siglabsoss/copper-suicide/docs/copper_suicide_notes.txt

soft start on VCCAUX (not exceed 30mV/us)

VCCIO supplies should be powered-up before or together with the VCC and VCCAUX supplies

what is the maximum current for vcc, vccaux, vccio???

---------------------
Copper Suicide R11 error
---------------------

- don't need 128 leds
- don't need 17 oscillators (~$40!!)

soft reset
hard reset
clock

config fpga needs SPI flash
