siglabsoss/copper-suicide/docs/ecp5u85pinouts.xlsx

Pin/Ball Function | Bank | Dual Function | Differential | High Speed | DQS | CABGA756
PL11A | 7 | ULC_GPLL0T_IN | True_OF_PL11B | TRUE | LDQ17 | C5
PL11B | 7 | ULC_GPLL0C_IN | Comp_OF_PL11A | TRUE | LDQ17 | D5
PL11C | 7 | - | True_OF_PL11D | - | LDQ17 | C4
PL11D | 7 | - | Comp_OF_PL11C | - | LDQ17 | C3
PL14A | 7 | - | True_OF_PL14B | TRUE | LDQ17 | D4
PL14C | 7 | - | True_OF_PL14D | - | LDQ17 | F4
PL14B | 7 | - | Comp_OF_PL14A | TRUE | LDQ17 | E4
PL14D | 7 | - | Comp_OF_PL14C | - | LDQ17 | F5
PL17A | 7 | - | True_OF_PL17B | TRUE | LDQS17 | B1
PL17C | 7 | - | True_OF_PL17D | - | LDQ17 | D3
PL17B | 7 | - | Comp_OF_PL17A | TRUE | LDQSN17 | C2
PL17D | 7 | - | Comp_OF_PL17C | - | LDQ17 | D2
PL20A | 7 | - | True_OF_PL20B | TRUE | LDQ17 | F3
PL20C | 7 | - | True_OF_PL20D | - | LDQ17 | C1
PL20B | 7 | - | Comp_OF_PL20A | TRUE | LDQ17 | E3
PL20D | 7 | - | Comp_OF_PL20C | - | LDQ17 | D1
PL23A | 7 | - | True_OF_PL23B | TRUE | LDQ29 | F2
PL23C | 7 | - | True_OF_PL23D | - | LDQ29 | F1
PL23B | 7 | - | Comp_OF_PL23A | TRUE | LDQ29 | E1
PL23D | 7 | - | Comp_OF_PL23C | - | LDQ29 | H1
PL26A | 7 | - | True_OF_PL26B | TRUE | LDQ29 | H2
PL26C | 7 | - | True_OF_PL26D | - | LDQ29 | J3
PL26B | 7 | - | Comp_OF_PL26A | TRUE | LDQ29 | H3
PL26D | 7 | - | Comp_OF_PL26C | - | LDQ29 | K3
PL29A | 7 | - | True_OF_PL29B | TRUE | LDQS29 | K2
PL29C | 7 | - | True_OF_PL29D | - | LDQ29 | K1
PL29B | 7 | - | Comp_OF_PL29A | TRUE | LDQSN29 | J1
PL29D | 7 | - | Comp_OF_PL29C | - | LDQ29 | L1
PL32A | 7 | - | True_OF_PL32B | TRUE | LDQ29 | L2
PL32C | 7 | - | True_OF_PL32D | - | LDQ29 | J4
PL32B | 7 | - | Comp_OF_PL32A | TRUE | LDQ29 | L3
PL32D | 7 | - | Comp_OF_PL32C | - | LDQ29 | K4
PL35A | 7 | - | True_OF_PL35B | TRUE | LDQ41 | H6
PL35C | 7 | VREF1_7 | True_OF_PL35D | - | LDQ41 | J7
PL35B | 7 | - | Comp_OF_PL35A | TRUE | LDQ41 | H5
PL35D | 7 | - | Comp_OF_PL35C | - | LDQ41 | J6
PL38A | 7 | - | True_OF_PL38B | TRUE | LDQ41 | K6
PL38C | 7 | - | True_OF_PL38D | - | LDQ41 | K5
PL38B | 7 | - | Comp_OF_PL38A | TRUE | LDQ41 | K7
PL38D | 7 | - | Comp_OF_PL38C | - | LDQ41 | L4
PL41A | 7 | GR_PCLK7_1 | True_OF_PL41B | TRUE | LDQS41 | N3
PL41C | 7 | GR_PCLK7_0 | True_OF_PL41D | - | LDQ41 | L7
PL41B | 7 | - | Comp_OF_PL41A | TRUE | LDQSN41 | N4
PL41D | 7 | - | Comp_OF_PL41C | - | LDQ41 | L6
PL44A | 7 | PCLKT7_1 | True_OF_PL44B | TRUE | LDQ41 | N6
PL44C | 7 | PCLKT7_0 | True_OF_PL44D | - | LDQ41 | P6
PL44B | 7 | PCLKC7_1 | Comp_OF_PL44A | TRUE | LDQ41 | N7
PL44D | 7 | PCLKC7_0 | Comp_OF_PL44C | - | LDQ41 | P7
PL47A | 6 | PCLKT6_1 | True_OF_PL47B | TRUE | LDQ53 | P5
PL47C | 6 | PCLKT6_0 | True_OF_PL47D | - | LDQ53 | R7
PL47B | 6 | PCLKC6_1 | Comp_OF_PL47A | TRUE | LDQ53 | P4
PL47D | 6 | PCLKC6_0 | Comp_OF_PL47C | - | LDQ53 | T7
PL50A | 6 | GR_PCLK6_0 | True_OF_PL50B | TRUE | LDQ53 | R6
PL50C | 6 | GR_PCLK6_1 | True_OF_PL50D | - | LDQ53 | U6
PL50B | 6 | - | Comp_OF_PL50A | TRUE | LDQ53 | T6
PL50D | 6 | - | Comp_OF_PL50C | - | LDQ53 | U7
PL53A | 6 | - | True_OF_PL53B | TRUE | LDQS53 | R4
PL53C | 6 | - | True_OF_PL53D | - | LDQ53 | T4
PL53B | 6 | - | Comp_OF_PL53A | TRUE | LDQSN53 | T5
PL53D | 6 | - | Comp_OF_PL53C | - | LDQ53 | U5
PL56A | 6 | - | True_OF_PL56B | TRUE | LDQ53 | U4
PL56C | 6 | - | True_OF_PL56D | - | LDQ53 | V6
PL56B | 6 | VREF1_6 | Comp_OF_PL56A | TRUE | LDQ53 | V4
PL56D | 6 | - | Comp_OF_PL56C | - | LDQ53 | V7
PL59A | 6 | - | True_OF_PL59B | TRUE | LDQ65 | P2
PL59C | 6 | - | True_OF_PL59D | - | LDQ65 | R3
PL59B | 6 | - | Comp_OF_PL59A | TRUE | LDQ65 | P3
PL59D | 6 | - | Comp_OF_PL59C | - | LDQ65 | T3
PL62A | 6 | - | True_OF_PL62B | TRUE | LDQ65 | N1
PL62C | 6 | - | True_OF_PL62D | - | LDQ65 | U2
PL62B | 6 | - | Comp_OF_PL62A | TRUE | LDQ65 | P1
PL62D | 6 | - | Comp_OF_PL62C | - | LDQ65 | U3
PL65A | 6 | - | True_OF_PL65B | TRUE | LDQS65 | R1
PL65C | 6 | - | True_OF_PL65D | - | LDQ65 | W3
PL65B | 6 | - | Comp_OF_PL65A | TRUE | LDQSN65 | T2
PL65D | 6 | - | Comp_OF_PL65C | - | LDQ65 | Y3
PL68A | 6 | - | True_OF_PL68B | TRUE | LDQ65 | T1
PL68C | 6 | - | True_OF_PL68D | - | LDQ65 | V1
PL68B | 6 | - | Comp_OF_PL68A | TRUE | LDQ65 | U1
PL68D | 6 | - | Comp_OF_PL68C | - | LDQ65 | W1
PL71A | 6 | - | True_OF_PL71B | TRUE | LDQ77 | Y7
PL71C | 6 | - | True_OF_PL71D | - | LDQ77 | Y5
PL71B | 6 | - | Comp_OF_PL71A | TRUE | LDQ77 | Y6
PL71D | 6 | - | Comp_OF_PL71C | - | LDQ77 | W5
PL74A | 6 | - | True_OF_PL74B | TRUE | LDQ77 | Y4
PL74C | 6 | - | True_OF_PL74D | - | LDQ77 | AB7
PL74B | 6 | - | Comp_OF_PL74A | TRUE | LDQ77 | W4
PL74D | 6 | - | Comp_OF_PL74C | - | LDQ77 | AC6
PL77A | 6 | - | True_OF_PL77B | TRUE | LDQS77 | AB5
PL77C | 6 | - | True_OF_PL77D | - | LDQ77 | AC7
PL77B | 6 | - | Comp_OF_PL77A | TRUE | LDQSN77 | AB6
PL77D | 6 | - | Comp_OF_PL77C | - | LDQ77 | AD7
PL80A | 6 | - | True_OF_PL80B | TRUE | LDQ77 | AD6
PL80C | 6 | - | True_OF_PL80D | - | LDQ77 | AE5
PL80B | 6 | - | Comp_OF_PL80A | TRUE | LDQ77 | AE6
PL80D | 6 | - | Comp_OF_PL80C | - | LDQ77 | AE4
PL83A | 6 | - | True_OF_PL83B | TRUE | LDQ89 | AB3
PL83C | 6 | - | True_OF_PL83D | - | LDQ89 | AC5
PL83B | 6 | - | Comp_OF_PL83A | TRUE | LDQ89 | AB4
PL83D | 6 | - | Comp_OF_PL83C | - | LDQ89 | AD4
PL86A | 6 | - | True_OF_PL86B | TRUE | LDQ89 | W2
PL86C | 6 | - | True_OF_PL86D | - | LDQ89 | AD3
PL86B | 6 | - | Comp_OF_PL86A | TRUE | LDQ89 | Y1
PL86D | 6 | - | Comp_OF_PL86C | - | LDQ89 | AE3
PL89A | 6 | - | True_OF_PL89B | TRUE | LDQS89 | AC3
PL89C | 6 | - | True_OF_PL89D | - | LDQ89 | AC2
PL89B | 6 | - | Comp_OF_PL89A | TRUE | LDQSN89 | AB2
PL89D | 6 | - | Comp_OF_PL89C | - | LDQ89 | AE2
PL92A | 6 | - | True_OF_PL92B | TRUE | LDQ89 | AB1
PL92B | 6 | - | Comp_OF_PL92A | TRUE | LDQ89 | AC1
PL92C | 6 | LLC_GPLL0T_IN | True_OF_PL92D | - | LDQ89 | AD1
PL92D | 6 | LLC_GPLL0C_IN | Comp_OF_PL92C | - | LDQ89 | AE1
PB4A | 8 | D7/IO7 | True_OF_PB4B | - | - | AG1
PB6A | 8 | D5/MISO2/IO5 | True_OF_PB6B | - | - | AJ1
PB4B | 8 | D6/IO6 | Comp_OF_PB4A | - | - | AH1
PB6B | 8 | D4/MOSI2/IO4 | Comp_OF_PB6A | - | - | AK1
PB9A | 8 | D3/IO3 | True_OF_PB9B | - | - | AL1
PB11A | 8 | D1/MISO/IO1 | True_OF_PB11B | - | - | AJ2
PB9B | 8 | D2/IO2 | Comp_OF_PB9A | - | - | AM2
PB11B | 8 | D0/MOSI/IO0 | Comp_OF_PB11A | - | - | AK2
PB13A | 8 | SN/CSN | True_OF_PB13B | - | - | AG3
PB15A | 8 | HOLDN/DI/BUSY/CSSPIN/CEN | True_OF_PB15B | - | - | AJ3
PB13B | 8 | CS1N | Comp_OF_PB13A | - | - | AH3
PB15B | 8 | DOUT/CSON | Comp_OF_PB15A | - | - | AK3
PB18A | 8 | WRITEN | - | - | - | AL3
INITN | 8 | - | - | - | - | AG4
CCLK | 8 | MCLK/SCK | - | - | - | AM3
PROGRAMN | 8 | - | - | - | - | AH4
DONE | 8 | - | - | - | - | AJ4
CFG_1 | 8 | - | - | - | - | AL4
CFG_2 | 8 | - | - | - | - | AK4
CFG_0 | 8 | - | - | - | - | AM4
TDO | 40 | - | - | - | - | AG5
TCK | 40 | - | - | - | - | AK5
TDI | 40 | - | - | - | - | AJ5
TMS | 40 | - | - | - | - | AM5
RESERVED | - | - | - | - | - | AK9
GND | - | - | - | - | - | AC13
RESERVED | - | - | - | - | - | AK10
GND | - | - | - | - | - | AM8
GND | - | - | - | - | - | AC14
GND | - | - | - | - | - | AM9
GND | - | - | - | - | - | AM11
GND | - | - | - | - | - | AC15
GND | - | - | - | - | - | AM12
RESERVED | - | - | - | - | - | AK12
GND | - | - | - | - | - | AC16
RESERVED | - | - | - | - | - | AK13
RESERVED | - | - | - | - | - | AK15
RESERVED | - | - | - | - | - | AK16
GND | - | - | - | - | - | AM14
GND | - | - | - | - | - | AM15
RESERVED | - | - | - | - | - | AK18
GND | - | - | - | - | - | AC17
RESERVED | - | - | - | - | - | AK19
GND | - | - | - | - | - | AM17
GND | - | - | - | - | - | AC18
GND | - | - | - | - | - | AM18
GND | - | - | - | - | - | AM20
GND | - | - | - | - | - | AC19
GND | - | - | - | - | - | AM21
RESERVED | - | - | - | - | - | AK21
GND | - | - | - | - | - | AC20
RESERVED | - | - | - | - | - | AK22
RESERVED | - | - | - | - | - | AK24
RESERVED | - | - | - | - | - | AK25
GND | - | - | - | - | - | AM23
GND | - | - | - | - | - | AM24
PB96A | 4 | - | True_OF_PB96B | - | - | AM28
PB98A | 4 | - | True_OF_PB98B | - | - | AL28
PB96B | 4 | - | Comp_OF_PB96A | - | - | AM29
PB98B | 4 | - | Comp_OF_PB98A | - | - | AK28
PB101A | 4 | - | True_OF_PB101B | - | - | AK32
PB103A | 4 | - | True_OF_PB103B | - | - | AM30
PB101B | 4 | - | Comp_OF_PB101A | - | - | AJ32
PB103B | 4 | - | Comp_OF_PB103A | - | - | AL30
PB105A | 4 | - | True_OF_PB105B | - | - | AK31
PB107A | 4 | - | True_OF_PB107B | - | - | AM31
PB105B | 4 | - | Comp_OF_PB105A | - | - | AJ31
PB107B | 4 | - | Comp_OF_PB107A | - | - | AL32
PB110A | 4 | - | True_OF_PB110B | - | - | AG28
PB112A | 4 | - | True_OF_PB112B | - | - | AJ28
PB110B | 4 | - | Comp_OF_PB110A | - | - | AG29
PB112B | 4 | - | Comp_OF_PB112A | - | - | AH28
PB114A | 4 | - | True_OF_PB114B | - | - | AH30
PB116A | 4 | - | True_OF_PB116B | - | - | AK29
PB114B | 4 | - | Comp_OF_PB114A | - | - | AG30
PB116B | 4 | - | Comp_OF_PB116A | - | - | AK30
PB119A | 4 | - | True_OF_PB119B | - | - | AH32
PB121A | 4 | - | True_OF_PB121B | - | - | AJ29
PB119B | 4 | - | Comp_OF_PB119A | - | - | AG32
PB121B | 4 | - | Comp_OF_PB121A | - | - | AJ30
PR92D | 3 | LRC_GPLL0C_IN | Comp_OF_PR92C | - | RDQ89 | AE32
PR92C | 3 | LRC_GPLL0T_IN | True_OF_PR92D | - | RDQ89 | AD32
PR92B | 3 | - | Comp_OF_PR92A | TRUE | RDQ89 | AC32
PR92A | 3 | - | True_OF_PR92B | TRUE | RDQ89 | AB32
PR89D | 3 | - | Comp_OF_PR89C | - | RDQ89 | AE31
PR89B | 3 | - | Comp_OF_PR89A | TRUE | RDQSN89 | AB31
PR89C | 3 | - | True_OF_PR89D | - | RDQ89 | AC31
PR89A | 3 | - | True_OF_PR89B | TRUE | RDQS89 | AC30
PR86D | 3 | - | Comp_OF_PR86C | - | RDQ89 | AE30
PR86B | 3 | - | Comp_OF_PR86A | TRUE | RDQ89 | Y32
PR86C | 3 | - | True_OF_PR86D | - | RDQ89 | AD30
PR86A | 3 | - | True_OF_PR86B | TRUE | RDQ89 | W31
PR83D | 3 | - | Comp_OF_PR83C | - | RDQ89 | AD29
PR83B | 3 | - | Comp_OF_PR83A | TRUE | RDQ89 | AB29
PR83C | 3 | - | True_OF_PR83D | - | RDQ89 | AC28
PR83A | 3 | - | True_OF_PR83B | TRUE | RDQ89 | AB30
PR80D | 3 | - | Comp_OF_PR80C | - | RDQ77 | AE29
PR80B | 3 | - | Comp_OF_PR80A | TRUE | RDQ77 | AE27
PR80C | 3 | - | True_OF_PR80D | - | RDQ77 | AE28
PR80A | 3 | - | True_OF_PR80B | TRUE | RDQ77 | AD27
PR77D | 3 | - | Comp_OF_PR77C | - | RDQ77 | AD26
PR77B | 3 | - | Comp_OF_PR77A | TRUE | RDQSN77 | AB27
PR77C | 3 | - | True_OF_PR77D | - | RDQ77 | AC26
PR77A | 3 | - | True_OF_PR77B | TRUE | RDQS77 | AB28
PR74D | 3 | - | Comp_OF_PR74C | - | RDQ77 | AC27
PR74B | 3 | - | Comp_OF_PR74A | TRUE | RDQ77 | W29
PR74C | 3 | - | True_OF_PR74D | - | RDQ77 | AB26
PR74A | 3 | - | True_OF_PR74B | TRUE | RDQ77 | Y29
PR71D | 3 | - | Comp_OF_PR71C | - | RDQ77 | W28
PR71B | 3 | - | Comp_OF_PR71A | TRUE | RDQ77 | Y27
PR71C | 3 | - | True_OF_PR71D | - | RDQ77 | Y28
PR71A | 3 | - | True_OF_PR71B | TRUE | RDQ77 | Y26
PR68D | 3 | - | Comp_OF_PR68C | - | RDQ65 | W32
PR68B | 3 | - | Comp_OF_PR68A | TRUE | RDQ65 | U32
PR68C | 3 | - | True_OF_PR68D | - | RDQ65 | V32
PR68A | 3 | - | True_OF_PR68B | TRUE | RDQ65 | T32
PR65D | 3 | - | Comp_OF_PR65C | - | RDQ65 | Y30
PR65B | 3 | - | Comp_OF_PR65A | TRUE | RDQSN65 | T31
PR65C | 3 | - | True_OF_PR65D | - | RDQ65 | W30
PR65A | 3 | - | True_OF_PR65B | TRUE | RDQS65 | R32
PR62D | 3 | - | Comp_OF_PR62C | - | RDQ65 | U30
PR62B | 3 | - | Comp_OF_PR62A | TRUE | RDQ65 | P32
PR62C | 3 | - | True_OF_PR62D | - | RDQ65 | U31
PR62A | 3 | - | True_OF_PR62B | TRUE | RDQ65 | N32
PR59D | 3 | - | Comp_OF_PR59C | - | RDQ65 | T30
PR59B | 3 | - | Comp_OF_PR59A | TRUE | RDQ65 | P30
PR59C | 3 | - | True_OF_PR59D | - | RDQ65 | R30
PR59A | 3 | - | True_OF_PR59B | TRUE | RDQ65 | P31
PR56D | 3 | - | Comp_OF_PR56C | - | RDQ53 | V26
PR56B | 3 | VREF1_3 | Comp_OF_PR56A | TRUE | RDQ53 | V29
PR56C | 3 | - | True_OF_PR56D | - | RDQ53 | V27
PR56A | 3 | - | True_OF_PR56B | TRUE | RDQ53 | U29
PR53D | 3 | - | Comp_OF_PR53C | - | RDQ53 | U28
PR53B | 3 | - | Comp_OF_PR53A | TRUE | RDQSN53 | T28
PR53C | 3 | - | True_OF_PR53D | - | RDQ53 | T29
PR53A | 3 | - | True_OF_PR53B | TRUE | RDQS53 | R29
PR50D | 3 | - | Comp_OF_PR50C | - | RDQ53 | U26
PR50B | 3 | - | Comp_OF_PR50A | TRUE | RDQ53 | T27
PR50C | 3 | GR_PCLK3_1 | True_OF_PR50D | - | RDQ53 | U27
PR50A | 3 | GR_PCLK3_0 | True_OF_PR50B | TRUE | RDQ53 | R27
PR47D | 3 | PCLKC3_0 | Comp_OF_PR47C | - | RDQ53 | T26
PR47B | 3 | PCLKC3_1 | Comp_OF_PR47A | TRUE | RDQ53 | P29
PR47C | 3 | PCLKT3_0 | True_OF_PR47D | - | RDQ53 | R26
PR47A | 3 | PCLKT3_1 | True_OF_PR47B | TRUE | RDQ53 | P28
PR44D | 2 | PCLKC2_0 | Comp_OF_PR44C | - | RDQ41 | P26
PR44B | 2 | PCLKC2_1 | Comp_OF_PR44A | TRUE | RDQ41 | N26
PR44C | 2 | PCLKT2_0 | True_OF_PR44D | - | RDQ41 | P27
PR44A | 2 | PCLKT2_1 | True_OF_PR44B | TRUE | RDQ41 | N27
PR41D | 2 | - | Comp_OF_PR41C | - | RDQ41 | L27
PR41B | 2 | - | Comp_OF_PR41A | TRUE | RDQSN41 | N29
PR41C | 2 | GR_PCLK2_0 | True_OF_PR41D | - | RDQ41 | L26
PR41A | 2 | GR_PCLK2_1 | True_OF_PR41B | TRUE | RDQS41 | N30
PR38D | 2 | - | Comp_OF_PR38C | - | RDQ41 | L29
PR38B | 2 | - | Comp_OF_PR38A | TRUE | RDQ41 | K26
PR38C | 2 | - | True_OF_PR38D | - | RDQ41 | K28
PR38A | 2 | - | True_OF_PR38B | TRUE | RDQ41 | K27
PR35D | 2 | - | Comp_OF_PR35C | - | RDQ41 | J27
PR35B | 2 | - | Comp_OF_PR35A | TRUE | RDQ41 | H28
PR35C | 2 | VREF1_2 | True_OF_PR35D | - | RDQ41 | J26
PR35A | 2 | - | True_OF_PR35B | TRUE | RDQ41 | H27
PR32D | 2 | - | Comp_OF_PR32C | - | RDQ29 | K29
PR32B | 2 | - | Comp_OF_PR32A | TRUE | RDQ29 | L30
PR32C | 2 | - | True_OF_PR32D | - | RDQ29 | J29
PR32A | 2 | - | True_OF_PR32B | TRUE | RDQ29 | L31
PR29D | 2 | - | Comp_OF_PR29C | - | RDQ29 | L32
PR29B | 2 | - | Comp_OF_PR29A | TRUE | RDQSN29 | J32
PR29C | 2 | - | True_OF_PR29D | - | RDQ29 | K32
PR29A | 2 | - | True_OF_PR29B | TRUE | RDQS29 | K31
PR26D | 2 | - | Comp_OF_PR26C | - | RDQ29 | K30
PR26B | 2 | - | Comp_OF_PR26A | TRUE | RDQ29 | H30
PR26C | 2 | - | True_OF_PR26D | - | RDQ29 | J30
PR26A | 2 | - | True_OF_PR26B | TRUE | RDQ29 | H31
PR23D | 2 | - | Comp_OF_PR23C | - | RDQ29 | H32
PR23B | 2 | - | Comp_OF_PR23A | TRUE | RDQ29 | E32
PR23C | 2 | - | True_OF_PR23D | - | RDQ29 | F32
PR23A | 2 | - | True_OF_PR23B | TRUE | RDQ29 | F31
PR20D | 2 | - | Comp_OF_PR20C | - | RDQ17 | D32
PR20B | 2 | - | Comp_OF_PR20A | TRUE | RDQ17 | E30
PR20C | 2 | - | True_OF_PR20D | - | RDQ17 | C32
PR20A | 2 | - | True_OF_PR20B | TRUE | RDQ17 | F30
PR17D | 2 | - | Comp_OF_PR17C | - | RDQ17 | D31
PR17B | 2 | - | Comp_OF_PR17A | TRUE | RDQSN17 | C31
PR17C | 2 | - | True_OF_PR17D | - | RDQ17 | D30
PR17A | 2 | - | True_OF_PR17B | TRUE | RDQS17 | B32
PR14D | 2 | - | Comp_OF_PR14C | - | RDQ17 | F28
PR14B | 2 | - | Comp_OF_PR14A | TRUE | RDQ17 | E29
PR14C | 2 | - | True_OF_PR14D | - | RDQ17 | F29
PR14A | 2 | - | True_OF_PR14B | TRUE | RDQ17 | D29
PR11D | 2 | - | Comp_OF_PR11C | - | RDQ17 | C30
PR11C | 2 | - | True_OF_PR11D | - | RDQ17 | C29
PR11B | 2 | URC_GPLL0C_IN | Comp_OF_PR11A | TRUE | RDQ17 | D28
PR11A | 2 | URC_GPLL0T_IN | True_OF_PR11B | TRUE | RDQ17 | C28
PT121B | 1 | URC_GPLL1C_IN | Comp_OF_PT121A | - | - | B30
VCCIO1 | - | - | - | - | - | -
PT119B | 1 | - | Comp_OF_PT119A | - | - | A31
PT121A | 1 | URC_GPLL1T_IN | True_OF_PT121B | - | - | B29
VSSIO1 | - | - | - | - | - | -
PT119A | 1 | - | True_OF_PT119B | - | - | A30
PT116B | 1 | - | Comp_OF_PT116A | - | - | A29
VSS | - | - | - | - | - | -
PT114B | 1 | - | Comp_OF_PT114A | - | - | D26
PT116A | 1 | - | True_OF_PT116B | - | - | A28
VCC | - | - | - | - | - | -
PT114A | 1 | - | True_OF_PT114B | - | - | C26
PT112B | 1 | - | Comp_OF_PT112A | - | - | B26
VSS | - | - | - | - | - | -
PT110B | 1 | - | Comp_OF_PT110A | - | - | F25
PT112A | 1 | - | True_OF_PT112B | - | - | A26
VCCAUX | - | - | - | - | - | -
PT110A | 1 | - | True_OF_PT110B | - | - | E25
PT107B | 1 | - | Comp_OF_PT107A | - | - | D25
VCCIO1 | - | - | - | - | - | -
PT105B | 1 | - | Comp_OF_PT105A | - | - | B25
PT107A | 1 | - | True_OF_PT107B | - | - | C25
VSSIO1 | - | - | - | - | - | -
PT105A | 1 | - | True_OF_PT105B | - | - | A25
PT103B | 1 | - | Comp_OF_PT103A | - | - | F24
VCCIO1 | - | - | - | - | - | -
PT101B | 1 | - | Comp_OF_PT101A | - | - | C24
PT103A | 1 | - | True_OF_PT103B | - | - | D24
VSSIO1 | - | - | - | - | - | -
PT101A | 1 | - | True_OF_PT101B | - | - | A24
PT98B | 1 | - | Comp_OF_PT98A | - | - | F23
VSS | - | - | - | - | - | -
PT96B | 1 | - | Comp_OF_PT96A | - | - | D23
PT98A | 1 | - | True_OF_PT98B | - | - | E23
VCC | - | - | - | - | - | -
PT96A | 1 | - | True_OF_PT96B | - | - | C23
PT94B | 1 | - | Comp_OF_PT94A | - | - | B23
VSS | - | - | - | - | - | -
PT92B | 1 | - | Comp_OF_PT92A | - | - | F22
PT94A | 1 | - | True_OF_PT94B | - | - | A23
VCCAUX | - | - | - | - | - | -
PT92A | 1 | - | True_OF_PT92B | - | - | E22
PT89B | 1 | - | Comp_OF_PT89A | - | - | D22
VCCIO1 | - | - | - | - | - | -
PT87B | 1 | - | Comp_OF_PT87A | - | - | B22
PT89A | 1 | - | True_OF_PT89B | - | - | C22
VSSIO1 | - | - | - | - | - | -
PT87A | 1 | - | True_OF_PT87B | - | - | A22
PT85B | 1 | - | Comp_OF_PT85A | - | - | F20
VCCIO1 | - | - | - | - | - | -
PT83B | 1 | - | Comp_OF_PT83A | - | - | C20
PT85A | 1 | - | True_OF_PT85B | - | - | D20
VSSIO1 | - | - | - | - | - | -
PT83A | 1 | - | True_OF_PT83B | - | - | A20
PT80B | 1 | - | Comp_OF_PT80A | - | - | F19
VSS | - | - | - | - | - | -
PT78B | 1 | - | Comp_OF_PT78A | - | - | D19
PT80A | 1 | - | True_OF_PT80B | - | - | E19
VCC | - | - | - | - | - | -
PT78A | 1 | - | True_OF_PT78B | - | - | C19
PT76B | 1 | - | Comp_OF_PT76A | - | - | B19
VCCIO1 | - | - | - | - | - | -
PT74B | 1 | GR_PCLK1_1 | Comp_OF_PT74A | - | - | F18
PT76A | 1 | - | True_OF_PT76B | - | - | A19
VSSIO1 | - | - | - | - | - | -
PT74A | 1 | GR_PCLK1_0 | True_OF_PT74B | - | - | D18
PT71B | 1 | PCLKC1_0 | Comp_OF_PT71A | - | - | C18
VSS | - | - | - | - | - | -
PT69B | 1 | PCLKC1_1 | Comp_OF_PT69A | - | - | F17
PT71A | 1 | PCLKT1_0 | True_OF_PT71B | - | - | A18
VCC | - | - | - | - | - | -
PT69A | 1 | PCLKT1_1 | True_OF_PT69B | - | - | E17
VSS | - | - | - | - | - | -
VCC | - | - | - | - | - | -
PT65B | 0 | PCLKC0_0 | Comp_OF_PT65A | - | - | D17
VCCIO0 | - | - | - | - | - | -
PT63B | 0 | PCLKC0_1 | Comp_OF_PT63A | - | - | B17
PT65A | 0 | PCLKT0_0 | True_OF_PT65B | - | - | C17
VSSIO0 | - | - | - | - | - | -
PT63A | 0 | PCLKT0_1 | True_OF_PT63B | - | - | A17
PT60B | 0 | GR_PCLK0_0 | Comp_OF_PT60A | - | - | A16
VSS | - | - | - | - | - | -
PT58B | 0 | - | Comp_OF_PT58A | - | - | C16
PT60A | 0 | GR_PCLK0_1 | True_OF_PT60B | - | - | B16
VCC | - | - | - | - | - | -
PT58A | 0 | - | True_OF_PT58B | - | - | D16
PT56B | 0 | - | Comp_OF_PT56A | - | - | E16
VSS | - | - | - | - | - | -
PT54B | 0 | - | Comp_OF_PT54A | - | - | A15
PT56A | 0 | - | True_OF_PT56B | - | - | F16
VCCAUX | - | - | - | - | - | -
PT54A | 0 | - | True_OF_PT54B | - | - | C15
PT51B | 0 | - | Comp_OF_PT51A | - | - | D15
VCCIO0 | - | - | - | - | - | -
PT49B | 0 | - | Comp_OF_PT49A | - | - | A14
PT51A | 0 | - | True_OF_PT51B | - | - | F15
VSSIO0 | - | - | - | - | - | -
PT49A | 0 | - | True_OF_PT49B | - | - | B14
PT47B | 0 | - | Comp_OF_PT47A | - | - | C14
VCCIO0 | - | - | - | - | - | -
PT45B | 0 | - | Comp_OF_PT45A | - | - | E14
PT47A | 0 | - | True_OF_PT47B | - | - | D14
VSSIO0 | - | - | - | - | - | -
PT45A | 0 | - | True_OF_PT45B | - | - | F14
PT42B | 0 | - | Comp_OF_PT42A | - | - | A13
VSS | - | - | - | - | - | -
PT40B | 0 | - | Comp_OF_PT40A | - | - | D13
PT42A | 0 | - | True_OF_PT42B | - | - | C13
VCC | - | - | - | - | - | -
PT40A | 0 | - | True_OF_PT40B | - | - | F13
PT38B | 0 | - | Comp_OF_PT38A | - | - | A11
VSS | - | - | - | - | - | -
PT36B | 0 | - | Comp_OF_PT36A | - | - | C11
PT38A | 0 | - | True_OF_PT38B | - | - | B11
VCCAUX | - | - | - | - | - | -
PT36A | 0 | - | True_OF_PT36B | - | - | D11
PT33B | 0 | - | Comp_OF_PT33A | - | - | E11
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
GND | - | - | - | - | - | AK8
GND | - | - | - | - | - | AL8
GND | - | - | - | - | - | AH7
GND | - | - | - | - | - | AJ7
GND | - | - | - | - | - | AK7
GND | - | - | - | - | - | AL7
GND | - | - | - | - | - | AM7
GND | - | - | - | - | - | AJ13
GND | - | - | - | - | - | AG12
GND | - | - | - | - | - | AH12
GND | - | - | - | - | - | AJ12
GND | - | - | - | - | - | AJ10
GND | - | - | - | - | - | AG9
GND | - | - | - | - | - | AH9
GND | - | - | - | - | - | AJ9
GND | - | - | - | - | - | AF22
GND | - | - | - | - | - | AG22
GND | - | - | - | - | - | AH22
GND | - | - | - | - | - | AJ22
GND | - | - | - | - | - | AJ21
GND | - | - | - | - | - | AG19
GND | - | - | - | - | - | AH19
GND | - | - | - | - | - | AJ19
GND | - | - | - | - | - | AJ18
GND | - | - | - | - | - | AJ16
GND | - | - | - | - | - | AJ15
GND | - | - | - | - | - | AJ25
GND | - | - | - | - | - | AJ24
VCCIO8 | 8 | - | - | - | - | AB10
VCCIO8 | 8 | - | - | - | - | AC10
VCCIO6 | 6 | - | - | - | - | U10
VCCIO6 | 6 | - | - | - | - | V10
VCCIO6 | 6 | - | - | - | - | W10
VCCIO6 | 6 | - | - | - | - | AA10
VCCIO7 | 7 | - | - | - | - | M10
VCCIO7 | 7 | - | - | - | - | P10
VCCIO7 | 7 | - | - | - | - | R10
VCCIO7 | 7 | - | - | - | - | T10
NC | - | - | - | - | - | AG31
NC | - | - | - | - | - | V30
NC | - | - | - | - | - | H29
NC | - | - | - | - | - | AC29
NC | - | - | - | - | - | L28
NC | - | - | - | - | - | W27
NC | - | - | - | - | - | E26
NC | - | - | - | - | - | AE26
NC | - | - | - | - | - | G24
NC | - | - | - | - | - | AG24
NC | - | - | - | - | - | G23
NC | - | - | - | - | - | G22
NC | - | - | - | - | - | G19
NC | - | - | - | - | - | G18
NC | - | - | - | - | - | G17
NC | - | - | - | - | - | G16
NC | - | - | - | - | - | G15
NC | - | - | - | - | - | G14
NC | - | - | - | - | - | G11
NC | - | - | - | - | - | G10
NC | - | - | - | - | - | G9
NC | - | - | - | - | - | E7
NC | - | - | - | - | - | AE7
NC | - | - | - | - | - | W6
NC | - | - | - | - | - | L5
NC | - | - | - | - | - | H4
NC | - | - | - | - | - | AC4
NC | - | - | - | - | - | V3
NC | - | - | - | - | - | AG2
