siglabsoss/copper-suicide/docs/copper_suicide_block_diagram_napkin.pdf

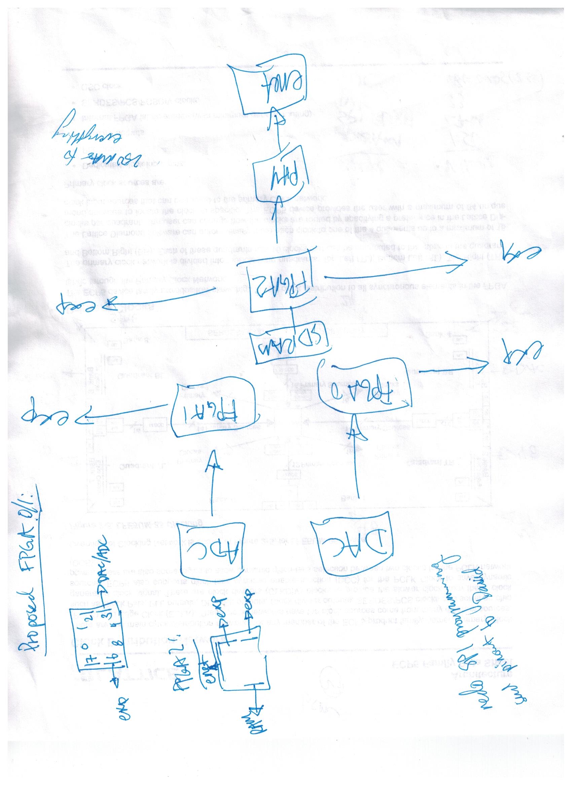
[picture p2: page 1]
