siglabsoss/copper-suicide/docs/copper_suicide_block_diagram_napkin_2.pdf

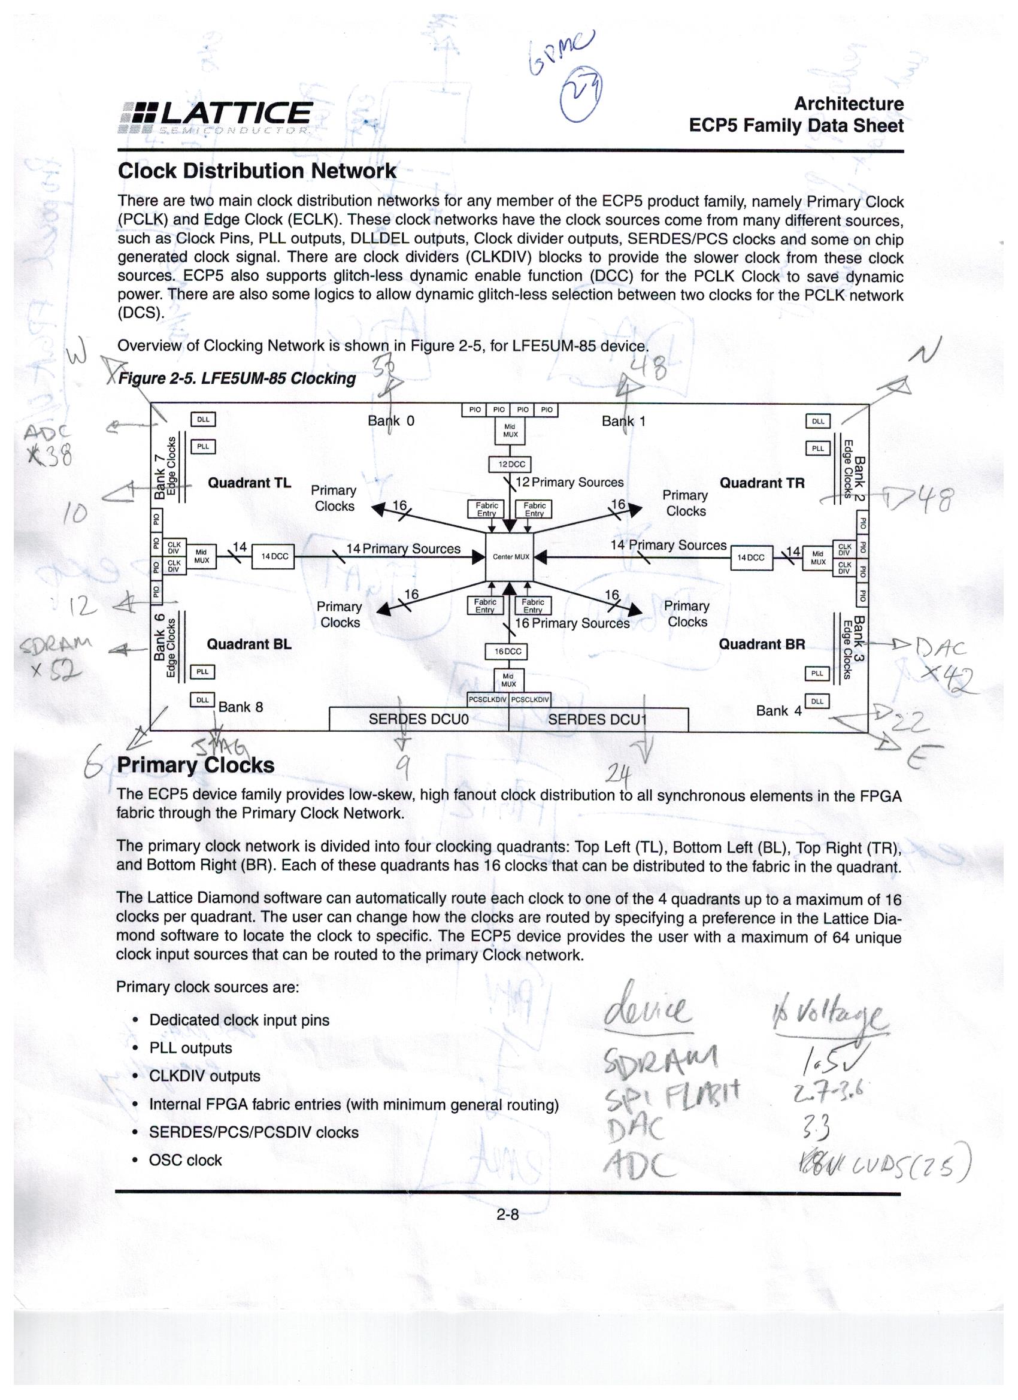
[picture p3: page 1]
