siglabsoss/copper-suicide/docs/ecp5_85_pinout.xlsx

Sheet: ECP5UM85Pinout
# Pin Out For ECP5UM-85 (WITH SERDES) |  |  |  |  |  |  |  |  |  |  | # Pin Out For ECP5U-85 (NO SERDES)
# Revision 0.1 |  |  |  |  |  |  |  |  |  |  | # Revision 0.1
# Created April 10, 2014 - Include csfBGA285, update Dual Function column. |  |  |  |  |  |  |  |  |  |  | # Created April 10, 2014 - Include csfBGA285, update Dual Function column.
Index | Pin/Ball Function | Type | Bank | Dual Function | Differential | DQS Group | caBGA756 | caBGA554 | caBGA381 | csfBGA285 |  | Index | Pin/Ball Function | Type | Bank | Dual Function | Differential | DQS Group | caBGA756 | caBGA554 | caBGA381 | csfBGA285
1 | NC1 |  |  |  |  |  | - | - | - | - | 1 | 1 | NC1 |  |  |  |  |  | - | - | - | -
2 | NC4 |  |  |  |  |  | - | - | - | - | 1 | 2 | NC4 |  |  |  |  |  | - | - | - | -
3 | NC5 |  |  |  |  |  | - | - | - | - | 1 | 3 | NC5 |  |  |  |  |  | - | - | - | -
4 | NC6 |  |  |  |  |  | - | - | - | - | 1 | 4 | NC6 |  |  |  |  |  | - | - | - | -
5 | NC7 |  |  |  |  |  | - | - | - | - | 1 | 5 | NC7 |  |  |  |  |  | - | - | - | -
6 | PL11A | IO | 7 | ULC_GPLL0T_IN | True_OF_PL11B | LDQ17 | C5 | C2 | A4 | C12 | 1 | 6 | PL11A | IO | 7 | ULC_GPLL0T_IN | True_OF_PL11B | LDQ17 | C5 | C2 | A4 | C12
7 | PL11B | IO | 7 | ULC_GPLL0C_IN | Comp_OF_PL11A | LDQ17 | D5 | C1 | A5 | B12 | 1 | 7 | PL11B | IO | 7 | ULC_GPLL0C_IN | Comp_OF_PL11A | LDQ17 | D5 | C1 | A5 | B12
8 | VSSIO7 |  |  |  |  |  | - | - | - | - | 1 | 8 | VSSIO7 |  |  |  |  |  | - | - | - | -
9 | PL11C | IO | 7 |  | True_OF_PL11D | LDQ17 | C4 | C4 | B5 | - | 1 | 9 | PL11C | IO | 7 |  | True_OF_PL11D | LDQ17 | C4 | C4 | B5 | -
10 | VCCIO7 |  |  |  |  |  | - | - | - | - | 1 | 10 | VCCIO7 |  |  |  |  |  | - | - | - | -
11 | PL11D | IO | 7 |  | Comp_OF_PL11C | LDQ17 | C3 | C3 | C5 | - | 1 | 11 | PL11D | IO | 7 |  | Comp_OF_PL11C | LDQ17 | C3 | C3 | C5 | -
12 | PL14A | IO | 7 |  | True_OF_PL14B | LDQ17 | D4 | D4 | C4 | A12 | 1 | 12 | PL14A | IO | 7 |  | True_OF_PL14B | LDQ17 | D4 | D4 | C4 | A12
13 | VCCAUX |  |  |  |  |  | - | - | - | - | 1 | 13 | VCCAUX |  |  |  |  |  | - | - | - | -
14 | PL14C | IO | 7 |  | True_OF_PL14D | LDQ17 | F4 | B1 | A3 | - | 1 | 14 | PL14C | IO | 7 |  | True_OF_PL14D | LDQ17 | F4 | B1 | A3 | -
15 | PL14B | IO | 7 |  | Comp_OF_PL14A | LDQ17 | E4 | D3 | B4 | - | 1 | 15 | PL14B | IO | 7 |  | Comp_OF_PL14A | LDQ17 | E4 | D3 | B4 | -
16 | VSS |  |  |  |  |  | - | - | - | - | 1 | 16 | VSS |  |  |  |  |  | - | - | - | -
17 | PL14D | IO | 7 |  | Comp_OF_PL14C | LDQ17 | F5 | B3 | B3 | - | 1 | 17 | PL14D | IO | 7 |  | Comp_OF_PL14C | LDQ17 | F5 | B3 | B3 | -
18 | PL17A | IO | 7 |  | True_OF_PL17B | LDQS17 | B1 | D2 | E4 | D13 | 1 | 18 | PL17A | IO | 7 |  | True_OF_PL17B | LDQS17 | B1 | D2 | E4 | D13
19 | VCC |  |  |  |  |  | - | - | - | - | 1 | 19 | VCC |  |  |  |  |  | - | - | - | -
20 | PL17C | IO | 7 |  | True_OF_PL17D | LDQ17 | D3 | E3 | C3 | - | 1 | 20 | PL17C | IO | 7 |  | True_OF_PL17D | LDQ17 | D3 | E3 | C3 | -
21 | PL17B | IO | 7 |  | Comp_OF_PL17A | LDQSN17 | C2 | E1 | D5 | C13 | 1 | 21 | PL17B | IO | 7 |  | Comp_OF_PL17A | LDQSN17 | C2 | E1 | D5 | C13
22 | VSS |  |  |  |  |  | - | - | - | - | 1 | 22 | VSS |  |  |  |  |  | - | - | - | -
23 | PL17D | IO | 7 |  | Comp_OF_PL17C | LDQ17 | D2 | D1 | D3 | - | 1 | 23 | PL17D | IO | 7 |  | Comp_OF_PL17C | LDQ17 | D2 | D1 | D3 | -
24 | PL20A | IO | 7 |  | True_OF_PL20B | LDQ17 | F3 | F2 | F4 | - | 1 | 24 | PL20A | IO | 7 |  | True_OF_PL20B | LDQ17 | F3 | F2 | F4 | -
25 | VSSIO7 |  |  |  |  |  | - | - | - | - | 1 | 25 | VSSIO7 |  |  |  |  |  | - | - | - | -
26 | PL20C | IO | 7 |  | True_OF_PL20D | LDQ17 | C1 | E4 | E5 | - | 1 | 26 | PL20C | IO | 7 |  | True_OF_PL20D | LDQ17 | C1 | E4 | E5 | -
27 | PL20B | IO | 7 |  | Comp_OF_PL20A | LDQ17 | E3 | F1 | E3 | - | 1 | 27 | PL20B | IO | 7 |  | Comp_OF_PL20A | LDQ17 | E3 | F1 | E3 | -
28 | VCCIO7 |  |  |  |  |  | - | - | - | - | 1 | 28 | VCCIO7 |  |  |  |  |  | - | - | - | -
29 | PL20D | IO | 7 |  | Comp_OF_PL20C | LDQ17 | D1 | F3 | F5 | - | 1 | 29 | PL20D | IO | 7 |  | Comp_OF_PL20C | LDQ17 | D1 | F3 | F5 | -
30 | PL23A | IO | 7 |  | True_OF_PL23B | LDQ29 | F2 | - | - | - | 1 | 30 | PL23A | IO | 7 |  | True_OF_PL23B | LDQ29 | F2 | - | - | -
31 | VSSIO7 |  |  |  |  |  | - | - | - | - | 1 | 31 | VSSIO7 |  |  |  |  |  | - | - | - | -
32 | PL23C | IO | 7 |  | True_OF_PL23D | LDQ29 | F1 | - | - | - | 1 | 32 | PL23C | IO | 7 |  | True_OF_PL23D | LDQ29 | F1 | - | - | -
33 | PL23B | IO | 7 |  | Comp_OF_PL23A | LDQ29 | E1 | - | - | - | 1 | 33 | PL23B | IO | 7 |  | Comp_OF_PL23A | LDQ29 | E1 | - | - | -
34 | VCCIO7 |  |  |  |  |  | - | - | - | - | 1 | 34 | VCCIO7 |  |  |  |  |  | - | - | - | -
35 | PL23D | IO | 7 |  | Comp_OF_PL23C | LDQ29 | H1 | - | - | - | 1 | 35 | PL23D | IO | 7 |  | Comp_OF_PL23C | LDQ29 | H1 | - | - | -
36 | PL26A | IO | 7 |  | True_OF_PL26B | LDQ29 | H2 | - | - | - | 1 | 36 | PL26A | IO | 7 |  | True_OF_PL26B | LDQ29 | H2 | - | - | -
37 | VCCAUX |  |  |  |  |  | - | - | - | - | 1 | 37 | VCCAUX |  |  |  |  |  | - | - | - | -
38 | PL26C | IO | 7 |  | True_OF_PL26D | LDQ29 | J3 | - | - | - | 1 | 38 | PL26C | IO | 7 |  | True_OF_PL26D | LDQ29 | J3 | - | - | -
39 | PL26B | IO | 7 |  | Comp_OF_PL26A | LDQ29 | H3 | - | - | - | 1 | 39 | PL26B | IO | 7 |  | Comp_OF_PL26A | LDQ29 | H3 | - | - | -
40 | VSS |  |  |  |  |  | - | - | - | - | 1 | 40 | VSS |  |  |  |  |  | - | - | - | -
41 | PL26D | IO | 7 |  | Comp_OF_PL26C | LDQ29 | K3 | - | - | - | 1 | 41 | PL26D | IO | 7 |  | Comp_OF_PL26C | LDQ29 | K3 | - | - | -
42 | PL29A | IO | 7 |  | True_OF_PL29B | LDQS29 | K2 | - | - | - | 1 | 42 | PL29A | IO | 7 |  | True_OF_PL29B | LDQS29 | K2 | - | - | -
43 | VCC |  |  |  |  |  | - | - | - | - | 1 | 43 | VCC |  |  |  |  |  | - | - | - | -
44 | PL29C | IO | 7 |  | True_OF_PL29D | LDQ29 | K1 | - | - | - | 1 | 44 | PL29C | IO | 7 |  | True_OF_PL29D | LDQ29 | K1 | - | - | -
45 | PL29B | IO | 7 |  | Comp_OF_PL29A | LDQSN29 | J1 | - | - | - | 1 | 45 | PL29B | IO | 7 |  | Comp_OF_PL29A | LDQSN29 | J1 | - | - | -
46 | VSS |  |  |  |  |  | - | - | - | - | 1 | 46 | VSS |  |  |  |  |  | - | - | - | -
47 | PL29D | IO | 7 |  | Comp_OF_PL29C | LDQ29 | L1 | - | - | - | 1 | 47 | PL29D | IO | 7 |  | Comp_OF_PL29C | LDQ29 | L1 | - | - | -
48 | PL32A | IO | 7 |  | True_OF_PL32B | LDQ29 | L2 | - | - | - | 1 | 48 | PL32A | IO | 7 |  | True_OF_PL32B | LDQ29 | L2 | - | - | -
49 | VSSIO7 |  |  |  |  |  | - | - | - | - | 1 | 49 | VSSIO7 |  |  |  |  |  | - | - | - | -
50 | PL32C | IO | 7 |  | True_OF_PL32D | LDQ29 | J4 | - | - | - | 1 | 50 | PL32C | IO | 7 |  | True_OF_PL32D | LDQ29 | J4 | - | - | -
51 | PL32B | IO | 7 |  | Comp_OF_PL32A | LDQ29 | L3 | - | - | - | 1 | 51 | PL32B | IO | 7 |  | Comp_OF_PL32A | LDQ29 | L3 | - | - | -
52 | VCCIO7 |  |  |  |  |  | - | - | - | - | 1 | 52 | VCCIO7 |  |  |  |  |  | - | - | - | -
53 | PL32D | IO | 7 |  | Comp_OF_PL32C | LDQ29 | K4 | - | - | - | 1 | 53 | PL32D | IO | 7 |  | Comp_OF_PL32C | LDQ29 | K4 | - | - | -
54 | PL35A | IO | 7 |  | True_OF_PL35B | LDQ41 | H6 | F5 | A2 | B13 | 1 | 54 | PL35A | IO | 7 |  | True_OF_PL35B | LDQ41 | H6 | F5 | A2 | B13
55 | VSSIO7 |  |  |  |  |  | - | - | - | - | 1 | 55 | VSSIO7 |  |  |  |  |  | - | - | - | -
56 | PL35C | IO | 7 | VREF1_7 | True_OF_PL35D | LDQ41 | J7 | H5 | B2 | C15 | 1 | 56 | PL35C | IO | 7 | VREF1_7 | True_OF_PL35D | LDQ41 | J7 | H5 | B2 | C15
57 | PL35B | IO | 7 |  | Comp_OF_PL35A | LDQ41 | H5 | F4 | B1 | A13 | 1 | 57 | PL35B | IO | 7 |  | Comp_OF_PL35A | LDQ41 | H5 | F4 | B1 | A13
58 | VCCIO7 |  |  |  |  |  | - | - | - | - | 1 | 58 | VCCIO7 |  |  |  |  |  | - | - | - | -
59 | PL35D | IO | 7 |  | Comp_OF_PL35C | LDQ41 | J6 | H6 | C2 | A15 | 1 | 59 | PL35D | IO | 7 |  | Comp_OF_PL35C | LDQ41 | J6 | H6 | C2 | A15
60 | PL38A | IO | 7 |  | True_OF_PL38B | LDQ41 | K6 | J6 | C1 | D15 | 1 | 60 | PL38A | IO | 7 |  | True_OF_PL38B | LDQ41 | K6 | J6 | C1 | D15
61 | VCCAUX |  |  |  |  |  | - | - | - | - | 1 | 61 | VCCAUX |  |  |  |  |  | - | - | - | -
62 | PL38C | IO | 7 |  | True_OF_PL38D | LDQ41 | K5 | H4 | D2 | - | 1 | 62 | PL38C | IO | 7 |  | True_OF_PL38D | LDQ41 | K5 | H4 | D2 | -
63 | PL38B | IO | 7 |  | Comp_OF_PL38A | LDQ41 | K7 | K6 | D1 | D16 | 1 | 63 | PL38B | IO | 7 |  | Comp_OF_PL38A | LDQ41 | K7 | K6 | D1 | D16
64 | VSS |  |  |  |  |  | - | - | - | - | 1 | 64 | VSS |  |  |  |  |  | - | - | - | -
65 | PL38D | IO | 7 |  | Comp_OF_PL38C | LDQ41 | L4 | L5 | E1 | - | 1 | 65 | PL38D | IO | 7 |  | Comp_OF_PL38C | LDQ41 | L4 | L5 | E1 | -
66 | PL41A | IO | 7 |  | True_OF_PL41B | LDQS41 | N3 | K5 | H4 | B15 | 1 | 66 | PL41A | IO | 7 |  | True_OF_PL41B | LDQS41 | N3 | K5 | H4 | B15
67 | VCC |  |  |  |  |  | - | - | - | - | 1 | 67 | VCC |  |  |  |  |  | - | - | - | -
68 | PL41C | IO | 7 |  | True_OF_PL41D | LDQ41 | L7 | M6 | H5 | C16 | 1 | 68 | PL41C | IO | 7 |  | True_OF_PL41D | LDQ41 | L7 | M6 | H5 | C16
69 | PL41B | IO | 7 |  | Comp_OF_PL41A | LDQSN41 | N4 | J4 | G5 | A16 | 1 | 69 | PL41B | IO | 7 |  | Comp_OF_PL41A | LDQSN41 | N4 | J4 | G5 | A16
70 | VSS |  |  |  |  |  | - | - | - | - | 1 | 70 | VSS |  |  |  |  |  | - | - | - | -
71 | PL41D | IO | 7 |  | Comp_OF_PL41C | LDQ41 | L6 | M4 | H3 | - | 1 | 71 | PL41D | IO | 7 |  | Comp_OF_PL41C | LDQ41 | L6 | M4 | H3 | -
72 | PL44A | IO | 7 | PCLKT7_1 | True_OF_PL44B | LDQ41 | N6 | K4 | G3 | A17 | 1 | 72 | PL44A | IO | 7 | PCLKT7_1 | True_OF_PL44B | LDQ41 | N6 | K4 | G3 | A17
73 | VSSIO7 |  |  |  |  |  | - | - | - | - | 1 | 73 | VSSIO7 |  |  |  |  |  | - | - | - | -
74 | PL44C | IO | 7 | PCLKT7_0 | True_OF_PL44D | LDQ41 | P6 | N6 | F2 | B18 | 1 | 74 | PL44C | IO | 7 | PCLKT7_0 | True_OF_PL44D | LDQ41 | P6 | N6 | F2 | B18
75 | PL44B | IO | 7 | PCLKC7_1 | Comp_OF_PL44A | LDQ41 | N7 | L4 | F3 | B17 | 1 | 75 | PL44B | IO | 7 | PCLKC7_1 | Comp_OF_PL44A | LDQ41 | N7 | L4 | F3 | B17
76 | VCCIO7 |  |  |  |  |  | - | - | - | - | 1 | 76 | VCCIO7 |  |  |  |  |  | - | - | - | -
77 | PL44D | IO | 7 | PCLKC7_0 | Comp_OF_PL44C | LDQ41 | P7 | N5 | E2 | C17 | 1 | 77 | PL44D | IO | 7 | PCLKC7_0 | Comp_OF_PL44C | LDQ41 | P7 | N5 | E2 | C17
78 | PL47A | IO | 6 | PCLKT6_1 | True_OF_PL47B | LDQ53 | P5 | H3 | G2 | D17 | 1 | 78 | PL47A | IO | 6 | PCLKT6_1 | True_OF_PL47B | LDQ53 | P5 | H3 | G2 | D17
79 | VSSIO6 |  |  |  |  |  | - | - | - | - | 1 | 79 | VSSIO6 |  |  |  |  |  | - | - | - | -
80 | PL47C | IO | 6 | PCLKT6_0 | True_OF_PL47D | LDQ53 | R7 | H2 | H2 | D18 | 1 | 80 | PL47C | IO | 6 | PCLKT6_0 | True_OF_PL47D | LDQ53 | R7 | H2 | H2 | D18
81 | PL47B | IO | 6 | PCLKC6_1 | Comp_OF_PL47A | LDQ53 | P4 | J3 | F1 | C18 | 1 | 81 | PL47B | IO | 6 | PCLKC6_1 | Comp_OF_PL47A | LDQ53 | P4 | J3 | F1 | C18
82 | VCCIO6 |  |  |  |  |  | - | - | - | - | 1 | 82 | VCCIO6 |  |  |  |  |  | - | - | - | -
83 | PL47D | IO | 6 | PCLKC6_0 | Comp_OF_PL47C | LDQ53 | T7 | H1 | G1 | F18 | 1 | 83 | PL47D | IO | 6 | PCLKC6_0 | Comp_OF_PL47C | LDQ53 | T7 | H1 | G1 | F18
84 | PL50A | IO | 6 |  | True_OF_PL50B | LDQ53 | R6 | K2 | J4 | F17 | 1 | 84 | PL50A | IO | 6 |  | True_OF_PL50B | LDQ53 | R6 | K2 | J4 | F17
85 | VCCAUX |  |  |  |  |  | - | - | - | - | 1 | 85 | VCCAUX |  |  |  |  |  | - | - | - | -
86 | PL50C | IO | 6 |  | True_OF_PL50D | LDQ53 | U6 | K3 | J3 | F15 | 1 | 86 | PL50C | IO | 6 |  | True_OF_PL50D | LDQ53 | U6 | K3 | J3 | F15
87 | PL50B | IO | 6 |  | Comp_OF_PL50A | LDQ53 | T6 | J1 | J5 | F16 | 1 | 87 | PL50B | IO | 6 |  | Comp_OF_PL50A | LDQ53 | T6 | J1 | J5 | F16
88 | VSS |  |  |  |  |  | - | - | - | - | 1 | 88 | VSS |  |  |  |  |  | - | - | - | -
89 | PL50D | IO | 6 |  | Comp_OF_PL50C | LDQ53 | U7 | L3 | K3 | G16 | 1 | 89 | PL50D | IO | 6 |  | Comp_OF_PL50C | LDQ53 | U7 | L3 | K3 | G16
90 | PL53A | IO | 6 |  | True_OF_PL53B | LDQS53 | R4 | L2 | K2 | G18 | 1 | 90 | PL53A | IO | 6 |  | True_OF_PL53B | LDQS53 | R4 | L2 | K2 | G18
91 | VCC |  |  |  |  |  | - | - | - | - | 1 | 91 | VCC |  |  |  |  |  | - | - | - | -
92 | PL53C | IO | 6 |  | True_OF_PL53D | LDQ53 | T4 | K1 | H1 | - | 1 | 92 | PL53C | IO | 6 |  | True_OF_PL53D | LDQ53 | T4 | K1 | H1 | -
93 | PL53B | IO | 6 |  | Comp_OF_PL53A | LDQSN53 | T5 | M1 | J1 | H17 | 1 | 93 | PL53B | IO | 6 |  | Comp_OF_PL53A | LDQSN53 | T5 | M1 | J1 | H17
94 | VSS |  |  |  |  |  | - | - | - | - | 1 | 94 | VSS |  |  |  |  |  | - | - | - | -
95 | PL53D | IO | 6 |  | Comp_OF_PL53C | LDQ53 | U5 | L1 | K1 | - | 1 | 95 | PL53D | IO | 6 |  | Comp_OF_PL53C | LDQ53 | U5 | L1 | K1 | -
96 | PL56A | IO | 6 |  | True_OF_PL56B | LDQ53 | U4 | N1 | K4 | G15 | 1 | 96 | PL56A | IO | 6 |  | True_OF_PL56B | LDQ53 | U4 | N1 | K4 | G15
97 | VSSIO6 |  |  |  |  |  | - | - | - | - | 1 | 97 | VSSIO6 |  |  |  |  |  | - | - | - | -
98 | PL56C | IO | 6 |  | True_OF_PL56D | LDQ53 | V6 | N3 | L4 | H16 | 1 | 98 | PL56C | IO | 6 |  | True_OF_PL56D | LDQ53 | V6 | N3 | L4 | H16
99 | PL56B | IO | 6 | VREF1_6 | Comp_OF_PL56A | LDQ53 | V4 | N2 | K5 | H15 | 1 | 99 | PL56B | IO | 6 | VREF1_6 | Comp_OF_PL56A | LDQ53 | V4 | N2 | K5 | H15
100 | VCCIO6 |  |  |  |  |  | - | - | - | - | 1 | 100 | VCCIO6 |  |  |  |  |  | - | - | - | -
101 | PL56D | IO | 6 |  | Comp_OF_PL56C | LDQ53 | V7 | M3 | L5 | J16 | 1 | 101 | PL56D | IO | 6 |  | Comp_OF_PL56C | LDQ53 | V7 | M3 | L5 | J16
102 | PL59A | IO | 6 |  | True_OF_PL59B | LDQ65 | P2 | - | - | - | 1 | 102 | PL59A | IO | 6 |  | True_OF_PL59B | LDQ65 | P2 | - | - | -
103 | VSSIO6 |  |  |  |  |  | - | - | - | - | 1 | 103 | VSSIO6 |  |  |  |  |  | - | - | - | -
104 | PL59C | IO | 6 |  | True_OF_PL59D | LDQ65 | R3 | - | - | - | 1 | 104 | PL59C | IO | 6 |  | True_OF_PL59D | LDQ65 | R3 | - | - | -
105 | PL59B | IO | 6 |  | Comp_OF_PL59A | LDQ65 | P3 | - | - | - | 1 | 105 | PL59B | IO | 6 |  | Comp_OF_PL59A | LDQ65 | P3 | - | - | -
106 | VCCIO6 |  |  |  |  |  | - | - | - | - | 1 | 106 | VCCIO6 |  |  |  |  |  | - | - | - | -
107 | PL59D | IO | 6 |  | Comp_OF_PL59C | LDQ65 | T3 | - | - | - | 1 | 107 | PL59D | IO | 6 |  | Comp_OF_PL59C | LDQ65 | T3 | - | - | -
108 | PL62A | IO | 6 |  | True_OF_PL62B | LDQ65 | N1 | - | - | - | 1 | 108 | PL62A | IO | 6 |  | True_OF_PL62B | LDQ65 | N1 | - | - | -
109 | VCCAUX |  |  |  |  |  | - | - | - | - | 1 | 109 | VCCAUX |  |  |  |  |  | - | - | - | -
110 | PL62C | IO | 6 |  | True_OF_PL62D | LDQ65 | U2 | - | - | - | 1 | 110 | PL62C | IO | 6 |  | True_OF_PL62D | LDQ65 | U2 | - | - | -
111 | PL62B | IO | 6 |  | Comp_OF_PL62A | LDQ65 | P1 | - | - | - | 1 | 111 | PL62B | IO | 6 |  | Comp_OF_PL62A | LDQ65 | P1 | - | - | -
112 | VSS |  |  |  |  |  | - | - | - | - | 1 | 112 | VSS |  |  |  |  |  | - | - | - | -
113 | PL62D | IO | 6 |  | Comp_OF_PL62C | LDQ65 | U3 | - | - | - | 1 | 113 | PL62D | IO | 6 |  | Comp_OF_PL62C | LDQ65 | U3 | - | - | -
114 | PL65A | IO | 6 |  | True_OF_PL65B | LDQS65 | R1 | - | - | - | 1 | 114 | PL65A | IO | 6 |  | True_OF_PL65B | LDQS65 | R1 | - | - | -
115 | VCC |  |  |  |  |  | - | - | - | - | 1 | 115 | VCC |  |  |  |  |  | - | - | - | -
116 | PL65C | IO | 6 |  | True_OF_PL65D | LDQ65 | W3 | - | - | - | 1 | 116 | PL65C | IO | 6 |  | True_OF_PL65D | LDQ65 | W3 | - | - | -
117 | PL65B | IO | 6 |  | Comp_OF_PL65A | LDQSN65 | T2 | - | - | - | 1 | 117 | PL65B | IO | 6 |  | Comp_OF_PL65A | LDQSN65 | T2 | - | - | -
118 | VSS |  |  |  |  |  | - | - | - | - | 1 | 118 | VSS |  |  |  |  |  | - | - | - | -
119 | PL65D | IO | 6 |  | Comp_OF_PL65C | LDQ65 | Y3 | - | - | - | 1 | 119 | PL65D | IO | 6 |  | Comp_OF_PL65C | LDQ65 | Y3 | - | - | -
120 | PL68A | IO | 6 |  | True_OF_PL68B | LDQ65 | T1 | - | - | - | 1 | 120 | PL68A | IO | 6 |  | True_OF_PL68B | LDQ65 | T1 | - | - | -
121 | VSSIO6 |  |  |  |  |  | - | - | - | - | 1 | 121 | VSSIO6 |  |  |  |  |  | - | - | - | -
122 | PL68C | IO | 6 |  | True_OF_PL68D | LDQ65 | V1 | - | - | - | 1 | 122 | PL68C | IO | 6 |  | True_OF_PL68D | LDQ65 | V1 | - | - | -
123 | PL68B | IO | 6 |  | Comp_OF_PL68A | LDQ65 | U1 | - | - | - | 1 | 123 | PL68B | IO | 6 |  | Comp_OF_PL68A | LDQ65 | U1 | - | - | -
124 | VCCIO6 |  |  |  |  |  | - | - | - | - | 1 | 124 | VCCIO6 |  |  |  |  |  | - | - | - | -
125 | PL68D | IO | 6 |  | Comp_OF_PL68C | LDQ65 | W1 | - | - | - | 1 | 125 | PL68D | IO | 6 |  | Comp_OF_PL68C | LDQ65 | W1 | - | - | -
126 | PL71A | IO | 6 |  | True_OF_PL71B | LDQ77 | Y7 | P4 | - | - | 1 | 126 | PL71A | IO | 6 |  | True_OF_PL71B | LDQ77 | Y7 | P4 | - | -
127 | VSSIO6 |  |  |  |  |  | - | - | - | - | 1 | 127 | VSSIO6 |  |  |  |  |  | - | - | - | -
128 | PL71C | IO | 6 |  | True_OF_PL71D | LDQ77 | Y5 | P6 | - | - | 1 | 128 | PL71C | IO | 6 |  | True_OF_PL71D | LDQ77 | Y5 | P6 | - | -
129 | PL71B | IO | 6 |  | Comp_OF_PL71A | LDQ77 | Y6 | P5 | - | - | 1 | 129 | PL71B | IO | 6 |  | Comp_OF_PL71A | LDQ77 | Y6 | P5 | - | -
130 | VCCIO6 |  |  |  |  |  | - | - | - | - | 1 | 130 | VCCIO6 |  |  |  |  |  | - | - | - | -
131 | PL71D | IO | 6 |  | Comp_OF_PL71C | LDQ77 | W5 | N4 | - | - | 1 | 131 | PL71D | IO | 6 |  | Comp_OF_PL71C | LDQ77 | W5 | N4 | - | -
132 | PL74A | IO | 6 |  | True_OF_PL74B | LDQ77 | Y4 | R4 | - | - | 1 | 132 | PL74A | IO | 6 |  | True_OF_PL74B | LDQ77 | Y4 | R4 | - | -
133 | VCCAUX |  |  |  |  |  | - | - | - | - | 1 | 133 | VCCAUX |  |  |  |  |  | - | - | - | -
134 | PL74C | IO | 6 |  | True_OF_PL74D | LDQ77 | AB7 | R6 | - | - | 1 | 134 | PL74C | IO | 6 |  | True_OF_PL74D | LDQ77 | AB7 | R6 | - | -
135 | PL74B | IO | 6 |  | Comp_OF_PL74A | LDQ77 | W4 | T5 | - | - | 1 | 135 | PL74B | IO | 6 |  | Comp_OF_PL74A | LDQ77 | W4 | T5 | - | -
136 | VSS |  |  |  |  |  | - | - | - | - | 1 | 136 | VSS |  |  |  |  |  | - | - | - | -
137 | PL74D | IO | 6 |  | Comp_OF_PL74C | LDQ77 | AC6 | T4 | - | - | 1 | 137 | PL74D | IO | 6 |  | Comp_OF_PL74C | LDQ77 | AC6 | T4 | - | -
138 | PL77A | IO | 6 |  | True_OF_PL77B | LDQS77 | AB5 | V4 | M5 | - | 1 | 138 | PL77A | IO | 6 |  | True_OF_PL77B | LDQS77 | AB5 | V4 | M5 | -
139 | VCC |  |  |  |  |  | - | - | - | - | 1 | 139 | VCC |  |  |  |  |  | - | - | - | -
140 | PL77C | IO | 6 |  | True_OF_PL77D | LDQ77 | AC7 | U6 | - | - | 1 | 140 | PL77C | IO | 6 |  | True_OF_PL77D | LDQ77 | AC7 | U6 | - | -
141 | PL77B | IO | 6 |  | Comp_OF_PL77A | LDQSN77 | AB6 | U5 | - | - | 1 | 141 | PL77B | IO | 6 |  | Comp_OF_PL77A | LDQSN77 | AB6 | U5 | - | -
142 | VSS |  |  |  |  |  | - | - | - | - | 1 | 142 | VSS |  |  |  |  |  | - | - | - | -
143 | PL77D | IO | 6 |  | Comp_OF_PL77C | LDQ77 | AD7 | U4 | - | - | 1 | 143 | PL77D | IO | 6 |  | Comp_OF_PL77C | LDQ77 | AD7 | U4 | - | -
144 | PL80A | IO | 6 |  | True_OF_PL80B | LDQ77 | AD6 | W4 | - | - | 1 | 144 | PL80A | IO | 6 |  | True_OF_PL80B | LDQ77 | AD6 | W4 | - | -
145 | VSSIO6 |  |  |  |  |  | - | - | - | - | 1 | 145 | VSSIO6 |  |  |  |  |  | - | - | - | -
146 | PL80C | IO | 6 |  | True_OF_PL80D | LDQ77 | AE5 | W5 | - | - | 1 | 146 | PL80C | IO | 6 |  | True_OF_PL80D | LDQ77 | AE5 | W5 | - | -
147 | PL80B | IO | 6 |  | Comp_OF_PL80A | LDQ77 | AE6 | V6 | - | - | 1 | 147 | PL80B | IO | 6 |  | Comp_OF_PL80A | LDQ77 | AE6 | V6 | - | -
148 | VCCIO6 |  |  |  |  |  | - | - | - | - | 1 | 148 | VCCIO6 |  |  |  |  |  | - | - | - | -
149 | PL80D | IO | 6 |  | Comp_OF_PL80C | LDQ77 | AE4 | W6 | - | - | 1 | 149 | PL80D | IO | 6 |  | Comp_OF_PL80C | LDQ77 | AE4 | W6 | - | -
150 | PL83A | IO | 6 |  | True_OF_PL83B | LDQ89 | AB3 | T3 | M4 | - | 1 | 150 | PL83A | IO | 6 |  | True_OF_PL83B | LDQ89 | AB3 | T3 | M4 | -
151 | VSSIO6 |  |  |  |  |  | - | - | - | - | 1 | 151 | VSSIO6 |  |  |  |  |  | - | - | - | -
152 | PL83C | IO | 6 |  | True_OF_PL83D | LDQ89 | AC5 | R3 | N4 | J17 | 1 | 152 | PL83C | IO | 6 |  | True_OF_PL83D | LDQ89 | AC5 | R3 | N4 | J17
153 | PL83B | IO | 6 |  | Comp_OF_PL83A | LDQ89 | AB4 | U3 | N5 | - | 1 | 153 | PL83B | IO | 6 |  | Comp_OF_PL83A | LDQ89 | AB4 | U3 | N5 | -
154 | VCCIO6 |  |  |  |  |  | - | - | - | - | 1 | 154 | VCCIO6 |  |  |  |  |  | - | - | - | -
155 | PL83D | IO | 6 |  | Comp_OF_PL83C | LDQ89 | AD4 | P3 | P5 | H18 | 1 | 155 | PL83D | IO | 6 |  | Comp_OF_PL83C | LDQ89 | AD4 | P3 | P5 | H18
156 | PL86A | IO | 6 |  | True_OF_PL86B | LDQ89 | W2 | P2 | N3 | J18 | 1 | 156 | PL86A | IO | 6 |  | True_OF_PL86B | LDQ89 | W2 | P2 | N3 | J18
157 | VCCAUX |  |  |  |  |  | - | - | - | - | 1 | 157 | VCCAUX |  |  |  |  |  | - | - | - | -
158 | PL86C | IO | 6 |  | True_OF_PL86D | LDQ89 | AD3 | T2 | L3 | K16 | 1 | 158 | PL86C | IO | 6 |  | True_OF_PL86D | LDQ89 | AD3 | T2 | L3 | K16
159 | PL86B | IO | 6 |  | Comp_OF_PL86A | LDQ89 | Y1 | P1 | M3 | K18 | 1 | 159 | PL86B | IO | 6 |  | Comp_OF_PL86A | LDQ89 | Y1 | P1 | M3 | K18
160 | VSS |  |  |  |  |  | - | - | - | - | 1 | 160 | VSS |  |  |  |  |  | - | - | - | -
161 | PL86D | IO | 6 |  | Comp_OF_PL86C | LDQ89 | AE3 | R1 | L2 | K15 | 1 | 161 | PL86D | IO | 6 |  | Comp_OF_PL86C | LDQ89 | AE3 | R1 | L2 | K15
162 | PL89A | IO | 6 | LLC_GPLL0T_MFGOUT2 | True_OF_PL89B | LDQS89 | AC3 | V1 | N2 | K17 | 1 | 162 | PL89A | IO | 6 | LLC_GPLL0T_MFGOUT2 | True_OF_PL89B | LDQS89 | AC3 | V1 | N2 | K17
163 | VCC |  |  |  |  |  | - | - | - | - | 1 | 163 | VCC |  |  |  |  |  | - | - | - | -
164 | PL89C | IO | 6 |  | True_OF_PL89D | LDQ89 | AC2 | U1 | L1 | L15 | 1 | 164 | PL89C | IO | 6 |  | True_OF_PL89D | LDQ89 | AC2 | U1 | L1 | L15
165 | PL89B | IO | 6 | LLC_GPLL0C_MFGOUT2 | Comp_OF_PL89A | LDQSN89 | AB2 | U2 | M1 | L18 | 1 | 165 | PL89B | IO | 6 | LLC_GPLL0C_MFGOUT2 | Comp_OF_PL89A | LDQSN89 | AB2 | U2 | M1 | L18
166 | VSS |  |  |  |  |  | - | - | - | - | 1 | 166 | VSS |  |  |  |  |  | - | - | - | -
167 | PL89D | IO | 6 |  | Comp_OF_PL89C | LDQ89 | AE2 | T1 | N1 | L16 | 1 | 167 | PL89D | IO | 6 |  | Comp_OF_PL89C | LDQ89 | AE2 | T1 | N1 | L16
168 | PL92A | IO | 6 | LLC_GPLL0T_MFGOUT1 | True_OF_PL92B | LDQ89 | AB1 | V3 | P1 | - | 1 | 168 | PL92A | IO | 6 | LLC_GPLL0T_MFGOUT1 | True_OF_PL92B | LDQ89 | AB1 | V3 | P1 | -
169 | VSSIO6 |  |  |  |  |  | - | - | - | - | 1 | 169 | VSSIO6 |  |  |  |  |  | - | - | - | -
170 | PL92B | IO | 6 | LLC_GPLL0C_MFGOUT1 | Comp_OF_PL92A | LDQ89 | AC1 | W1 | P2 | - | 1 | 170 | PL92B | IO | 6 | LLC_GPLL0C_MFGOUT1 | Comp_OF_PL92A | LDQ89 | AC1 | W1 | P2 | -
171 | VCCIO6 |  |  |  |  |  | - | - | - | - | 1 | 171 | VCCIO6 |  |  |  |  |  | - | - | - | -
172 | PL92C | IO | 6 | LLC_GPLL0T_IN | True_OF_PL92D | LDQ89 | AD1 | W2 | P3 | M16 | 1 | 172 | PL92C | IO | 6 | LLC_GPLL0T_IN | True_OF_PL92D | LDQ89 | AD1 | W2 | P3 | M16
173 | PL92D | IO | 6 | LLC_GPLL0C_IN | Comp_OF_PL92C | LDQ89 | AE1 | W3 | P4 | M17 | 1 | 173 | PL92D | IO | 6 | LLC_GPLL0C_IN | Comp_OF_PL92C | LDQ89 | AE1 | W3 | P4 | M17
174 | NC_VCCM |  |  |  |  |  | - | - | - | - | 1 | 174 | NC_VCCM |  |  |  |  |  | - | - | - | -
175 | NC_POR |  |  |  |  |  | - | - | - | - | 1 | 175 | NC_POR |  |  |  |  |  | - | - | - | -
176 | VSSPLL0_LLC |  |  |  |  |  | - | - | - | - | 1 | 176 | VSSPLL0_LLC |  |  |  |  |  | - | - | - | -
177 | VCCPLL0_LLC |  |  |  |  |  | - | - | - | - | 1 | 177 | VCCPLL0_LLC |  |  |  |  |  | - | - | - | -
178 | VCC |  |  |  |  |  | - | - | - | - | 1 | 178 | VCC |  |  |  |  |  | - | - | - | -
179 | VSS |  |  |  |  |  | - | - | - | - | 1 | 179 | VSS |  |  |  |  |  | - | - | - | -
180 | PB4A | IO | 8 | D7 | True_OF_PB4B |  | AG1 | AA1 | R1 | N15 | 1 | 180 | PB4A | IO | 8 | D7 | True_OF_PB4B |  | AG1 | AA1 | R1 | N15
181 | PB6A | IO | 8 | D5 | True_OF_PB6B |  | AJ1 | AC1 | U1 | N17 | 1 | 181 | PB6A | IO | 8 | D5 | True_OF_PB6B |  | AJ1 | AC1 | U1 | N17
182 | VCC |  |  |  |  |  | - | - | - | - | 1 | 182 | VCC |  |  |  |  |  | - | - | - | -
183 | PB4B | IO | 8 | D6 | Comp_OF_PB4A |  | AH1 | AB1 | T1 | N16 | 1 | 183 | PB4B | IO | 8 | D6 | Comp_OF_PB4A |  | AH1 | AB1 | T1 | N16
184 | PB6B | IO | 8 | D4 | Comp_OF_PB6A |  | AK1 | AD1 | V1 | M18 | 1 | 184 | PB6B | IO | 8 | D4 | Comp_OF_PB6A |  | AK1 | AD1 | V1 | M18
185 | VSS |  |  |  |  |  | - | - | - | - | 1 | 185 | VSS |  |  |  |  |  | - | - | - | -
186 | PB9A | IO | 8 | D3/IO3 | True_OF_PB9B |  | AL1 | AE1 | W1 | N18 | 1 | 186 | PB9A | IO | 8 | D3/IO3 | True_OF_PB9B |  | AL1 | AE1 | W1 | N18
187 | PB11A | IO | 8 | D1/MISO/IO1 | True_OF_PB11B |  | AJ2 | AD2 | V2 | T18 | 1 | 187 | PB11A | IO | 8 | D1/MISO/IO1 | True_OF_PB11B |  | AJ2 | AD2 | V2 | T18
188 | VSSIO8 |  |  |  |  |  | - | - | - | - | 1 | 188 | VSSIO8 |  |  |  |  |  | - | - | - | -
189 | PB9B | IO | 8 | D2/IO2 | Comp_OF_PB9A |  | AM2 | AF2 | Y2 | R18 | 1 | 189 | PB9B | IO | 8 | D2/IO2 | Comp_OF_PB9A |  | AM2 | AF2 | Y2 | R18
190 | PB11B | IO | 8 | D0/MOSI/IO0 | Comp_OF_PB11A |  | AK2 | AE2 | W2 | U18 | 1 | 190 | PB11B | IO | 8 | D0/MOSI/IO0 | Comp_OF_PB11A |  | AK2 | AE2 | W2 | U18
191 | VCCIO8 |  |  |  |  |  | - | - | - | - | 1 | 191 | VCCIO8 |  |  |  |  |  | - | - | - | -
192 | PB13A | IO | 8 | SN/CSN | True_OF_PB13B |  | AG3 | AB2 | T2 | R17 | 1 | 192 | PB13A | IO | 8 | SN/CSN | True_OF_PB13B |  | AG3 | AB2 | T2 | R17
193 | PB15A | IO | 8 | HOLDN/DI/BUSY/CSSPIN/CEN | True_OF_PB15B |  | AJ3 | AA2 | R2 | U17 | 1 | 193 | PB15A | IO | 8 | HOLDN/DI/BUSY/CSSPIN/CEN | True_OF_PB15B |  | AJ3 | AA2 | R2 | U17
194 | VSSIO8 |  |  |  |  |  | - | - | - | - | 1 | 194 | VSSIO8 |  |  |  |  |  | - | - | - | -
195 | PB13B | IO | 8 | CS1N | Comp_OF_PB13A |  | AH3 | AC2 | U2 | T17 | 1 | 195 | PB13B | IO | 8 | CS1N | Comp_OF_PB13A |  | AH3 | AC2 | U2 | T17
196 | PB15B | IO | 8 | DOUT/CSON | Comp_OF_PB15A |  | AK3 | AB3 | R3 | V17 | 1 | 196 | PB15B | IO | 8 | DOUT/CSON | Comp_OF_PB15A |  | AK3 | AB3 | R3 | V17
197 | VCCIO8 |  |  |  |  |  | - | - | - | - | 1 | 197 | VCCIO8 |  |  |  |  |  | - | - | - | -
198 | PB18A | IO | 8 | WRITEN |  |  | AL3 | AD3 | T3 | R16 | 1 | 198 | PB18A | IO | 8 | WRITEN |  |  | AL3 | AD3 | T3 | R16
199 | INITN | IO | 8 |  |  |  | AG4 | AF3 | V3 | V16 | 1 | 199 | INITN | IO | 8 |  |  |  | AG4 | AF3 | V3 | V16
200 | VCCAUX |  |  |  |  |  | - | - | - | - | 1 | 200 | VCCAUX |  |  |  |  |  | - | - | - | -
201 | CCLK | IO | 8 | MCLK/SCK |  |  | AM3 | AE3 | U3 | U16 | 1 | 201 | CCLK | IO | 8 | MCLK/SCK |  |  | AM3 | AE3 | U3 | U16
202 | PROGRAMN | I | 8 |  |  |  | AH4 | AB4 | W3 | T15 | 1 | 202 | PROGRAMN | I | 8 |  |  |  | AH4 | AB4 | W3 | T15
203 | VSS |  |  |  |  |  | - | - | - | - | 1 | 203 | VSS |  |  |  |  |  | - | - | - | -
204 | DONE | IO | 8 |  |  |  | AJ4 | AC4 | Y3 | U15 | 1 | 204 | DONE | IO | 8 |  |  |  | AJ4 | AC4 | Y3 | U15
205 | CFG_1 | I | 8 |  |  |  | AL4 | AE4 | T4 | T14 | 1 | 205 | CFG_1 | I | 8 |  |  |  | AL4 | AE4 | T4 | T14
206 | VCC |  |  |  |  |  | - | - | - | - | 1 | 206 | VCC |  |  |  |  |  | - | - | - | -
207 | CFG_2 | I | 8 |  |  |  | AK4 | AD4 | R4 | V15 | 1 | 207 | CFG_2 | I | 8 |  |  |  | AK4 | AD4 | R4 | V15
208 | CFG_0 | I | 8 |  |  |  | AM4 | AF4 | U4 | U14 | 1 | 208 | CFG_0 | I | 8 |  |  |  | AM4 | AF4 | U4 | U14
209 | VSS |  |  |  |  |  | - | - | - | - | 1 | 209 | VSS |  |  |  |  |  | - | - | - | -
210 | TDO | O | 8 |  |  |  | AG5 | AB5 | V4 | V14 | 1 | 210 | TDO | O | 8 |  |  |  | AG5 | AB5 | V4 | V14
211 | TCK | I | 8 |  |  |  | AK5 | AD5 | T5 | U13 | 1 | 211 | TCK | I | 8 |  |  |  | AK5 | AD5 | T5 | U13
212 | VSSIO8 |  |  |  |  |  | - | - | - | - | 1 | 212 | VSSIO8 |  |  |  |  |  | - | - | - | -
213 | TDI | I | 8 |  |  |  | AJ5 | AC5 | R5 | T13 | 1 | 213 | TDI | I | 8 |  |  |  | AJ5 | AC5 | R5 | T13
214 | TMS | I | 8 |  |  |  | AM5 | AE5 | U5 | V13 | 1 | 214 | TMS | I | 8 |  |  |  | AM5 | AE5 | U5 | V13
215 | VCCIO8 |  |  |  |  |  | - | - | - | - | 1 | 215 | VCCIO8 |  |  |  |  |  | - | - | - | -
216 | VCC |  |  |  |  |  | - | - | - | - | 1 | 216 | VCC |  |  |  |  |  | - | - | - | -
217 | VCC |  |  |  |  |  | - | - | - | - | 1 | 217 | VCC |  |  |  |  |  | - | - | - | -
218 | VSS |  |  |  |  |  | - | - | - | - | 1 | 218 | VSS |  |  |  |  |  | - | - | - | -
219 | VSS |  |  |  |  |  | - | - | - | - | 1 | 219 | VSS |  |  |  |  |  | - | - | - | -
220 | VCC |  |  |  |  |  | - | - | - | - | 1 | 220 | VCC |  |  |  |  |  | - | - | - | -
221 | VCC |  |  |  |  |  | - | - | - | - | 1 | 221 | VCC |  |  |  |  |  | - | - | - | -
222 | VSSA0_D0CH0 |  |  |  |  |  | - | - | - | - | 0 | 222 | VSS |  |  |  |  |  | - | - | - | -
223 | VCCATX0_D0CH0 |  |  |  |  |  | - | - | - | - | 0 | 223 | VSS |  |  |  |  |  | - | - | - | -
224 | HDTXP0_D0CH0 |  |  |  | True_OF_HDTXN0_D0CH0 |  | AK9 | AD7 | W4 | V12 | 0 | 224 | RESERVED |  |  |  |  |  | AK9 | AD7 | W4 | V12
225 | VCCHTX0_D0CH0 |  |  |  |  |  | AC13 | W10 | T7 | U12 | 0 | 225 | VSS |  |  |  |  |  | AC13 | W10 | T7 | U12
226 | HDTXN0_D0CH0 |  |  |  | Comp_OF_HDTXP0_D0CH0 |  | AK10 | AD8 | W5 | V11 | 0 | 226 | RESERVED |  |  |  |  |  | AK10 | AD8 | W5 | V11
227 | VSSA0_D0CH0 |  |  |  |  |  | - | - | - | - | 0 | 227 | VSS |  |  |  |  |  | - | - | - | -
228 | VCCARX0_D0CH0 |  |  |  |  |  | - | - | - | - | 0 | 228 | VSS |  |  |  |  |  | - | - | - | -
229 | HDRXP0_D0CH0 |  |  |  | True_OF_HDRXN0_D0CH0 |  | AM8 | AF6 | Y5 | V9 | 0 | 229 | VSS |  |  |  |  |  | AM8 | AF6 | Y5 | V9
230 | VCCARX0_D0CH0 |  |  |  |  |  | - | - | - | - | 0 | 230 | VSS |  |  |  |  |  | - | - | - | -
231 | VCCHRX0_D0CH0 |  |  |  |  |  | AC14 | W11 | T8 | U8 | 0 | 231 | VSS |  |  |  |  |  | AC14 | W11 | T8 | U8
232 | HDRXN0_D0CH0 |  |  |  | Comp_OF_HDRXP0_D0CH0 |  | AM9 | AF7 | Y6 | V8 | 0 | 232 | VSS |  |  |  |  |  | AM9 | AF7 | Y6 | V8
233 | VSSA0_D0CH0 |  |  |  |  |  | - | - | - | - | 0 | 233 | VSS |  |  |  |  |  | - | - | - | -
234 | VSSA1_D0CH1 |  |  |  |  |  | - | - | - | - | 0 | 234 | VSS |  |  |  |  |  | - | - | - | -
235 | HDRXP0_D0CH1 |  |  |  | True_OF_HDRXN0_D0CH1 |  | AM11 | AF9 | Y7 | V6 | 0 | 235 | VSS |  |  |  |  |  | AM11 | AF9 | Y7 | V6
236 | VCCARX1_D0CH1 |  |  |  |  |  | - | - | - | - | 0 | 236 | VSS |  |  |  |  |  | - | - | - | -
237 | VCCHRX1_D0CH1 |  |  |  |  |  | AC15 | W12 | T9 | U6 | 0 | 237 | VSS |  |  |  |  |  | AC15 | W12 | T9 | U6
238 | HDRXN0_D0CH1 |  |  |  | Comp_OF_HDRXP0_D0CH1 |  | AM12 | AF10 | Y8 | V5 | 0 | 238 | VSS |  |  |  |  |  | AM12 | AF10 | Y8 | V5
239 | VCCARX1_D0CH1 |  |  |  |  |  | - | - | - | - | 0 | 239 | VSS |  |  |  |  |  | - | - | - | -
240 | VSSA1_D0CH1 |  |  |  |  |  | - | - | - | - | 0 | 240 | VSS |  |  |  |  |  | - | - | - | -
241 | HDTXP0_D0CH1 |  |  |  | True_OF_HDTXN0_D0CH1 |  | AK12 | AD10 | W8 | V3 | 0 | 241 | RESERVED |  |  |  |  |  | AK12 | AD10 | W8 | V3
242 | VCCHTX1_D0CH1 |  |  |  |  |  | AC16 | W13 | T10 | T5 | 0 | 242 | VSS |  |  |  |  |  | AC16 | W13 | T10 | T5
243 | HDTXN0_D0CH1 |  |  |  | Comp_OF_HDTXP0_D0CH1 |  | AK13 | AD11 | W9 | V2 | 0 | 243 | RESERVED |  |  |  |  |  | AK13 | AD11 | W9 | V2
244 | VCCATX1_D0CH1 |  |  |  |  |  | - | - | - | - | 0 | 244 | VSS |  |  |  |  |  | - | - | - | -
245 | VSSA1_D0CH1 |  |  |  |  |  | - | - | - | - | 0 | 245 | VSS |  |  |  |  |  | - | - | - | -
246 | RESERVED |  |  |  |  |  | AK15 | AD13 | W10 | - | 1 | 246 | RESERVED |  |  |  |  |  | AK15 | AD13 | W10 | -
247 | VCCA_D0 |  |  |  |  |  | - | - | - | - | 0 | 247 | VSS |  |  |  |  |  | - | - | - | -
248 | RESERVED |  |  |  |  |  | AK16 | AD14 | W11 | - | 1 | 248 | RESERVED |  |  |  |  |  | AK16 | AD14 | W11 | -
249 | VSSA_D0 |  |  |  |  |  | - | - | - | - | 0 | 249 | VSS |  |  |  |  |  | - | - | - | -
250 | VSSA_D0 |  |  |  |  |  | - | - | - | - | 0 | 250 | VSS |  |  |  |  |  | - | - | - | -
251 | REFCLKP_D0 |  |  |  | True_OF_REFCLKN_D0 |  | AM14 | AF12 | Y11 | U1 | 1 | 251 | REFCLKP_D0 |  |  |  |  |  | AM14 | AF12 | Y11 | U1
252 | VCCA25_D0 |  |  |  |  |  | - | - | - | - | 0 | 252 | VSS |  |  |  |  |  | - | - | - | -
253 | REFCLKN_D0 |  |  |  | Comp_OF_REFCLKP_D0 |  | AM15 | AF13 | Y12 | T1 | 1 | 253 | REFCLKN_D0 |  |  |  |  |  | AM15 | AF13 | Y12 | T1
254 | VSSA0_D1CH0 |  |  |  |  |  | - | - | - | - | 0 | 254 | VSS |  |  |  |  |  | - | - | - | -
255 | VCCATX0_D1CH0 |  |  |  |  |  | - | - | - | - | 0 | 255 | VSS |  |  |  |  |  | - | - | - | -
256 | HDTXP0_D1CH0 |  |  |  | True_OF_HDTXN0_D1CH0 |  | AK18 | AD16 | W13 | - | 0 | 256 | RESERVED |  |  |  |  |  | AK18 | AD16 | W13 | -
257 | VCCHTX0_D1CH0 |  |  |  |  |  | AC17 | W14 | T11 | - | 0 | 257 | VSS |  |  |  |  |  | AC17 | W14 | T11 | -
258 | HDTXN0_D1CH0 |  |  |  | Comp_OF_HDTXP0_D1CH0 |  | AK19 | AD17 | W14 | - | 0 | 258 | RESERVED |  |  |  |  |  | AK19 | AD17 | W14 | -
259 | VSSA0_D1CH0 |  |  |  |  |  | - | - | - | - | 0 | 259 | VSS |  |  |  |  |  | - | - | - | -
260 | VCCARX0_D1CH0 |  |  |  |  |  | - | - | - | - | 0 | 260 | VSS |  |  |  |  |  | - | - | - | -
261 | HDRXP0_D1CH0 |  |  |  | True_OF_HDRXN0_D1CH0 |  | AM17 | AF15 | Y14 | - | 0 | 261 | VSS |  |  |  |  |  | AM17 | AF15 | Y14 | -
262 | VCCARX0_D1CH0 |  |  |  |  |  | - | - | - | - | 0 | 262 | VSS |  |  |  |  |  | - | - | - | -
263 | VCCHRX0_D1CH0 |  |  |  |  |  | AC18 | W15 | T12 | - | 0 | 263 | VSS |  |  |  |  |  | AC18 | W15 | T12 | -
264 | HDRXN0_D1CH0 |  |  |  | Comp_OF_HDRXP0_D1CH0 |  | AM18 | AF16 | Y15 | - | 0 | 264 | VSS |  |  |  |  |  | AM18 | AF16 | Y15 | -
265 | VSSA0_D1CH0 |  |  |  |  |  | - | - | - | - | 0 | 265 | VSS |  |  |  |  |  | - | - | - | -
266 | VSSA1_D1CH1 |  |  |  |  |  | - | - | - | - | 0 | 266 | VSS |  |  |  |  |  | - | - | - | -
267 | HDRXP0_D1CH1 |  |  |  | True_OF_HDRXN0_D1CH1 |  | AM20 | AF18 | Y16 | - | 0 | 267 | VSS |  |  |  |  |  | AM20 | AF18 | Y16 | -
268 | VCCARX1_D1CH1 |  |  |  |  |  | - | - | - | - | 0 | 268 | VSS |  |  |  |  |  | - | - | - | -
269 | VCCHRX1_D1CH1 |  |  |  |  |  | AC19 | W16 | T13 | - | 0 | 269 | VSS |  |  |  |  |  | AC19 | W16 | T13 | -
270 | HDRXN0_D1CH1 |  |  |  | Comp_OF_HDRXP0_D1CH1 |  | AM21 | AF19 | Y17 | - | 0 | 270 | VSS |  |  |  |  |  | AM21 | AF19 | Y17 | -
271 | VCCARX1_D1CH1 |  |  |  |  |  | - | - | - | - | 0 | 271 | VSS |  |  |  |  |  | - | - | - | -
272 | VSSA1_D1CH1 |  |  |  |  |  | - | - | - | - | 0 | 272 | VSS |  |  |  |  |  | - | - | - | -
273 | HDTXP0_D1CH1 |  |  |  | True_OF_HDTXN0_D1CH1 |  | AK21 | AD19 | W17 | - | 0 | 273 | RESERVED |  |  |  |  |  | AK21 | AD19 | W17 | -
274 | VCCHTX1_D1CH1 |  |  |  |  |  | AC20 | W17 | T14 | - | 0 | 274 | VSS |  |  |  |  |  | AC20 | W17 | T14 | -
275 | HDTXN0_D1CH1 |  |  |  | Comp_OF_HDTXP0_D1CH1 |  | AK22 | AD20 | W18 | - | 0 | 275 | RESERVED |  |  |  |  |  | AK22 | AD20 | W18 | -
276 | VCCATX1_D1CH1 |  |  |  |  |  | - | - | - | - | 0 | 276 | VSS |  |  |  |  |  | - | - | - | -
277 | VSSA1_D1CH1 |  |  |  |  |  | - | - | - | - | 0 | 277 | VSS |  |  |  |  |  | - | - | - | -
278 | RESERVED |  |  |  |  |  | AK24 | AD22 | - | - | 1 | 278 | RESERVED |  |  |  |  |  | AK24 | AD22 | - | -
279 | VCCA_D1 |  |  |  |  |  | - | - | - | - | 0 | 279 | VSS |  |  |  |  |  | - | - | - | -
280 | RESERVED |  |  |  |  |  | AK25 | AD23 | - | - | 1 | 280 | RESERVED |  |  |  |  |  | AK25 | AD23 | - | -
281 | VSSA_D1 |  |  |  |  |  | - | - | - | - | 0 | 281 | VSS |  |  |  |  |  | - | - | - | -
282 | VSSA_D1 |  |  |  |  |  | - | - | - | - | 0 | 282 | VSS |  |  |  |  |  | - | - | - | -
283 | REFCLKP_D1 |  |  |  | True_OF_REFCLKN_D1 |  | AM23 | AF21 | Y19 | - | 0 | 283 | VSS |  |  |  |  |  | AM23 | AF21 | Y19 | -
284 | VCCA25_D1 |  |  |  |  |  | - | - | - | - | 0 | 284 | VSS |  |  |  |  |  | - | - | - | -
285 | REFCLKN_D1 |  |  |  | Comp_OF_REFCLKP_D1 |  | AM24 | AF22 | W20 | - | 0 | 285 | VSS |  |  |  |  |  | AM24 | AF22 | W20 | -
286 | VCC |  |  |  |  |  | - | - | - | - | 1 | 286 | VCC |  |  |  |  |  | - | - | - | -
287 | VCC |  |  |  |  |  | - | - | - | - | 1 | 287 | VCC |  |  |  |  |  | - | - | - | -
288 | VSS |  |  |  |  |  | - | - | - | - | 1 | 288 | VSS |  |  |  |  |  | - | - | - | -
289 | VSS |  |  |  |  |  | - | - | - | - | 1 | 289 | VSS |  |  |  |  |  | - | - | - | -
290 | PB96A | IO | 4 |  | True_OF_PB96B |  | AM28 | - | - | - | 1 | 290 | PB96A | IO | 4 |  | True_OF_PB96B |  | AM28 | - | - | -
291 | PB98A | IO | 4 |  | True_OF_PB98B |  | AL28 | - | - | - | 1 | 291 | PB98A | IO | 4 |  | True_OF_PB98B |  | AL28 | - | - | -
292 | VCC |  |  |  |  |  | - | - | - | - | 1 | 292 | VCC |  |  |  |  |  | - | - | - | -
293 | PB96B | IO | 4 |  | Comp_OF_PB96A |  | AM29 | - | - | - | 1 | 293 | PB96B | IO | 4 |  | Comp_OF_PB96A |  | AM29 | - | - | -
294 | PB98B | IO | 4 |  | Comp_OF_PB98A |  | AK28 | - | - | - | 1 | 294 | PB98B | IO | 4 |  | Comp_OF_PB98A |  | AK28 | - | - | -
295 | VSS |  |  |  |  |  | - | - | - | - | 1 | 295 | VSS |  |  |  |  |  | - | - | - | -
296 | PB101A | IO | 4 |  | True_OF_PB101B |  | AK32 | - | - | - | 1 | 296 | PB101A | IO | 4 |  | True_OF_PB101B |  | AK32 | - | - | -
297 | PB103A | IO | 4 |  | True_OF_PB103B |  | AM30 | - | - | - | 1 | 297 | PB103A | IO | 4 |  | True_OF_PB103B |  | AM30 | - | - | -
298 | VSSIO4 |  |  |  |  |  | - | - | - | - | 1 | 298 | VSSIO4 |  |  |  |  |  | - | - | - | -
299 | PB101B | IO | 4 |  | Comp_OF_PB101A |  | AJ32 | - | - | - | 1 | 299 | PB101B | IO | 4 |  | Comp_OF_PB101A |  | AJ32 | - | - | -
300 | PB103B | IO | 4 |  | Comp_OF_PB103A |  | AL30 | - | - | - | 1 | 300 | PB103B | IO | 4 |  | Comp_OF_PB103A |  | AL30 | - | - | -
301 | VCCIO4 |  |  |  |  |  | - | - | - | - | 1 | 301 | VCCIO4 |  |  |  |  |  | - | - | - | -
302 | PB105A | IO | 4 |  | True_OF_PB105B |  | AK31 | - | - | - | 1 | 302 | PB105A | IO | 4 |  | True_OF_PB105B |  | AK31 | - | - | -
303 | PB107A | IO | 4 |  | True_OF_PB107B |  | AM31 | AA22 | - | - | 1 | 303 | PB107A | IO | 4 |  | True_OF_PB107B |  | AM31 | AA22 | - | -
304 | VSSIO4 |  |  |  |  |  | - | - | - | - | 1 | 304 | VSSIO4 |  |  |  |  |  | - | - | - | -
305 | PB105B | IO | 4 |  | Comp_OF_PB105A |  | AJ31 | - | - | - | 1 | 305 | PB105B | IO | 4 |  | Comp_OF_PB105A |  | AJ31 | - | - | -
306 | PB107B | IO | 4 |  | Comp_OF_PB107A |  | AL32 | AA23 | - | - | 1 | 306 | PB107B | IO | 4 |  | Comp_OF_PB107A |  | AL32 | AA23 | - | -
307 | VCCIO4 |  |  |  |  |  | - | - | - | - | 1 | 307 | VCCIO4 |  |  |  |  |  | - | - | - | -
308 | PB110A | IO | 4 |  | True_OF_PB110B |  | AG28 | AB24 | - | - | 1 | 308 | PB110A | IO | 4 |  | True_OF_PB110B |  | AG28 | AB24 | - | -
309 | PB112A | IO | 4 |  | True_OF_PB112B |  | AJ28 | AB25 | - | - | 1 | 309 | PB112A | IO | 4 |  | True_OF_PB112B |  | AJ28 | AB25 | - | -
310 | VCCAUX |  |  |  |  |  | - | - | - | - | 1 | 310 | VCCAUX |  |  |  |  |  | - | - | - | -
311 | PB110B | IO | 4 |  | Comp_OF_PB110A |  | AG29 | AA24 | - | - | 1 | 311 | PB110B | IO | 4 |  | Comp_OF_PB110A |  | AG29 | AA24 | - | -
312 | PB112B | IO | 4 |  | Comp_OF_PB112A |  | AH28 | AA25 | - | - | 1 | 312 | PB112B | IO | 4 |  | Comp_OF_PB112A |  | AH28 | AA25 | - | -
313 | VSS |  |  |  |  |  | - | - | - | - | 1 | 313 | VSS |  |  |  |  |  | - | - | - | -
314 | PB114A | IO | 4 |  | True_OF_PB114B |  | AH30 | AE25 | - | - | 1 | 314 | PB114A | IO | 4 |  | True_OF_PB114B |  | AH30 | AE25 | - | -
315 | PB116A | IO | 4 |  | True_OF_PB116B |  | AK29 | AF25 | - | - | 1 | 315 | PB116A | IO | 4 |  | True_OF_PB116B |  | AK29 | AF25 | - | -
316 | VCC |  |  |  |  |  | - | - | - | - | 1 | 316 | VCC |  |  |  |  |  | - | - | - | -
317 | PB114B | IO | 4 |  | Comp_OF_PB114A |  | AG30 | AD25 | - | - | 1 | 317 | PB114B | IO | 4 |  | Comp_OF_PB114A |  | AG30 | AD25 | - | -
318 | PB116B | IO | 4 |  | Comp_OF_PB116A |  | AK30 | AE26 | - | - | 1 | 318 | PB116B | IO | 4 |  | Comp_OF_PB116A |  | AK30 | AE26 | - | -
319 | VSS |  |  |  |  |  | - | - | - | - | 1 | 319 | VSS |  |  |  |  |  | - | - | - | -
320 | PB119A | IO | 4 |  | True_OF_PB119B |  | AH32 | AD26 | - | - | 1 | 320 | PB119A | IO | 4 |  | True_OF_PB119B |  | AH32 | AD26 | - | -
321 | PB121A | IO | 4 |  | True_OF_PB121B |  | AJ29 | AB26 | - | - | 1 | 321 | PB121A | IO | 4 |  | True_OF_PB121B |  | AJ29 | AB26 | - | -
322 | VSSIO4 |  |  |  |  |  | - | - | - | - | 1 | 322 | VSSIO4 |  |  |  |  |  | - | - | - | -
323 | PB119B | IO | 4 |  | Comp_OF_PB119A |  | AG32 | AC26 | - | - | 1 | 323 | PB119B | IO | 4 |  | Comp_OF_PB119A |  | AG32 | AC26 | - | -
324 | PB121B | IO | 4 |  | Comp_OF_PB121A |  | AJ30 | AA26 | - | - | 1 | 324 | PB121B | IO | 4 |  | Comp_OF_PB121A |  | AJ30 | AA26 | - | -
325 | VCCIO4 |  |  |  |  |  | - | - | - | - | 1 | 325 | VCCIO4 |  |  |  |  |  | - | - | - | -
326 | VCC |  |  |  |  |  | - | - | - | - | 1 | 326 | VCC |  |  |  |  |  | - | - | - | -
327 | VCCPLL0_LRC |  |  |  |  |  | - | - | - | - | 1 | 327 | VCCPLL0_LRC |  |  |  |  |  | - | - | - | -
328 | VSS |  |  |  |  |  | - | - | - | - | 1 | 328 | VSS |  |  |  |  |  | - | - | - | -
329 | VSSPLL0_LRC |  |  |  |  |  | - | - | - | - | 1 | 329 | VSSPLL0_LRC |  |  |  |  |  | - | - | - | -
330 | NC17 |  |  |  |  |  | - | - | - | - | 1 | 330 | NC17 |  |  |  |  |  | - | - | - | -
331 | NC18 |  |  |  |  |  | - | - | - | - | 1 | 331 | NC18 |  |  |  |  |  | - | - | - | -
332 | PR92D | IO | 3 | LRC_GPLL0C_IN | Comp_OF_PR92C | RDQ89 | AE32 | W24 | T17 | N1 | 1 | 332 | PR92D | IO | 3 | LRC_GPLL0C_IN | Comp_OF_PR92C | RDQ89 | AE32 | W24 | T17 | N1
333 | PR92C | IO | 3 | LRC_GPLL0T_IN | True_OF_PR92D | RDQ89 | AD32 | W25 | U16 | M1 | 1 | 333 | PR92C | IO | 3 | LRC_GPLL0T_IN | True_OF_PR92D | RDQ89 | AD32 | W25 | U16 | M1
334 | VCCIO3 |  |  |  |  |  | - | - | - | - | 1 | 334 | VCCIO3 |  |  |  |  |  | - | - | - | -
335 | PR92B | IO | 3 |  | Comp_OF_PR92A | RDQ89 | AC32 | W26 | U17 | - | 1 | 335 | PR92B | IO | 3 |  | Comp_OF_PR92A | RDQ89 | AC32 | W26 | U17 | -
336 | VSSIO3 |  |  |  |  |  | - | - | - | - | 1 | 336 | VSSIO3 |  |  |  |  |  | - | - | - | -
337 | PR92A | IO | 3 |  | True_OF_PR92B | RDQ89 | AB32 | V24 | U18 | - | 1 | 337 | PR92A | IO | 3 |  | True_OF_PR92B | RDQ89 | AB32 | V24 | U18 | -
338 | PR89D | IO | 3 |  | Comp_OF_PR89C | RDQ89 | AE31 | T26 | T18 | N2 | 1 | 338 | PR89D | IO | 3 |  | Comp_OF_PR89C | RDQ89 | AE31 | T26 | T18 | N2
339 | VSS |  |  |  |  |  | - | - | - | - | 1 | 339 | VSS |  |  |  |  |  | - | - | - | -
340 | PR89B | IO | 3 |  | Comp_OF_PR89A | RDQSN89 | AB31 | U25 | R18 | L1 | 1 | 340 | PR89B | IO | 3 |  | Comp_OF_PR89A | RDQSN89 | AB31 | U25 | R18 | L1
341 | PR89C | IO | 3 |  | True_OF_PR89D | RDQ89 | AC31 | U26 | U19 | M2 | 1 | 341 | PR89C | IO | 3 |  | True_OF_PR89D | RDQ89 | AC31 | U26 | U19 | M2
342 | VCC |  |  |  |  |  | - | - | - | - | 1 | 342 | VCC |  |  |  |  |  | - | - | - | -
343 | PR89A | IO | 3 |  | True_OF_PR89B | RDQS89 | AC30 | V26 | T19 | K2 | 1 | 343 | PR89A | IO | 3 |  | True_OF_PR89B | RDQS89 | AC30 | V26 | T19 | K2
344 | PR86D | IO | 3 |  | Comp_OF_PR86C | RDQ89 | AE30 | R26 | U20 | K1 | 1 | 344 | PR86D | IO | 3 |  | Comp_OF_PR86C | RDQ89 | AE30 | R26 | U20 | K1
345 | VSS |  |  |  |  |  | - | - | - | - | 1 | 345 | VSS |  |  |  |  |  | - | - | - | -
346 | PR86B | IO | 3 |  | Comp_OF_PR86A | RDQ89 | Y32 | P26 | R20 | L3 | 1 | 346 | PR86B | IO | 3 |  | Comp_OF_PR86A | RDQ89 | Y32 | P26 | R20 | L3
347 | PR86C | IO | 3 |  | True_OF_PR86D | RDQ89 | AD30 | T25 | T20 | K3 | 1 | 347 | PR86C | IO | 3 |  | True_OF_PR86D | RDQ89 | AD30 | T25 | T20 | K3
348 | VCCAUX |  |  |  |  |  | - | - | - | - | 1 | 348 | VCCAUX |  |  |  |  |  | - | - | - | -
349 | PR86A | IO | 3 |  | True_OF_PR86B | RDQ89 | W31 | P25 | P20 | M3 | 1 | 349 | PR86A | IO | 3 |  | True_OF_PR86B | RDQ89 | W31 | P25 | P20 | M3
350 | PR83D | IO | 3 |  | Comp_OF_PR83C | RDQ89 | AD29 | P24 | P18 | N3 | 1 | 350 | PR83D | IO | 3 |  | Comp_OF_PR83C | RDQ89 | AD29 | P24 | P18 | N3
351 | VCCIO3 |  |  |  |  |  | - | - | - | - | 1 | 351 | VCCIO3 |  |  |  |  |  | - | - | - | -
352 | PR83B | IO | 3 |  | Comp_OF_PR83A | RDQ89 | AB29 | U24 | N20 | L4 | 1 | 352 | PR83B | IO | 3 |  | Comp_OF_PR83A | RDQ89 | AB29 | U24 | N20 | L4
353 | PR83C | IO | 3 |  | True_OF_PR83D | RDQ89 | AC28 | R24 | P19 | N4 | 1 | 353 | PR83C | IO | 3 |  | True_OF_PR83D | RDQ89 | AC28 | R24 | P19 | N4
354 | VSSIO3 |  |  |  |  |  | - | - | - | - | 1 | 354 | VSSIO3 |  |  |  |  |  | - | - | - | -
355 | PR83A | IO | 3 |  | True_OF_PR83B | RDQ89 | AB30 | T24 | N19 | K4 | 1 | 355 | PR83A | IO | 3 |  | True_OF_PR83B | RDQ89 | AB30 | T24 | N19 | K4
356 | PR80D | IO | 3 |  | Comp_OF_PR80C | RDQ77 | AE29 | W21 | - | - | 1 | 356 | PR80D | IO | 3 |  | Comp_OF_PR80C | RDQ77 | AE29 | W21 | - | -
357 | VCCIO3 |  |  |  |  |  | - | - | - | - | 1 | 357 | VCCIO3 |  |  |  |  |  | - | - | - | -
358 | PR80B | IO | 3 |  | Comp_OF_PR80A | RDQ77 | AE27 | V21 | - | - | 1 | 358 | PR80B | IO | 3 |  | Comp_OF_PR80A | RDQ77 | AE27 | V21 | - | -
359 | PR80C | IO | 3 |  | True_OF_PR80D | RDQ77 | AE28 | W22 | - | - | 1 | 359 | PR80C | IO | 3 |  | True_OF_PR80D | RDQ77 | AE28 | W22 | - | -
360 | VSSIO3 |  |  |  |  |  | - | - | - | - | 1 | 360 | VSSIO3 |  |  |  |  |  | - | - | - | -
361 | PR80A | IO | 3 |  | True_OF_PR80B | RDQ77 | AD27 | W23 | - | - | 1 | 361 | PR80A | IO | 3 |  | True_OF_PR80B | RDQ77 | AD27 | W23 | - | -
362 | PR77D | IO | 3 |  | Comp_OF_PR77C | RDQ77 | AD26 | U23 | - | - | 1 | 362 | PR77D | IO | 3 |  | Comp_OF_PR77C | RDQ77 | AD26 | U23 | - | -
363 | VSS |  |  |  |  |  | - | - | - | - | 1 | 363 | VSS |  |  |  |  |  | - | - | - | -
364 | PR77B | IO | 3 |  | Comp_OF_PR77A | RDQSN77 | AB27 | U22 | - | - | 1 | 364 | PR77B | IO | 3 |  | Comp_OF_PR77A | RDQSN77 | AB27 | U22 | - | -
365 | PR77C | IO | 3 |  | True_OF_PR77D | RDQ77 | AC26 | U21 | - | - | 1 | 365 | PR77C | IO | 3 |  | True_OF_PR77D | RDQ77 | AC26 | U21 | - | -
366 | VCC |  |  |  |  |  | - | - | - | - | 1 | 366 | VCC |  |  |  |  |  | - | - | - | -
367 | PR77A | IO | 3 |  | True_OF_PR77B | RDQS77 | AB28 | V23 | T16 | - | 1 | 367 | PR77A | IO | 3 |  | True_OF_PR77B | RDQS77 | AB28 | V23 | T16 | -
368 | PR74D | IO | 3 |  | Comp_OF_PR74C | RDQ77 | AC27 | T23 | - | - | 1 | 368 | PR74D | IO | 3 |  | Comp_OF_PR74C | RDQ77 | AC27 | T23 | - | -
369 | VSS |  |  |  |  |  | - | - | - | - | 1 | 369 | VSS |  |  |  |  |  | - | - | - | -
370 | PR74B | IO | 3 |  | Comp_OF_PR74A | RDQ77 | W29 | T22 | - | - | 1 | 370 | PR74B | IO | 3 |  | Comp_OF_PR74A | RDQ77 | W29 | T22 | - | -
371 | PR74C | IO | 3 |  | True_OF_PR74D | RDQ77 | AB26 | R21 | - | - | 1 | 371 | PR74C | IO | 3 |  | True_OF_PR74D | RDQ77 | AB26 | R21 | - | -
372 | VCCAUX |  |  |  |  |  | - | - | - | - | 1 | 372 | VCCAUX |  |  |  |  |  | - | - | - | -
373 | PR74A | IO | 3 |  | True_OF_PR74B | RDQ77 | Y29 | R23 | - | - | 1 | 373 | PR74A | IO | 3 |  | True_OF_PR74B | RDQ77 | Y29 | R23 | - | -
374 | PR71D | IO | 3 |  | Comp_OF_PR71C | RDQ77 | W28 | N23 | - | - | 1 | 374 | PR71D | IO | 3 |  | Comp_OF_PR71C | RDQ77 | W28 | N23 | - | -
375 | VCCIO3 |  |  |  |  |  | - | - | - | - | 1 | 375 | VCCIO3 |  |  |  |  |  | - | - | - | -
376 | PR71B | IO | 3 |  | Comp_OF_PR71A | RDQ77 | Y27 | P22 | - | - | 1 | 376 | PR71B | IO | 3 |  | Comp_OF_PR71A | RDQ77 | Y27 | P22 | - | -
377 | PR71C | IO | 3 |  | True_OF_PR71D | RDQ77 | Y28 | P21 | - | - | 1 | 377 | PR71C | IO | 3 |  | True_OF_PR71D | RDQ77 | Y28 | P21 | - | -
378 | VSSIO3 |  |  |  |  |  | - | - | - | - | 1 | 378 | VSSIO3 |  |  |  |  |  | - | - | - | -
379 | PR71A | IO | 3 |  | True_OF_PR71B | RDQ77 | Y26 | P23 | - | - | 1 | 379 | PR71A | IO | 3 |  | True_OF_PR71B | RDQ77 | Y26 | P23 | - | -
380 | PR68D | IO | 3 |  | Comp_OF_PR68C | RDQ65 | W32 | - | - | - | 1 | 380 | PR68D | IO | 3 |  | Comp_OF_PR68C | RDQ65 | W32 | - | - | -
381 | VCCIO3 |  |  |  |  |  | - | - | - | - | 1 | 381 | VCCIO3 |  |  |  |  |  | - | - | - | -
382 | PR68B | IO | 3 |  | Comp_OF_PR68A | RDQ65 | U32 | - | - | - | 1 | 382 | PR68B | IO | 3 |  | Comp_OF_PR68A | RDQ65 | U32 | - | - | -
383 | PR68C | IO | 3 |  | True_OF_PR68D | RDQ65 | V32 | - | - | - | 1 | 383 | PR68C | IO | 3 |  | True_OF_PR68D | RDQ65 | V32 | - | - | -
384 | VSSIO3 |  |  |  |  |  | - | - | - | - | 1 | 384 | VSSIO3 |  |  |  |  |  | - | - | - | -
385 | PR68A | IO | 3 |  | True_OF_PR68B | RDQ65 | T32 | - | - | - | 1 | 385 | PR68A | IO | 3 |  | True_OF_PR68B | RDQ65 | T32 | - | - | -
386 | PR65D | IO | 3 |  | Comp_OF_PR65C | RDQ65 | Y30 | - | - | - | 1 | 386 | PR65D | IO | 3 |  | Comp_OF_PR65C | RDQ65 | Y30 | - | - | -
387 | VSS |  |  |  |  |  | - | - | - | - | 1 | 387 | VSS |  |  |  |  |  | - | - | - | -
388 | PR65B | IO | 3 |  | Comp_OF_PR65A | RDQSN65 | T31 | - | - | - | 1 | 388 | PR65B | IO | 3 |  | Comp_OF_PR65A | RDQSN65 | T31 | - | - | -
389 | PR65C | IO | 3 |  | True_OF_PR65D | RDQ65 | W30 | - | - | - | 1 | 389 | PR65C | IO | 3 |  | True_OF_PR65D | RDQ65 | W30 | - | - | -
390 | VCC |  |  |  |  |  | - | - | - | - | 1 | 390 | VCC |  |  |  |  |  | - | - | - | -
391 | PR65A | IO | 3 |  | True_OF_PR65B | RDQS65 | R32 | - | - | - | 1 | 391 | PR65A | IO | 3 |  | True_OF_PR65B | RDQS65 | R32 | - | - | -
392 | PR62D | IO | 3 |  | Comp_OF_PR62C | RDQ65 | U30 | - | - | - | 1 | 392 | PR62D | IO | 3 |  | Comp_OF_PR62C | RDQ65 | U30 | - | - | -
393 | VSS |  |  |  |  |  | - | - | - | - | 1 | 393 | VSS |  |  |  |  |  | - | - | - | -
394 | PR62B | IO | 3 |  | Comp_OF_PR62A | RDQ65 | P32 | - | - | - | 1 | 394 | PR62B | IO | 3 |  | Comp_OF_PR62A | RDQ65 | P32 | - | - | -
395 | PR62C | IO | 3 |  | True_OF_PR62D | RDQ65 | U31 | - | - | - | 1 | 395 | PR62C | IO | 3 |  | True_OF_PR62D | RDQ65 | U31 | - | - | -
396 | VCCAUX |  |  |  |  |  | - | - | - | - | 1 | 396 | VCCAUX |  |  |  |  |  | - | - | - | -
397 | PR62A | IO | 3 |  | True_OF_PR62B | RDQ65 | N32 | - | - | - | 1 | 397 | PR62A | IO | 3 |  | True_OF_PR62B | RDQ65 | N32 | - | - | -
398 | PR59D | IO | 3 |  | Comp_OF_PR59C | RDQ65 | T30 | - | - | - | 1 | 398 | PR59D | IO | 3 |  | Comp_OF_PR59C | RDQ65 | T30 | - | - | -
399 | VCCIO3 |  |  |  |  |  | - | - | - | - | 1 | 399 | VCCIO3 |  |  |  |  |  | - | - | - | -
400 | PR59B | IO | 3 |  | Comp_OF_PR59A | RDQ65 | P30 | - | - | - | 1 | 400 | PR59B | IO | 3 |  | Comp_OF_PR59A | RDQ65 | P30 | - | - | -
401 | PR59C | IO | 3 |  | True_OF_PR59D | RDQ65 | R30 | - | - | - | 1 | 401 | PR59C | IO | 3 |  | True_OF_PR59D | RDQ65 | R30 | - | - | -
402 | VSSIO3 |  |  |  |  |  | - | - | - | - | 1 | 402 | VSSIO3 |  |  |  |  |  | - | - | - | -
403 | PR59A | IO | 3 |  | True_OF_PR59B | RDQ65 | P31 | - | - | - | 1 | 403 | PR59A | IO | 3 |  | True_OF_PR59B | RDQ65 | P31 | - | - | -
404 | PR56D | IO | 3 |  | Comp_OF_PR56C | RDQ53 | V26 | M24 | R17 | H1 | 1 | 404 | PR56D | IO | 3 |  | Comp_OF_PR56C | RDQ53 | V26 | M24 | R17 | H1
405 | VCCIO3 |  |  |  |  |  | - | - | - | - | 1 | 405 | VCCIO3 |  |  |  |  |  | - | - | - | -
406 | PR56B | IO | 3 | VREF1_3 | Comp_OF_PR56A | RDQ53 | V29 | N25 | P16 | J1 | 1 | 406 | PR56B | IO | 3 | VREF1_3 | Comp_OF_PR56A | RDQ53 | V29 | N25 | P16 | J1
407 | PR56C | IO | 3 |  | True_OF_PR56D | RDQ53 | V27 | N24 | R16 | F1 | 1 | 407 | PR56C | IO | 3 |  | True_OF_PR56D | RDQ53 | V27 | N24 | R16 | F1
408 | VSSIO3 |  |  |  |  |  | - | - | - | - | 1 | 408 | VSSIO3 |  |  |  |  |  | - | - | - | -
409 | PR56A | IO | 3 |  | True_OF_PR56B | RDQ53 | U29 | N26 | N17 | J2 | 1 | 409 | PR56A | IO | 3 |  | True_OF_PR56B | RDQ53 | U29 | N26 | N17 | J2
410 | PR53D | IO | 3 |  | Comp_OF_PR53C | RDQ53 | U28 | L26 | P17 | - | 1 | 410 | PR53D | IO | 3 |  | Comp_OF_PR53C | RDQ53 | U28 | L26 | P17 | -
411 | VSS |  |  |  |  |  | - | - | - | - | 1 | 411 | VSS |  |  |  |  |  | - | - | - | -
412 | PR53B | IO | 3 |  | Comp_OF_PR53A | RDQSN53 | T28 | M26 | M17 | G1 | 1 | 412 | PR53B | IO | 3 |  | Comp_OF_PR53A | RDQSN53 | T28 | M26 | M17 | G1
413 | PR53C | IO | 3 |  | True_OF_PR53D | RDQ53 | T29 | K26 | N18 | - | 1 | 413 | PR53C | IO | 3 |  | True_OF_PR53D | RDQ53 | T29 | K26 | N18 | -
414 | VCC |  |  |  |  |  | - | - | - | - | 1 | 414 | VCC |  |  |  |  |  | - | - | - | -
415 | PR53A | IO | 3 |  | True_OF_PR53B | RDQS53 | R29 | L25 | N16 | F2 | 1 | 415 | PR53A | IO | 3 |  | True_OF_PR53B | RDQS53 | R29 | L25 | N16 | F2
416 | PR50D | IO | 3 |  | Comp_OF_PR50C | RDQ53 | U26 | L24 | M18 | H2 | 1 | 416 | PR50D | IO | 3 |  | Comp_OF_PR50C | RDQ53 | U26 | L24 | M18 | H2
417 | VSS |  |  |  |  |  | - | - | - | - | 1 | 417 | VSS |  |  |  |  |  | - | - | - | -
418 | PR50B | IO | 3 |  | Comp_OF_PR50A | RDQ53 | T27 | J26 | L17 | G3 | 1 | 418 | PR50B | IO | 3 |  | Comp_OF_PR50A | RDQ53 | T27 | J26 | L17 | G3
419 | PR50C | IO | 3 |  | True_OF_PR50D | RDQ53 | U27 | K24 | L18 | J3 | 1 | 419 | PR50C | IO | 3 |  | True_OF_PR50D | RDQ53 | U27 | K24 | L18 | J3
420 | VCCAUX |  |  |  |  |  | - | - | - | - | 1 | 420 | VCCAUX |  |  |  |  |  | - | - | - | -
421 | PR50A | IO | 3 |  | True_OF_PR50B | RDQ53 | R27 | K25 | L16 | H3 | 1 | 421 | PR50A | IO | 3 |  | True_OF_PR50B | RDQ53 | R27 | K25 | L16 | H3
422 | PR47D | IO | 3 | PCLKC3_0 | Comp_OF_PR47C | RDQ53 | T26 | H26 | M19 | F3 | 1 | 422 | PR47D | IO | 3 | PCLKC3_0 | Comp_OF_PR47C | RDQ53 | T26 | H26 | M19 | F3
423 | VCCIO3 |  |  |  |  |  | - | - | - | - | 1 | 423 | VCCIO3 |  |  |  |  |  | - | - | - | -
424 | PR47B | IO | 3 | PCLKC3_1 | Comp_OF_PR47A | RDQ53 | P29 | J24 | M20 | G4 | 1 | 424 | PR47B | IO | 3 | PCLKC3_1 | Comp_OF_PR47A | RDQ53 | P29 | J24 | M20 | G4
425 | PR47C | IO | 3 | PCLKT3_0 | True_OF_PR47D | RDQ53 | R26 | H25 | L19 | F4 | 1 | 425 | PR47C | IO | 3 | PCLKT3_0 | True_OF_PR47D | RDQ53 | R26 | H25 | L19 | F4
426 | VSSIO3 |  |  |  |  |  | - | - | - | - | 1 | 426 | VSSIO3 |  |  |  |  |  | - | - | - | -
427 | PR47A | IO | 3 | PCLKT3_1 | True_OF_PR47B | RDQ53 | P28 | H24 | L20 | H4 | 1 | 427 | PR47A | IO | 3 | PCLKT3_1 | True_OF_PR47B | RDQ53 | P28 | H24 | L20 | H4
428 | PR44D | IO | 2 | PCLKC2_0 | Comp_OF_PR44C | RDQ41 | P26 | N22 | K20 | D1 | 1 | 428 | PR44D | IO | 2 | PCLKC2_0 | Comp_OF_PR44C | RDQ41 | P26 | N22 | K20 | D1
429 | VCCIO2 |  |  |  |  |  | - | - | - | - | 1 | 429 | VCCIO2 |  |  |  |  |  | - | - | - | -
430 | PR44B | IO | 2 | PCLKC2_1 | Comp_OF_PR44A | RDQ41 | N26 | L23 | K19 | B1 | 1 | 430 | PR44B | IO | 2 | PCLKC2_1 | Comp_OF_PR44A | RDQ41 | N26 | L23 | K19 | B1
431 | PR44C | IO | 2 | PCLKT2_0 | True_OF_PR44D | RDQ41 | P27 | N21 | J20 | C1 | 1 | 431 | PR44C | IO | 2 | PCLKT2_0 | True_OF_PR44D | RDQ41 | P27 | N21 | J20 | C1
432 | VSSIO2 |  |  |  |  |  | - | - | - | - | 1 | 432 | VSSIO2 |  |  |  |  |  | - | - | - | -
433 | PR44A | IO | 2 | PCLKT2_1 | True_OF_PR44B | RDQ41 | N27 | K23 | J19 | D2 | 1 | 433 | PR44A | IO | 2 | PCLKT2_1 | True_OF_PR44B | RDQ41 | N27 | K23 | J19 | D2
434 | PR41D | IO | 2 |  | Comp_OF_PR41C | RDQ41 | L27 | M23 | K18 | - | 1 | 434 | PR41D | IO | 2 |  | Comp_OF_PR41C | RDQ41 | L27 | M23 | K18 | -
435 | VSS |  |  |  |  |  | - | - | - | - | 1 | 435 | VSS |  |  |  |  |  | - | - | - | -
436 | PR41B | IO | 2 |  | Comp_OF_PR41A | RDQSN41 | N29 | J23 | H20 | B2 | 1 | 436 | PR41B | IO | 2 |  | Comp_OF_PR41A | RDQSN41 | N29 | J23 | H20 | B2
437 | PR41C | IO | 2 |  | True_OF_PR41D | RDQ41 | L26 | M21 | J18 | A2 | 1 | 437 | PR41C | IO | 2 |  | True_OF_PR41D | RDQ41 | L26 | M21 | J18 | A2
438 | VCC |  |  |  |  |  | - | - | - | - | 1 | 438 | VCC |  |  |  |  |  | - | - | - | -
439 | PR41A | IO | 2 |  | True_OF_PR41B | RDQS41 | N30 | K22 | G19 | A3 | 1 | 439 | PR41A | IO | 2 |  | True_OF_PR41B | RDQS41 | N30 | K22 | G19 | A3
440 | PR38D | IO | 2 |  | Comp_OF_PR38C | RDQ41 | L29 | L22 | G20 | - | 1 | 440 | PR38D | IO | 2 |  | Comp_OF_PR38C | RDQ41 | L29 | L22 | G20 | -
441 | VSS |  |  |  |  |  | - | - | - | - | 1 | 441 | VSS |  |  |  |  |  | - | - | - | -
442 | PR38B | IO | 2 |  | Comp_OF_PR38A | RDQ41 | K26 | K21 | F19 | C2 | 1 | 442 | PR38B | IO | 2 |  | Comp_OF_PR38A | RDQ41 | K26 | K21 | F19 | C2
443 | PR38C | IO | 2 |  | True_OF_PR38D | RDQ41 | K28 | H23 | F20 | - | 1 | 443 | PR38C | IO | 2 |  | True_OF_PR38D | RDQ41 | K28 | H23 | F20 | -
444 | VCCAUX |  |  |  |  |  | - | - | - | - | 1 | 444 | VCCAUX |  |  |  |  |  | - | - | - | -
445 | PR38A | IO | 2 |  | True_OF_PR38B | RDQ41 | K27 | J21 | E20 | D3 | 1 | 445 | PR38A | IO | 2 |  | True_OF_PR38B | RDQ41 | K27 | J21 | E20 | D3
446 | PR35D | IO | 2 |  | Comp_OF_PR35C | RDQ41 | J27 | H21 | E19 | C3 | 1 | 446 | PR35D | IO | 2 |  | Comp_OF_PR35C | RDQ41 | J27 | H21 | E19 | C3
447 | VCCIO2 |  |  |  |  |  | - | - | - | - | 1 | 447 | VCCIO2 |  |  |  |  |  | - | - | - | -
448 | PR35B | IO | 2 |  | Comp_OF_PR35A | RDQ41 | H28 | F23 | D19 | C4 | 1 | 448 | PR35B | IO | 2 |  | Comp_OF_PR35A | RDQ41 | H28 | F23 | D19 | C4
449 | PR35C | IO | 2 | VREF1_2 | True_OF_PR35D | RDQ41 | J26 | H22 | D20 | B4 | 1 | 449 | PR35C | IO | 2 | VREF1_2 | True_OF_PR35D | RDQ41 | J26 | H22 | D20 | B4
450 | VSSIO2 |  |  |  |  |  | - | - | - | - | 1 | 450 | VSSIO2 |  |  |  |  |  | - | - | - | -
451 | PR35A | IO | 2 |  | True_OF_PR35B | RDQ41 | H27 | F22 | C20 | D4 | 1 | 451 | PR35A | IO | 2 |  | True_OF_PR35B | RDQ41 | H27 | F22 | C20 | D4
452 | PR32D | IO | 2 |  | Comp_OF_PR32C | RDQ29 | K29 | - | - | - | 1 | 452 | PR32D | IO | 2 |  | Comp_OF_PR32C | RDQ29 | K29 | - | - | -
453 | VCCIO2 |  |  |  |  |  | - | - | - | - | 1 | 453 | VCCIO2 |  |  |  |  |  | - | - | - | -
454 | PR32B | IO | 2 |  | Comp_OF_PR32A | RDQ29 | L30 | - | - | - | 1 | 454 | PR32B | IO | 2 |  | Comp_OF_PR32A | RDQ29 | L30 | - | - | -
455 | PR32C | IO | 2 |  | True_OF_PR32D | RDQ29 | J29 | - | - | - | 1 | 455 | PR32C | IO | 2 |  | True_OF_PR32D | RDQ29 | J29 | - | - | -
456 | VSSIO2 |  |  |  |  |  | - | - | - | - | 1 | 456 | VSSIO2 |  |  |  |  |  | - | - | - | -
457 | PR32A | IO | 2 |  | True_OF_PR32B | RDQ29 | L31 | - | - | - | 1 | 457 | PR32A | IO | 2 |  | True_OF_PR32B | RDQ29 | L31 | - | - | -
458 | PR29D | IO | 2 |  | Comp_OF_PR29C | RDQ29 | L32 | - | - | - | 1 | 458 | PR29D | IO | 2 |  | Comp_OF_PR29C | RDQ29 | L32 | - | - | -
459 | VSS |  |  |  |  |  | - | - | - | - | 1 | 459 | VSS |  |  |  |  |  | - | - | - | -
460 | PR29B | IO | 2 |  | Comp_OF_PR29A | RDQSN29 | J32 | - | K17 | - | 1 | 460 | PR29B | IO | 2 |  | Comp_OF_PR29A | RDQSN29 | J32 | - | K17 | -
461 | PR29C | IO | 2 |  | True_OF_PR29D | RDQ29 | K32 | - | - | - | 1 | 461 | PR29C | IO | 2 |  | True_OF_PR29D | RDQ29 | K32 | - | - | -
462 | VCC |  |  |  |  |  | - | - | - | - | 1 | 462 | VCC |  |  |  |  |  | - | - | - | -
463 | PR29A | IO | 2 |  | True_OF_PR29B | RDQS29 | K31 | - | K16 | - | 1 | 463 | PR29A | IO | 2 |  | True_OF_PR29B | RDQS29 | K31 | - | K16 | -
464 | PR26D | IO | 2 |  | Comp_OF_PR26C | RDQ29 | K30 | - | - | - | 1 | 464 | PR26D | IO | 2 |  | Comp_OF_PR26C | RDQ29 | K30 | - | - | -
465 | VSS |  |  |  |  |  | - | - | - | - | 1 | 465 | VSS |  |  |  |  |  | - | - | - | -
466 | PR26B | IO | 2 |  | Comp_OF_PR26A | RDQ29 | H30 | - | - | - | 1 | 466 | PR26B | IO | 2 |  | Comp_OF_PR26A | RDQ29 | H30 | - | - | -
467 | PR26C | IO | 2 |  | True_OF_PR26D | RDQ29 | J30 | - | - | - | 1 | 467 | PR26C | IO | 2 |  | True_OF_PR26D | RDQ29 | J30 | - | - | -
468 | VCCAUX |  |  |  |  |  | - | - | - | - | 1 | 468 | VCCAUX |  |  |  |  |  | - | - | - | -
469 | PR26A | IO | 2 |  | True_OF_PR26B | RDQ29 | H31 | - | - | - | 1 | 469 | PR26A | IO | 2 |  | True_OF_PR26B | RDQ29 | H31 | - | - | -
470 | PR23D | IO | 2 |  | Comp_OF_PR23C | RDQ29 | H32 | - | - | - | 1 | 470 | PR23D | IO | 2 |  | Comp_OF_PR23C | RDQ29 | H32 | - | - | -
471 | VCCIO2 |  |  |  |  |  | - | - | - | - | 1 | 471 | VCCIO2 |  |  |  |  |  | - | - | - | -
472 | PR23B | IO | 2 |  | Comp_OF_PR23A | RDQ29 | E32 | - | - | - | 1 | 472 | PR23B | IO | 2 |  | Comp_OF_PR23A | RDQ29 | E32 | - | - | -
473 | PR23C | IO | 2 |  | True_OF_PR23D | RDQ29 | F32 | - | - | - | 1 | 473 | PR23C | IO | 2 |  | True_OF_PR23D | RDQ29 | F32 | - | - | -
474 | VSSIO2 |  |  |  |  |  | - | - | - | - | 1 | 474 | VSSIO2 |  |  |  |  |  | - | - | - | -
475 | PR23A | IO | 2 |  | True_OF_PR23B | RDQ29 | F31 | - | - | - | 1 | 475 | PR23A | IO | 2 |  | True_OF_PR23B | RDQ29 | F31 | - | - | -
476 | PR20D | IO | 2 |  | Comp_OF_PR20C | RDQ17 | D32 | F24 | J16 | - | 1 | 476 | PR20D | IO | 2 |  | Comp_OF_PR20C | RDQ17 | D32 | F24 | J16 | -
477 | VCCIO2 |  |  |  |  |  | - | - | - | - | 1 | 477 | VCCIO2 |  |  |  |  |  | - | - | - | -
478 | PR20B | IO | 2 |  | Comp_OF_PR20A | RDQ17 | E30 | F26 | H17 | A4 | 1 | 478 | PR20B | IO | 2 |  | Comp_OF_PR20A | RDQ17 | E30 | F26 | H17 | A4
479 | PR20C | IO | 2 |  | True_OF_PR20D | RDQ17 | C32 | E23 | J17 | - | 1 | 479 | PR20C | IO | 2 |  | True_OF_PR20D | RDQ17 | C32 | E23 | J17 | -
480 | VSSIO2 |  |  |  |  |  | - | - | - | - | 1 | 480 | VSSIO2 |  |  |  |  |  | - | - | - | -
481 | PR20A | IO | 2 |  | True_OF_PR20B | RDQ17 | F30 | F25 | H18 | A6 | 1 | 481 | PR20A | IO | 2 |  | True_OF_PR20B | RDQ17 | F30 | F25 | H18 | A6
482 | PR17D | IO | 2 |  | Comp_OF_PR17C | RDQ17 | D31 | D26 | H16 | - | 1 | 482 | PR17D | IO | 2 |  | Comp_OF_PR17C | RDQ17 | D31 | D26 | H16 | -
483 | VSS |  |  |  |  |  | - | - | - | - | 1 | 483 | VSS |  |  |  |  |  | - | - | - | -
484 | PR17B | IO | 2 |  | Comp_OF_PR17A | RDQSN17 | C31 | E26 | G18 | A7 | 1 | 484 | PR17B | IO | 2 |  | Comp_OF_PR17A | RDQSN17 | C31 | E26 | G18 | A7
485 | PR17C | IO | 2 |  | True_OF_PR17D | RDQ17 | D30 | E24 | G16 | - | 1 | 485 | PR17C | IO | 2 |  | True_OF_PR17D | RDQ17 | D30 | E24 | G16 | -
486 | VCC |  |  |  |  |  | - | - | - | - | 1 | 486 | VCC |  |  |  |  |  | - | - | - | -
487 | PR17A | IO | 2 |  | True_OF_PR17B | RDQS17 | B32 | D25 | F17 | B6 | 1 | 487 | PR17A | IO | 2 |  | True_OF_PR17B | RDQS17 | B32 | D25 | F17 | B6
488 | PR14D | IO | 2 |  | Comp_OF_PR14C | RDQ17 | F28 | B24 | F18 | - | 1 | 488 | PR14D | IO | 2 |  | Comp_OF_PR14C | RDQ17 | F28 | B24 | F18 | -
489 | VSS |  |  |  |  |  | - | - | - | - | 1 | 489 | VSS |  |  |  |  |  | - | - | - | -
490 | PR14B | IO | 2 |  | Comp_OF_PR14A | RDQ17 | E29 | D24 | E17 | C6 | 1 | 490 | PR14B | IO | 2 |  | Comp_OF_PR14A | RDQ17 | E29 | D24 | E17 | C6
491 | PR14C | IO | 2 |  | True_OF_PR14D | RDQ17 | F29 | B26 | E18 | - | 1 | 491 | PR14C | IO | 2 |  | True_OF_PR14D | RDQ17 | F29 | B26 | E18 | -
492 | VCCAUX |  |  |  |  |  | - | - | - | - | 1 | 492 | VCCAUX |  |  |  |  |  | - | - | - | -
493 | PR14A | IO | 2 |  | True_OF_PR14B | RDQ17 | D29 | D23 | D18 | D6 | 1 | 493 | PR14A | IO | 2 |  | True_OF_PR14B | RDQ17 | D29 | D23 | D18 | D6
494 | PR11D | IO | 2 |  | Comp_OF_PR11C | RDQ17 | C30 | C24 | F16 | - | 1 | 494 | PR11D | IO | 2 |  | Comp_OF_PR11C | RDQ17 | C30 | C24 | F16 | -
495 | VCCIO2 |  |  |  |  |  | - | - | - | - | 1 | 495 | VCCIO2 |  |  |  |  |  | - | - | - | -
496 | PR11C | IO | 2 |  | True_OF_PR11D | RDQ17 | C29 | C23 | E16 | - | 1 | 496 | PR11C | IO | 2 |  | True_OF_PR11D | RDQ17 | C29 | C23 | E16 | -
497 | VSSIO2 |  |  |  |  |  | - | - | - | - | 1 | 497 | VSSIO2 |  |  |  |  |  | - | - | - | -
498 | PR11B | IO | 2 | URC_GPLL0C_IN | Comp_OF_PR11A | RDQ17 | D28 | C26 | D17 | B7 | 1 | 498 | PR11B | IO | 2 | URC_GPLL0C_IN | Comp_OF_PR11A | RDQ17 | D28 | C26 | D17 | B7
499 | PR11A | IO | 2 | URC_GPLL0T_IN | True_OF_PR11B | RDQ17 | C28 | C25 | C18 | C7 | 1 | 499 | PR11A | IO | 2 | URC_GPLL0T_IN | True_OF_PR11B | RDQ17 | C28 | C25 | C18 | C7
500 | NC24 |  |  |  |  |  | - | - | - | - | 1 | 500 | NC24 |  |  |  |  |  | - | - | - | -
501 | NC25 |  |  |  |  |  | - | - | - | - | 1 | 501 | NC25 |  |  |  |  |  | - | - | - | -
502 | NC26 |  |  |  |  |  | - | - | - | - | 1 | 502 | NC26 |  |  |  |  |  | - | - | - | -
503 | NC27 |  |  |  |  |  | - | - | - | - | 1 | 503 | NC27 |  |  |  |  |  | - | - | - | -
504 | NC29 |  |  |  |  |  | - | - | - | - | 1 | 504 | NC29 |  |  |  |  |  | - | - | - | -
505 | VSSPLL0_URC |  |  |  |  |  | - | - | - | - | 1 | 505 | VSSPLL0_URC |  |  |  |  |  | - | - | - | -
506 | VCCPLL0_URC |  |  |  |  |  | - | - | - | - | 1 | 506 | VCCPLL0_URC |  |  |  |  |  | - | - | - | -
507 | VSS |  |  |  |  |  | - | - | - | - | 1 | 507 | VSS |  |  |  |  |  | - | - | - | -
508 | VCC |  |  |  |  |  | - | - | - | - | 1 | 508 | VCC |  |  |  |  |  | - | - | - | -
509 | PT121B | IO | 1 | URC_GPLL1C_IN | Comp_OF_PT121A |  | B30 | A25 | B20 | C8 | 1 | 509 | PT121B | IO | 1 | URC_GPLL1C_IN | Comp_OF_PT121A |  | B30 | A25 | B20 | C8
510 | VCCIO1 |  |  |  |  |  | - | - | - | - | 1 | 510 | VCCIO1 |  |  |  |  |  | - | - | - | -
511 | PT119B | IO | 1 |  | Comp_OF_PT119A |  | A31 | B23 | B19 | - | 1 | 511 | PT119B | IO | 1 |  | Comp_OF_PT119A |  | A31 | B23 | B19 | -
512 | PT121A | IO | 1 | URC_GPLL1T_IN | True_OF_PT121B |  | B29 | A24 | A19 | B8 | 1 | 512 | PT121A | IO | 1 | URC_GPLL1T_IN | True_OF_PT121B |  | B29 | A24 | A19 | B8
513 | VSSIO1 |  |  |  |  |  | - | - | - | - | 1 | 513 | VSSIO1 |  |  |  |  |  | - | - | - | -
514 | PT119A | IO | 1 |  | True_OF_PT119B |  | A30 | A23 | A18 | - | 1 | 514 | PT119A | IO | 1 |  | True_OF_PT119B |  | A30 | A23 | A18 | -
515 | PT116B | IO | 1 |  | Comp_OF_PT116A |  | A29 | D22 | B18 | - | 1 | 515 | PT116B | IO | 1 |  | Comp_OF_PT116A |  | A29 | D22 | B18 | -
516 | VSS |  |  |  |  |  | - | - | - | - | 1 | 516 | VSS |  |  |  |  |  | - | - | - | -
517 | PT114B | IO | 1 |  | Comp_OF_PT114A |  | D26 | E21 | C17 | - | 1 | 517 | PT114B | IO | 1 |  | Comp_OF_PT114A |  | D26 | E21 | C17 | -
518 | PT116A | IO | 1 |  | True_OF_PT116B |  | A28 | C22 | A17 | - | 1 | 518 | PT116A | IO | 1 |  | True_OF_PT116B |  | A28 | C22 | A17 | -
519 | VCC |  |  |  |  |  | - | - | - | - | 1 | 519 | VCC |  |  |  |  |  | - | - | - | -
520 | PT114A | IO | 1 |  | True_OF_PT114B |  | C26 | D21 | B17 | - | 1 | 520 | PT114A | IO | 1 |  | True_OF_PT114B |  | C26 | D21 | B17 | -
521 | PT112B | IO | 1 |  | Comp_OF_PT112A |  | B26 | C21 | D16 | - | 1 | 521 | PT112B | IO | 1 |  | Comp_OF_PT112A |  | B26 | C21 | D16 | -
522 | VSS |  |  |  |  |  | - | - | - | - | 1 | 522 | VSS |  |  |  |  |  | - | - | - | -
523 | PT110B | IO | 1 |  | Comp_OF_PT110A |  | F25 | A22 | B16 | - | 1 | 523 | PT110B | IO | 1 |  | Comp_OF_PT110A |  | F25 | A22 | B16 | -
524 | PT112A | IO | 1 |  | True_OF_PT112B |  | A26 | B21 | C16 | - | 1 | 524 | PT112A | IO | 1 |  | True_OF_PT112B |  | A26 | B21 | C16 | -
525 | VCCAUX |  |  |  |  |  | - | - | - | - | 1 | 525 | VCCAUX |  |  |  |  |  | - | - | - | -
526 | PT110A | IO | 1 |  | True_OF_PT110B |  | E25 | A21 | A16 | - | 1 | 526 | PT110A | IO | 1 |  | True_OF_PT110B |  | E25 | A21 | A16 | -
527 | PT107B | IO | 1 |  | Comp_OF_PT107A |  | D25 | A19 | E15 | - | 1 | 527 | PT107B | IO | 1 |  | Comp_OF_PT107A |  | D25 | A19 | E15 | -
528 | VCCIO1 |  |  |  |  |  | - | - | - | - | 1 | 528 | VCCIO1 |  |  |  |  |  | - | - | - | -
529 | PT105B | IO | 1 |  | Comp_OF_PT105A |  | B25 | B19 | C15 | - | 1 | 529 | PT105B | IO | 1 |  | Comp_OF_PT105A |  | B25 | B19 | C15 | -
530 | PT107A | IO | 1 |  | True_OF_PT107B |  | C25 | A18 | D15 | - | 1 | 530 | PT107A | IO | 1 |  | True_OF_PT107B |  | C25 | A18 | D15 | -
531 | VSSIO1 |  |  |  |  |  | - | - | - | - | 1 | 531 | VSSIO1 |  |  |  |  |  | - | - | - | -
532 | PT105A | IO | 1 |  | True_OF_PT105B |  | A25 | C19 | B15 | - | 1 | 532 | PT105A | IO | 1 |  | True_OF_PT105B |  | A25 | C19 | B15 | -
533 | PT103B | IO | 1 |  | Comp_OF_PT103A |  | F24 | D19 | - | - | 1 | 533 | PT103B | IO | 1 |  | Comp_OF_PT103A |  | F24 | D19 | - | -
534 | VCCIO1 |  |  |  |  |  | - | - | - | - | 1 | 534 | VCCIO1 |  |  |  |  |  | - | - | - | -
535 | PT101B | IO | 1 |  | Comp_OF_PT101A |  | C24 | D18 | - | - | 1 | 535 | PT101B | IO | 1 |  | Comp_OF_PT101A |  | C24 | D18 | - | -
536 | PT103A | IO | 1 |  | True_OF_PT103B |  | D24 | E19 | A15 | - | 1 | 536 | PT103A | IO | 1 |  | True_OF_PT103B |  | D24 | E19 | A15 | -
537 | VSSIO1 |  |  |  |  |  | - | - | - | - | 1 | 537 | VSSIO1 |  |  |  |  |  | - | - | - | -
538 | PT101A | IO | 1 |  | True_OF_PT101B |  | A24 | C18 | - | - | 1 | 538 | PT101A | IO | 1 |  | True_OF_PT101B |  | A24 | C18 | - | -
539 | PT98B | IO | 1 |  | Comp_OF_PT98A |  | F23 | E17 | - | - | 1 | 539 | PT98B | IO | 1 |  | Comp_OF_PT98A |  | F23 | E17 | - | -
540 | VSS |  |  |  |  |  | - | - | - | - | 1 | 540 | VSS |  |  |  |  |  | - | - | - | -
541 | PT96B | IO | 1 |  | Comp_OF_PT96A |  | D23 | C17 | - | - | 1 | 541 | PT96B | IO | 1 |  | Comp_OF_PT96A |  | D23 | C17 | - | -
542 | PT98A | IO | 1 |  | True_OF_PT98B |  | E23 | D17 | - | - | 1 | 542 | PT98A | IO | 1 |  | True_OF_PT98B |  | E23 | D17 | - | -
543 | VCC |  |  |  |  |  | - | - | - | - | 1 | 543 | VCC |  |  |  |  |  | - | - | - | -
544 | PT96A | IO | 1 |  | True_OF_PT96B |  | C23 | B17 | - | - | 1 | 544 | PT96A | IO | 1 |  | True_OF_PT96B |  | C23 | B17 | - | -
545 | PT94B | IO | 1 |  | Comp_OF_PT94A |  | B23 | - | - | - | 1 | 545 | PT94B | IO | 1 |  | Comp_OF_PT94A |  | B23 | - | - | -
546 | VSS |  |  |  |  |  | - | - | - | - | 1 | 546 | VSS |  |  |  |  |  | - | - | - | -
547 | PT92B | IO | 1 |  | Comp_OF_PT92A |  | F22 | - | - | - | 1 | 547 | PT92B | IO | 1 |  | Comp_OF_PT92A |  | F22 | - | - | -
548 | PT94A | IO | 1 |  | True_OF_PT94B |  | A23 | - | - | - | 1 | 548 | PT94A | IO | 1 |  | True_OF_PT94B |  | A23 | - | - | -
549 | VCCAUX |  |  |  |  |  | - | - | - | - | 1 | 549 | VCCAUX |  |  |  |  |  | - | - | - | -
550 | PT92A | IO | 1 |  | True_OF_PT92B |  | E22 | - | - | - | 1 | 550 | PT92A | IO | 1 |  | True_OF_PT92B |  | E22 | - | - | -
551 | PT89B | IO | 1 |  | Comp_OF_PT89A |  | D22 | - | - | - | 1 | 551 | PT89B | IO | 1 |  | Comp_OF_PT89A |  | D22 | - | - | -
552 | VCCIO1 |  |  |  |  |  | - | - | - | - | 1 | 552 | VCCIO1 |  |  |  |  |  | - | - | - | -
553 | PT87B | IO | 1 |  | Comp_OF_PT87A |  | B22 | - | - | - | 1 | 553 | PT87B | IO | 1 |  | Comp_OF_PT87A |  | B22 | - | - | -
554 | PT89A | IO | 1 |  | True_OF_PT89B |  | C22 | - | - | - | 1 | 554 | PT89A | IO | 1 |  | True_OF_PT89B |  | C22 | - | - | -
555 | VSSIO1 |  |  |  |  |  | - | - | - | - | 1 | 555 | VSSIO1 |  |  |  |  |  | - | - | - | -
556 | PT87A | IO | 1 |  | True_OF_PT87B |  | A22 | - | - | - | 1 | 556 | PT87A | IO | 1 |  | True_OF_PT87B |  | A22 | - | - | -
557 | PT85B | IO | 1 |  | Comp_OF_PT85A |  | F20 | A17 | E14 | - | 1 | 557 | PT85B | IO | 1 |  | Comp_OF_PT85A |  | F20 | A17 | E14 | -
558 | VCCIO1 |  |  |  |  |  | - | - | - | - | 1 | 558 | VCCIO1 |  |  |  |  |  | - | - | - | -
559 | PT83B | IO | 1 |  | Comp_OF_PT83A |  | C20 | C16 | C14 | - | 1 | 559 | PT83B | IO | 1 |  | Comp_OF_PT83A |  | C20 | C16 | C14 | -
560 | PT85A | IO | 1 |  | True_OF_PT85B |  | D20 | A16 | D14 | - | 1 | 560 | PT85A | IO | 1 |  | True_OF_PT85B |  | D20 | A16 | D14 | -
561 | VSSIO1 |  |  |  |  |  | - | - | - | - | 1 | 561 | VSSIO1 |  |  |  |  |  | - | - | - | -
562 | PT83A | IO | 1 |  | True_OF_PT83B |  | A20 | B16 | A14 | - | 1 | 562 | PT83A | IO | 1 |  | True_OF_PT83B |  | A20 | B16 | A14 | -
563 | PT80B | IO | 1 |  | Comp_OF_PT80A |  | F19 | E16 | E13 | - | 1 | 563 | PT80B | IO | 1 |  | Comp_OF_PT80A |  | F19 | E16 | E13 | -
564 | VSS |  |  |  |  |  | - | - | - | - | 1 | 564 | VSS |  |  |  |  |  | - | - | - | -
565 | PT78B | IO | 1 |  | Comp_OF_PT78A |  | D19 | A15 | C13 | - | 1 | 565 | PT78B | IO | 1 |  | Comp_OF_PT78A |  | D19 | A15 | C13 | -
566 | PT80A | IO | 1 |  | True_OF_PT80B |  | E19 | D16 | D13 | - | 1 | 566 | PT80A | IO | 1 |  | True_OF_PT80B |  | E19 | D16 | D13 | -
567 | VCC |  |  |  |  |  | - | - | - | - | 1 | 567 | VCC |  |  |  |  |  | - | - | - | -
568 | PT78A | IO | 1 |  | True_OF_PT78B |  | C19 | A14 | B13 | - | 1 | 568 | PT78A | IO | 1 |  | True_OF_PT78B |  | C19 | A14 | B13 | -
569 | PT76B | IO | 1 |  | Comp_OF_PT76A |  | B19 | B14 | A13 | - | 1 | 569 | PT76B | IO | 1 |  | Comp_OF_PT76A |  | B19 | B14 | A13 | -
570 | VCCIO1 |  |  |  |  |  | - | - | - | - | 1 | 570 | VCCIO1 |  |  |  |  |  | - | - | - | -
571 | PT74B | IO | 1 |  | Comp_OF_PT74A |  | F18 | C14 | E12 | - | 1 | 571 | PT74B | IO | 1 |  | Comp_OF_PT74A |  | F18 | C14 | E12 | -
572 | PT76A | IO | 1 |  | True_OF_PT76B |  | A19 | B13 | A12 | - | 1 | 572 | PT76A | IO | 1 |  | True_OF_PT76B |  | A19 | B13 | A12 | -
573 | VSSIO1 |  |  |  |  |  | - | - | - | - | 1 | 573 | VSSIO1 |  |  |  |  |  | - | - | - | -
574 | PT74A | IO | 1 |  | True_OF_PT74B |  | D18 | C13 | D12 | - | 1 | 574 | PT74A | IO | 1 |  | True_OF_PT74B |  | D18 | C13 | D12 | -
575 | PT71B | IO | 1 | PCLKC1_0 | Comp_OF_PT71A |  | C18 | D14 | C12 | A8 | 1 | 575 | PT71B | IO | 1 | PCLKC1_0 | Comp_OF_PT71A |  | C18 | D14 | C12 | A8
576 | VSS |  |  |  |  |  | - | - | - | - | 1 | 576 | VSS |  |  |  |  |  | - | - | - | -
577 | PT69B | IO | 1 | PCLKC1_1 | Comp_OF_PT69A |  | F17 | E14 | E11 | C9 | 1 | 577 | PT69B | IO | 1 | PCLKC1_1 | Comp_OF_PT69A |  | F17 | E14 | E11 | C9
578 | PT71A | IO | 1 | PCLKT1_0 | True_OF_PT71B |  | A18 | D13 | B12 | A9 | 1 | 578 | PT71A | IO | 1 | PCLKT1_0 | True_OF_PT71B |  | A18 | D13 | B12 | A9
579 | VCC |  |  |  |  |  | - | - | - | - | 1 | 579 | VCC |  |  |  |  |  | - | - | - | -
580 | PT69A | IO | 1 | PCLKT1_1 | True_OF_PT69B |  | E17 | E13 | D11 | B9 | 1 | 580 | PT69A | IO | 1 | PCLKT1_1 | True_OF_PT69B |  | E17 | E13 | D11 | B9
581 | VSS |  |  |  |  |  | - | - | - | - | 1 | 581 | VSS |  |  |  |  |  | - | - | - | -
582 | VCC |  |  |  |  |  | - | - | - | - | 1 | 582 | VCC |  |  |  |  |  | - | - | - | -
583 | PT65B | IO | 0 | PCLKC0_0 | Comp_OF_PT65A |  | D17 | A13 | C11 | C10 | 1 | 583 | PT65B | IO | 0 | PCLKC0_0 | Comp_OF_PT65A |  | D17 | A13 | C11 | C10
584 | VCCIO0 |  |  |  |  |  | - | - | - | - | 1 | 584 | VCCIO0 |  |  |  |  |  | - | - | - | -
585 | PT63B | IO | 0 | PCLKC0_1 | Comp_OF_PT63A |  | B17 | D11 | A11 | A10 | 1 | 585 | PT63B | IO | 0 | PCLKC0_1 | Comp_OF_PT63A |  | B17 | D11 | A11 | A10
586 | PT65A | IO | 0 | PCLKT0_0 | True_OF_PT65B |  | C17 | A12 | B11 | B10 | 1 | 586 | PT65A | IO | 0 | PCLKT0_0 | True_OF_PT65B |  | C17 | A12 | B11 | B10
587 | VSSIO0 |  |  |  |  |  | - | - | - | - | 1 | 587 | VSSIO0 |  |  |  |  |  | - | - | - | -
588 | PT63A | IO | 0 | PCLKT0_1 | True_OF_PT63B |  | A17 | E11 | A10 | A11 | 1 | 588 | PT63A | IO | 0 | PCLKT0_1 | True_OF_PT63B |  | A17 | E11 | A10 | A11
589 | PT60B | IO | 0 |  | Comp_OF_PT60A |  | A16 | B11 | B10 | - | 1 | 589 | PT60B | IO | 0 |  | Comp_OF_PT60A |  | A16 | B11 | B10 | -
590 | VSS |  |  |  |  |  | - | - | - | - | 1 | 590 | VSS |  |  |  |  |  | - | - | - | -
591 | PT58B | IO | 0 |  | Comp_OF_PT58A |  | C16 | A11 | C10 | - | 1 | 591 | PT58B | IO | 0 |  | Comp_OF_PT58A |  | C16 | A11 | C10 | -
592 | PT60A | IO | 0 |  | True_OF_PT60B |  | B16 | C11 | A9 | - | 1 | 592 | PT60A | IO | 0 |  | True_OF_PT60B |  | B16 | C11 | A9 | -
593 | VCC |  |  |  |  |  | - | - | - | - | 1 | 593 | VCC |  |  |  |  |  | - | - | - | -
594 | PT58A | IO | 0 |  | True_OF_PT58B |  | D16 | A10 | B9 | - | 1 | 594 | PT58A | IO | 0 |  | True_OF_PT58B |  | D16 | A10 | B9 | -
595 | PT56B | IO | 0 |  | Comp_OF_PT56A |  | E16 | B10 | E10 | - | 1 | 595 | PT56B | IO | 0 |  | Comp_OF_PT56A |  | E16 | B10 | E10 | -
596 | VSS |  |  |  |  |  | - | - | - | - | 1 | 596 | VSS |  |  |  |  |  | - | - | - | -
597 | PT54B | IO | 0 |  | Comp_OF_PT54A |  | A15 | D10 | - | - | 1 | 597 | PT54B | IO | 0 |  | Comp_OF_PT54A |  | A15 | D10 | - | -
598 | PT56A | IO | 0 |  | True_OF_PT56B |  | F16 | C10 | D10 | - | 1 | 598 | PT56A | IO | 0 |  | True_OF_PT56B |  | F16 | C10 | D10 | -
599 | VCCAUX |  |  |  |  |  | - | - | - | - | 1 | 599 | VCCAUX |  |  |  |  |  | - | - | - | -
600 | PT54A | IO | 0 |  | True_OF_PT54B |  | C15 | E10 | C9 | - | 1 | 600 | PT54A | IO | 0 |  | True_OF_PT54B |  | C15 | E10 | C9 | -
601 | PT51B | IO | 0 |  | Comp_OF_PT51A |  | D15 | C9 | - | - | 1 | 601 | PT51B | IO | 0 |  | Comp_OF_PT51A |  | D15 | C9 | - | -
602 | VCCIO0 |  |  |  |  |  | - | - | - | - | 1 | 602 | VCCIO0 |  |  |  |  |  | - | - | - | -
603 | PT49B | IO | 0 |  | Comp_OF_PT49A |  | A14 | D8 | - | - | 1 | 603 | PT49B | IO | 0 |  | Comp_OF_PT49A |  | A14 | D8 | - | -
604 | PT51A | IO | 0 |  | True_OF_PT51B |  | F15 | D9 | - | - | 1 | 604 | PT51A | IO | 0 |  | True_OF_PT51B |  | F15 | D9 | - | -
605 | VSSIO0 |  |  |  |  |  | - | - | - | - | 1 | 605 | VSSIO0 |  |  |  |  |  | - | - | - | -
606 | PT49A | IO | 0 |  | True_OF_PT49B |  | B14 | E8 | - | - | 1 | 606 | PT49A | IO | 0 |  | True_OF_PT49B |  | B14 | E8 | - | -
607 | PT47B | IO | 0 |  | Comp_OF_PT47A |  | C14 | - | - | - | 1 | 607 | PT47B | IO | 0 |  | Comp_OF_PT47A |  | C14 | - | - | -
608 | VCCIO0 |  |  |  |  |  | - | - | - | - | 1 | 608 | VCCIO0 |  |  |  |  |  | - | - | - | -
609 | PT45B | IO | 0 |  | Comp_OF_PT45A |  | E14 | - | - | - | 1 | 609 | PT45B | IO | 0 |  | Comp_OF_PT45A |  | E14 | - | - | -
610 | PT47A | IO | 0 |  | True_OF_PT47B |  | D14 | - | - | - | 1 | 610 | PT47A | IO | 0 |  | True_OF_PT47B |  | D14 | - | - | -
611 | VSSIO0 |  |  |  |  |  | - | - | - | - | 1 | 611 | VSSIO0 |  |  |  |  |  | - | - | - | -
612 | PT45A | IO | 0 |  | True_OF_PT45B |  | F14 | - | - | - | 1 | 612 | PT45A | IO | 0 |  | True_OF_PT45B |  | F14 | - | - | -
613 | PT42B | IO | 0 |  | Comp_OF_PT42A |  | A13 | - | - | - | 1 | 613 | PT42B | IO | 0 |  | Comp_OF_PT42A |  | A13 | - | - | -
614 | VSS |  |  |  |  |  | - | - | - | - | 1 | 614 | VSS |  |  |  |  |  | - | - | - | -
615 | PT40B | IO | 0 |  | Comp_OF_PT40A |  | D13 | - | - | - | 1 | 615 | PT40B | IO | 0 |  | Comp_OF_PT40A |  | D13 | - | - | -
616 | PT42A | IO | 0 |  | True_OF_PT42B |  | C13 | - | - | - | 1 | 616 | PT42A | IO | 0 |  | True_OF_PT42B |  | C13 | - | - | -
617 | VCC |  |  |  |  |  | - | - | - | - | 1 | 617 | VCC |  |  |  |  |  | - | - | - | -
618 | PT40A | IO | 0 |  | True_OF_PT40B |  | F13 | - | - | - | 1 | 618 | PT40A | IO | 0 |  | True_OF_PT40B |  | F13 | - | - | -
619 | PT38B | IO | 0 |  | Comp_OF_PT38A |  | A11 | - | - | - | 1 | 619 | PT38B | IO | 0 |  | Comp_OF_PT38A |  | A11 | - | - | -
620 | VSS |  |  |  |  |  | - | - | - | - | 1 | 620 | VSS |  |  |  |  |  | - | - | - | -
621 | PT36B | IO | 0 |  | Comp_OF_PT36A |  | C11 | - | - | - | 1 | 621 | PT36B | IO | 0 |  | Comp_OF_PT36A |  | C11 | - | - | -
622 | PT38A | IO | 0 |  | True_OF_PT38B |  | B11 | - | - | - | 1 | 622 | PT38A | IO | 0 |  | True_OF_PT38B |  | B11 | - | - | -
623 | VCCAUX |  |  |  |  |  | - | - | - | - | 1 | 623 | VCCAUX |  |  |  |  |  | - | - | - | -
624 | PT36A | IO | 0 |  | True_OF_PT36B |  | D11 | - | - | - | 1 | 624 | PT36A | IO | 0 |  | True_OF_PT36B |  | D11 | - | - | -
625 | PT33B | IO | 0 |  | Comp_OF_PT33A |  | E11 | - | - | - | 1 | 625 | PT33B | IO | 0 |  | Comp_OF_PT33A |  | E11 | - | - | -
626 | VCCIO0 |  |  |  |  |  | - | - | - | - | 1 | 626 | VCCIO0 |  |  |  |  |  | - | - | - | -
627 | PT31B | IO | 0 |  | Comp_OF_PT31A |  | A10 | - | - | - | 1 | 627 | PT31B | IO | 0 |  | Comp_OF_PT31A |  | A10 | - | - | -
628 | PT33A | IO | 0 |  | True_OF_PT33B |  | F11 | - | - | - | 1 | 628 | PT33A | IO | 0 |  | True_OF_PT33B |  | F11 | - | - | -
629 | VSSIO0 |  |  |  |  |  | - | - | - | - | 1 | 629 | VSSIO0 |  |  |  |  |  | - | - | - | -
630 | PT31A | IO | 0 |  | True_OF_PT31B |  | B10 | - | - | - | 1 | 630 | PT31A | IO | 0 |  | True_OF_PT31B |  | B10 | - | - | -
631 | PT29B | IO | 0 |  | Comp_OF_PT29A |  | C10 | - | - | - | 1 | 631 | PT29B | IO | 0 |  | Comp_OF_PT29A |  | C10 | - | - | -
632 | VCCIO0 |  |  |  |  |  | - | - | - | - | 1 | 632 | VCCIO0 |  |  |  |  |  | - | - | - | -
633 | PT27B | IO | 0 |  | Comp_OF_PT27A |  | E10 | - | - | - | 1 | 633 | PT27B | IO | 0 |  | Comp_OF_PT27A |  | E10 | - | - | -
634 | PT29A | IO | 0 |  | True_OF_PT29B |  | D10 | - | - | - | 1 | 634 | PT29A | IO | 0 |  | True_OF_PT29B |  | D10 | - | - | -
635 | VSSIO0 |  |  |  |  |  | - | - | - | - | 1 | 635 | VSSIO0 |  |  |  |  |  | - | - | - | -
636 | PT27A | IO | 0 |  | True_OF_PT27B |  | F10 | - | - | - | 1 | 636 | PT27A | IO | 0 |  | True_OF_PT27B |  | F10 | - | - | -
637 | PT24B | IO | 0 |  | Comp_OF_PT24A |  | A9 | - | - | - | 1 | 637 | PT24B | IO | 0 |  | Comp_OF_PT24A |  | A9 | - | - | -
638 | VSS |  |  |  |  |  | - | - | - | - | 1 | 638 | VSS |  |  |  |  |  | - | - | - | -
639 | PT22B | IO | 0 |  | Comp_OF_PT22A |  | D9 | - | - | - | 1 | 639 | PT22B | IO | 0 |  | Comp_OF_PT22A |  | D9 | - | - | -
640 | PT24A | IO | 0 |  | True_OF_PT24B |  | C9 | - | - | - | 1 | 640 | PT24A | IO | 0 |  | True_OF_PT24B |  | C9 | - | - | -
641 | VCC |  |  |  |  |  | - | - | - | - | 1 | 641 | VCC |  |  |  |  |  | - | - | - | -
642 | PT22A | IO | 0 |  | True_OF_PT22B |  | F9 | - | - | - | 1 | 642 | PT22A | IO | 0 |  | True_OF_PT22B |  | F9 | - | - | -
643 | PT20B | IO | 0 |  | Comp_OF_PT20A |  | A8 | C8 | E9 | - | 1 | 643 | PT20B | IO | 0 |  | Comp_OF_PT20A |  | A8 | C8 | E9 | -
644 | VSS |  |  |  |  |  | - | - | - | - | 1 | 644 | VSS |  |  |  |  |  | - | - | - | -
645 | PT18B | IO | 0 |  | Comp_OF_PT18A |  | C8 | A9 | A8 | - | 1 | 645 | PT18B | IO | 0 |  | Comp_OF_PT18A |  | C8 | A9 | A8 | -
646 | PT20A | IO | 0 |  | True_OF_PT20B |  | B8 | B8 | D9 | - | 1 | 646 | PT20A | IO | 0 |  | True_OF_PT20B |  | B8 | B8 | D9 | -
647 | VCCAUX |  |  |  |  |  | - | - | - | - | 1 | 647 | VCCAUX |  |  |  |  |  | - | - | - | -
648 | PT18A | IO | 0 |  | True_OF_PT18B |  | D8 | A8 | A7 | - | 1 | 648 | PT18A | IO | 0 |  | True_OF_PT18B |  | D8 | A8 | A7 | -
649 | PT15B | IO | 0 |  | Comp_OF_PT15A |  | E8 | A6 | B8 | - | 1 | 649 | PT15B | IO | 0 |  | Comp_OF_PT15A |  | E8 | A6 | B8 | -
650 | VCCIO0 |  |  |  |  |  | - | - | - | - | 1 | 650 | VCCIO0 |  |  |  |  |  | - | - | - | -
651 | PT13B | IO | 0 |  | Comp_OF_PT13A |  | A7 | B6 | D8 | - | 1 | 651 | PT13B | IO | 0 |  | Comp_OF_PT13A |  | A7 | B6 | D8 | -
652 | PT15A | IO | 0 |  | True_OF_PT15B |  | F8 | A5 | C8 | - | 1 | 652 | PT15A | IO | 0 |  | True_OF_PT15B |  | F8 | A5 | C8 | -
653 | VSSIO0 |  |  |  |  |  | - | - | - | - | 1 | 653 | VSSIO0 |  |  |  |  |  | - | - | - | -
654 | PT13A | IO | 0 |  | True_OF_PT13B |  | B7 | C6 | E8 | - | 1 | 654 | PT13A | IO | 0 |  | True_OF_PT13B |  | B7 | C6 | E8 | -
655 | PT11B | IO | 0 |  | Comp_OF_PT11A |  | C7 | D6 | C7 | - | 1 | 655 | PT11B | IO | 0 |  | Comp_OF_PT11A |  | C7 | D6 | C7 | -
656 | VCCIO0 |  |  |  |  |  | - | - | - | - | 1 | 656 | VCCIO0 |  |  |  |  |  | - | - | - | -
657 | PT9B | IO | 0 |  | Comp_OF_PT9A |  | A5 | C5 | D7 | - | 1 | 657 | PT9B | IO | 0 |  | Comp_OF_PT9A |  | A5 | C5 | D7 | -
658 | PT11A | IO | 0 |  | True_OF_PT11B |  | D7 | E6 | C6 | - | 1 | 658 | PT11A | IO | 0 |  | True_OF_PT11B |  | D7 | E6 | C6 | -
659 | VSSIO0 |  |  |  |  |  | - | - | - | - | 1 | 659 | VSSIO0 |  |  |  |  |  | - | - | - | -
660 | PT9A | IO | 0 |  | True_OF_PT9B |  | A4 | D5 | E7 | - | 1 | 660 | PT9A | IO | 0 |  | True_OF_PT9B |  | A4 | D5 | E7 | -
661 | PT6B | IO | 0 |  | Comp_OF_PT6A |  | A3 | A4 | D6 | - | 1 | 661 | PT6B | IO | 0 |  | Comp_OF_PT6A |  | A3 | A4 | D6 | -
662 | VSS |  |  |  |  |  | - | - | - | - | 1 | 662 | VSS |  |  |  |  |  | - | - | - | -
663 | PT4B | IO | 0 | ULC_GPLL1C_IN | Comp_OF_PT4A |  | B4 | A3 | B6 | C11 | 1 | 663 | PT4B | IO | 0 | ULC_GPLL1C_IN | Comp_OF_PT4A |  | B4 | A3 | B6 | C11
664 | PT6A | IO | 0 |  | True_OF_PT6B |  | A2 | B4 | E6 | - | 1 | 664 | PT6A | IO | 0 |  | True_OF_PT6B |  | A2 | B4 | E6 | -
665 | VCC |  |  |  |  |  | - | - | - | - | 1 | 665 | VCC |  |  |  |  |  | - | - | - | -
666 | PT4A | IO | 0 | ULC_GPLL1T_IN | True_OF_PT4B |  | B3 | A2 | A6 | B11 | 1 | 666 | PT4A | IO | 0 | ULC_GPLL1T_IN | True_OF_PT4B |  | B3 | A2 | A6 | B11
667 | VSS |  |  |  |  |  | - | - | - | - | 1 | 667 | VSS |  |  |  |  |  | - | - | - | -
668 | VCC |  |  |  |  |  | - | - | - | - | 1 | 668 | VCC |  |  |  |  |  | - | - | - | -
669 | VCCPLL0_ULC |  |  |  |  |  | - | - | - | - | 1 | 669 | VCCPLL0_ULC |  |  |  |  |  | - | - | - | -
670 | VSSPLL0_ULC |  |  |  |  |  | - | - | - | - | 1 | 670 | VSSPLL0_ULC |  |  |  |  |  | - | - | - | -
0 | NC | Unused |  |  |  |  | - | F19 | - | - | 1 | 0 | NC | Unused |  |  |  |  | - | F19 | - | -
0 | GND |  |  |  |  |  | B31 | B25 | C19 | G2 | 1 | 0 | GND |  |  |  |  |  | B31 | B25 | C19 | G2
0 | GND |  |  |  |  |  | E31 | E25 | H19 | L2 | 1 | 0 | GND |  |  |  |  |  | E31 | E25 | H19 | L2
0 | GND |  |  |  |  |  | J31 | J25 | R19 | B3 | 1 | 0 | GND |  |  |  |  |  | J31 | J25 | R19 | B3
0 | GND |  |  |  |  |  | N31 | M25 | G17 | E5 | 1 | 0 | GND |  |  |  |  |  | N31 | M25 | G17 | E5
0 | GND |  |  |  |  |  | R31 | R25 | M16 | F5 | 1 | 0 | GND |  |  |  |  |  | R31 | R25 | M16 | F5
0 | GND |  |  |  |  |  | V31 | V25 | G15 | K5 | 1 | 0 | GND |  |  |  |  |  | V31 | V25 | G15 | K5
0 | GND |  |  |  |  |  | Y31 | AC25 | K15 | L5 | 1 | 0 | GND |  |  |  |  |  | Y31 | AC25 | K15 | L5
0 | GND |  |  |  |  |  | AD31 | B22 | N15 | F6 | 1 | 0 | GND |  |  |  |  |  | AD31 | B22 | N15 | F6
0 | GND |  |  |  |  |  | AH31 | E22 | B14 | G6 | 1 | 0 | GND |  |  |  |  |  | AH31 | E22 | B14 | G6
0 | GND |  |  |  |  |  | AL31 | J22 | F14 | H6 | 1 | 0 | GND |  |  |  |  |  | AL31 | J22 | F14 | H6
0 | GND |  |  |  |  |  | AH29 | M22 | G14 | J6 | 1 | 0 | GND |  |  |  |  |  | AH29 | M22 | G14 | J6
0 | GND |  |  |  |  |  | AL29 | R22 | J14 | K6 | 1 | 0 | GND |  |  |  |  |  | AL29 | R22 | J14 | K6
0 | GND |  |  |  |  |  | B28 | V22 | K14 | L6 | 1 | 0 | GND |  |  |  |  |  | B28 | V22 | K14 | L6
0 | GND |  |  |  |  |  | E28 | H19 | M14 | M6 | 1 | 0 | GND |  |  |  |  |  | E28 | H19 | M14 | M6
0 | GND |  |  |  |  |  | J28 | B18 | N14 | E7 | 1 | 0 | GND |  |  |  |  |  | J28 | B18 | N14 | E7
0 | GND |  |  |  |  |  | N28 | E18 | P14 | F7 | 1 | 0 | GND |  |  |  |  |  | N28 | E18 | P14 | F7
0 | GND |  |  |  |  |  | R28 | J18 | F13 | G7 | 1 | 0 | GND |  |  |  |  |  | R28 | J18 | F13 | G7
0 | GND |  |  |  |  |  | V28 | K18 | G13 | H7 | 1 | 0 | GND |  |  |  |  |  | V28 | K18 | G13 | H7
0 | GND |  |  |  |  |  | AD28 | L18 | P13 | J7 | 1 | 0 | GND |  |  |  |  |  | AD28 | L18 | P13 | J7
0 | GND |  |  |  |  |  | B24 | M18 | G12 | K7 | 1 | 0 | GND |  |  |  |  |  | B24 | M18 | G12 | K7
0 | GND |  |  |  |  |  | E24 | N18 | J12 | L7 | 1 | 0 | GND |  |  |  |  |  | E24 | N18 | J12 | L7
0 | GND |  |  |  |  |  | K23 | P18 | K12 | M7 | 1 | 0 | GND |  |  |  |  |  | K23 | P18 | K12 | M7
0 | GND |  |  |  |  |  | L23 | R18 | L12 | N7 | 1 | 0 | GND |  |  |  |  |  | L23 | R18 | L12 | N7
0 | GND |  |  |  |  |  | K22 | T18 | M12 | E8 | 1 | 0 | GND |  |  |  |  |  | K22 | T18 | M12 | E8
0 | GND |  |  |  |  |  | L22 | U18 | P12 | F8 | 1 | 0 | GND |  |  |  |  |  | L22 | U18 | P12 | F8
0 | GND |  |  |  |  |  | M22 | W18 | G11 | G8 | 1 | 0 | GND |  |  |  |  |  | M22 | W18 | G11 | G8
0 | GND |  |  |  |  |  | N22 | J17 | J11 | H8 | 1 | 0 | GND |  |  |  |  |  | N22 | J17 | J11 | H8
0 | GND |  |  |  |  |  | P22 | K17 | K11 | J8 | 1 | 0 | GND |  |  |  |  |  | P22 | K17 | K11 | J8
0 | GND |  |  |  |  |  | R22 | U17 | L11 | K8 | 1 | 0 | GND |  |  |  |  |  | R22 | U17 | L11 | K8
0 | GND |  |  |  |  |  | T22 | V17 | M11 | L8 | 1 | 0 | GND |  |  |  |  |  | T22 | V17 | M11 | L8
0 | GND |  |  |  |  |  | U22 | J16 | P11 | M8 | 1 | 0 | GND |  |  |  |  |  | U22 | J16 | P11 | M8
0 | GND |  |  |  |  |  | V22 | L16 | G10 | N8 | 1 | 0 | GND |  |  |  |  |  | V22 | L16 | G10 | N8
0 | GND |  |  |  |  |  | W22 | M16 | J10 | E9 | 1 | 0 | GND |  |  |  |  |  | W22 | M16 | J10 | E9
0 | GND |  |  |  |  |  | Y22 | N16 | K10 | F9 | 1 | 0 | GND |  |  |  |  |  | Y22 | N16 | K10 | F9
0 | GND |  |  |  |  |  | AA22 | P16 | L10 | G9 | 1 | 0 | GND |  |  |  |  |  | AA22 | P16 | L10 | G9
0 | GND |  |  |  |  |  | AB22 | R16 | M10 | H9 | 1 | 0 | GND |  |  |  |  |  | AB22 | R16 | M10 | H9
0 | GND |  |  |  |  |  | L21 | U16 | G9 | J9 | 1 | 0 | GND |  |  |  |  |  | L21 | U16 | G9 | J9
0 | GND |  |  |  |  |  | AB21 | V16 | J9 | K9 | 1 | 0 | GND |  |  |  |  |  | AB21 | V16 | J9 | K9
0 | GND |  |  |  |  |  | AC21 | B15 | K9 | L9 | 1 | 0 | GND |  |  |  |  |  | AC21 | B15 | K9 | L9
0 | GND |  |  |  |  |  | B20 | E15 | L9 | M9 | 1 | 0 | GND |  |  |  |  |  | B20 | E15 | L9 | M9
0 | GND |  |  |  |  |  | E20 | J15 | M9 | N9 | 1 | 0 | GND |  |  |  |  |  | E20 | J15 | M9 | N9
0 | GND |  |  |  |  |  | L20 | L15 | F8 | E10 | 1 | 0 | GND |  |  |  |  |  | L20 | L15 | F8 | E10
0 | GND |  |  |  |  |  | N20 | M15 | G8 | F10 | 1 | 0 | GND |  |  |  |  |  | N20 | M15 | G8 | F10
0 | GND |  |  |  |  |  | P20 | N15 | P8 | G10 | 1 | 0 | GND |  |  |  |  |  | P20 | N15 | P8 | G10
0 | GND |  |  |  |  |  | R20 | P15 | B7 | H10 | 1 | 0 | GND |  |  |  |  |  | R20 | P15 | B7 | H10
0 | GND |  |  |  |  |  | T20 | R15 | F7 | J10 | 1 | 0 | GND |  |  |  |  |  | T20 | R15 | F7 | J10
0 | GND |  |  |  |  |  | U20 | U15 | G7 | K10 | 1 | 0 | GND |  |  |  |  |  | U20 | U15 | G7 | K10
0 | GND |  |  |  |  |  | V20 | V15 | J7 | L10 | 1 | 0 | GND |  |  |  |  |  | V20 | V15 | J7 | L10
0 | GND |  |  |  |  |  | W20 | J14 | K7 | M10 | 1 | 0 | GND |  |  |  |  |  | W20 | J14 | K7 | M10
0 | GND |  |  |  |  |  | Y20 | L14 | M7 | N10 | 1 | 0 | GND |  |  |  |  |  | Y20 | L14 | M7 | N10
0 | GND |  |  |  |  |  | AB20 | M14 | N7 | E11 | 1 | 0 | GND |  |  |  |  |  | AB20 | M14 | N7 | E11
0 | GND |  |  |  |  |  | L19 | N14 | P7 | F11 | 1 | 0 | GND |  |  |  |  |  | L19 | N14 | P7 | F11
0 | GND |  |  |  |  |  | N19 | P14 | G6 | G11 | 1 | 0 | GND |  |  |  |  |  | N19 | P14 | G6 | G11
0 | GND |  |  |  |  |  | P19 | R14 | K6 | H11 | 1 | 0 | GND |  |  |  |  |  | P19 | R14 | K6 | H11
0 | GND |  |  |  |  |  | R19 | U14 | N6 | J11 | 1 | 0 | GND |  |  |  |  |  | R19 | U14 | N6 | J11
0 | GND |  |  |  |  |  | T19 | V14 | D4 | K11 | 1 | 0 | GND |  |  |  |  |  | T19 | V14 | D4 | K11
0 | GND |  |  |  |  |  | U19 | J13 | G4 | L11 | 1 | 0 | GND |  |  |  |  |  | U19 | J13 | G4 | L11
0 | GND |  |  |  |  |  | V19 | L13 | J2 | M11 | 1 | 0 | GND |  |  |  |  |  | V19 | L13 | J2 | M11
0 | GND |  |  |  |  |  | W19 | M13 | M2 | N11 | 1 | 0 | GND |  |  |  |  |  | W19 | M13 | M2 | N11
0 | GND |  |  |  |  |  | Y19 | N13 | - | E12 | 1 | 0 | GND |  |  |  |  |  | Y19 | N13 | - | E12
0 | GND |  |  |  |  |  | AB19 | P13 | - | F12 | 1 | 0 | GND |  |  |  |  |  | AB19 | P13 | - | F12
0 | GND |  |  |  |  |  | B18 | R13 | - | G12 | 1 | 0 | GND |  |  |  |  |  | B18 | R13 | - | G12
0 | GND |  |  |  |  |  | E18 | U13 | - | H12 | 1 | 0 | GND |  |  |  |  |  | E18 | U13 | - | H12
0 | GND |  |  |  |  |  | L18 | V13 | - | J12 | 1 | 0 | GND |  |  |  |  |  | L18 | V13 | - | J12
0 | GND |  |  |  |  |  | N18 | B12 | - | K12 | 1 | 0 | GND |  |  |  |  |  | N18 | B12 | - | K12
0 | GND |  |  |  |  |  | P18 | E12 | - | L12 | 1 | 0 | GND |  |  |  |  |  | P18 | E12 | - | L12
0 | GND |  |  |  |  |  | R18 | J12 | - | M12 | 1 | 0 | GND |  |  |  |  |  | R18 | J12 | - | M12
0 | GND |  |  |  |  |  | T18 | L12 | - | N12 | 1 | 0 | GND |  |  |  |  |  | T18 | L12 | - | N12
0 | GND |  |  |  |  |  | U18 | M12 | - | F13 | 1 | 0 | GND |  |  |  |  |  | U18 | M12 | - | F13
0 | GND |  |  |  |  |  | V18 | N12 | - | G13 | 1 | 0 | GND |  |  |  |  |  | V18 | N12 | - | G13
0 | GND |  |  |  |  |  | W18 | P12 | - | H13 | 1 | 0 | GND |  |  |  |  |  | W18 | P12 | - | H13
0 | GND |  |  |  |  |  | Y18 | R12 | - | J13 | 1 | 0 | GND |  |  |  |  |  | Y18 | R12 | - | J13
0 | GND |  |  |  |  |  | AB18 | U12 | - | K13 | 1 | 0 | GND |  |  |  |  |  | AB18 | U12 | - | K13
0 | GND |  |  |  |  |  | L17 | V12 | - | L13 | 1 | 0 | GND |  |  |  |  |  | L17 | V12 | - | L13
0 | GND |  |  |  |  |  | N17 | J11 | - | M13 | 1 | 0 | GND |  |  |  |  |  | N17 | J11 | - | M13
0 | GND |  |  |  |  |  | P17 | L11 | - | E14 | 1 | 0 | GND |  |  |  |  |  | P17 | L11 | - | E14
0 | GND |  |  |  |  |  | R17 | M11 | - | F14 | 1 | 0 | GND |  |  |  |  |  | R17 | M11 | - | F14
0 | GND |  |  |  |  |  | T17 | N11 | - | K14 | 1 | 0 | GND |  |  |  |  |  | T17 | N11 | - | K14
0 | GND |  |  |  |  |  | U17 | P11 | - | L14 | 1 | 0 | GND |  |  |  |  |  | U17 | P11 | - | L14
0 | GND |  |  |  |  |  | V17 | R11 | - | B16 | 1 | 0 | GND |  |  |  |  |  | V17 | R11 | - | B16
0 | GND |  |  |  |  |  | W17 | U11 | - | T16 | 1 | 0 | GND |  |  |  |  |  | W17 | U11 | - | T16
0 | GND |  |  |  |  |  | Y17 | J10 | - | G17 | 1 | 0 | GND |  |  |  |  |  | Y17 | J10 | - | G17
0 | GND |  |  |  |  |  | AB17 | K10 | - | L17 | 1 | 0 | GND |  |  |  |  |  | AB17 | K10 | - | L17
0 | GND |  |  |  |  |  | L16 | U10 | - | - | 1 | 0 | GND |  |  |  |  |  | L16 | U10 | - | -
0 | GND |  |  |  |  |  | N16 | B9 | - | - | 1 | 0 | GND |  |  |  |  |  | N16 | B9 | - | -
0 | GND |  |  |  |  |  | P16 | E9 | - | - | 1 | 0 | GND |  |  |  |  |  | P16 | E9 | - | -
0 | GND |  |  |  |  |  | R16 | H9 | - | - | 1 | 0 | GND |  |  |  |  |  | R16 | H9 | - | -
0 | GND |  |  |  |  |  | T16 | J9 | - | - | 1 | 0 | GND |  |  |  |  |  | T16 | J9 | - | -
0 | GND |  |  |  |  |  | U16 | K9 | - | - | 1 | 0 | GND |  |  |  |  |  | U16 | K9 | - | -
0 | GND |  |  |  |  |  | V16 | L9 | - | - | 1 | 0 | GND |  |  |  |  |  | V16 | L9 | - | -
0 | GND |  |  |  |  |  | W16 | M9 | - | - | 1 | 0 | GND |  |  |  |  |  | W16 | M9 | - | -
0 | GND |  |  |  |  |  | Y16 | N9 | - | - | 1 | 0 | GND |  |  |  |  |  | Y16 | N9 | - | -
0 | GND |  |  |  |  |  | AB16 | P9 | - | - | 1 | 0 | GND |  |  |  |  |  | AB16 | P9 | - | -
0 | GND |  |  |  |  |  | B15 | R9 | - | - | 1 | 0 | GND |  |  |  |  |  | B15 | R9 | - | -
0 | GND |  |  |  |  |  | E15 | T9 | - | - | 1 | 0 | GND |  |  |  |  |  | E15 | T9 | - | -
0 | GND |  |  |  |  |  | L15 | U9 | - | - | 1 | 0 | GND |  |  |  |  |  | L15 | U9 | - | -
0 | GND |  |  |  |  |  | N15 | V9 | - | - | 1 | 0 | GND |  |  |  |  |  | N15 | V9 | - | -
0 | GND |  |  |  |  |  | P15 | W9 | - | - | 1 | 0 | GND |  |  |  |  |  | P15 | W9 | - | -
0 | GND |  |  |  |  |  | R15 | H8 | - | - | 1 | 0 | GND |  |  |  |  |  | R15 | H8 | - | -
0 | GND |  |  |  |  |  | T15 | J8 | - | - | 1 | 0 | GND |  |  |  |  |  | T15 | J8 | - | -
0 | GND |  |  |  |  |  | U15 | B5 | - | - | 1 | 0 | GND |  |  |  |  |  | U15 | B5 | - | -
0 | GND |  |  |  |  |  | V15 | E5 | - | - | 1 | 0 | GND |  |  |  |  |  | V15 | E5 | - | -
0 | GND |  |  |  |  |  | W15 | J5 | - | - | 1 | 0 | GND |  |  |  |  |  | W15 | J5 | - | -
0 | GND |  |  |  |  |  | Y15 | M5 | - | - | 1 | 0 | GND |  |  |  |  |  | Y15 | M5 | - | -
0 | GND |  |  |  |  |  | AB15 | R5 | - | - | 1 | 0 | GND |  |  |  |  |  | AB15 | R5 | - | -
0 | GND |  |  |  |  |  | L14 | V5 | - | - | 1 | 0 | GND |  |  |  |  |  | L14 | V5 | - | -
0 | GND |  |  |  |  |  | N14 | AC3 | - | - | 1 | 0 | GND |  |  |  |  |  | N14 | AC3 | - | -
0 | GND |  |  |  |  |  | P14 | B2 | - | - | 1 | 0 | GND |  |  |  |  |  | P14 | B2 | - | -
0 | GND |  |  |  |  |  | R14 | E2 | - | - | 1 | 0 | GND |  |  |  |  |  | R14 | E2 | - | -
0 | GND |  |  |  |  |  | T14 | J2 | - | - | 1 | 0 | GND |  |  |  |  |  | T14 | J2 | - | -
0 | GND |  |  |  |  |  | U14 | M2 | - | - | 1 | 0 | GND |  |  |  |  |  | U14 | M2 | - | -
0 | GND |  |  |  |  |  | V14 | R2 | - | - | 1 | 0 | GND |  |  |  |  |  | V14 | R2 | - | -
0 | GND |  |  |  |  |  | W14 | V2 | - | - | 1 | 0 | GND |  |  |  |  |  | W14 | V2 | - | -
0 | GND |  |  |  |  |  | Y14 | - | - | - | 1 | 0 | GND |  |  |  |  |  | Y14 | - | - | -
0 | GND |  |  |  |  |  | AB14 | - | - | - | 1 | 0 | GND |  |  |  |  |  | AB14 | - | - | -
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
0 | VCCIO1 |  | 1 |  |  |  | - | - | - | - | 1 | 0 | VCCIO1 |  | 1 |  |  |  | - | - | - | -
0 | VCCIO1 |  | 1 |  |  |  | - | - | - | - | 1 | 0 | VCCIO1 |  | 1 |  |  |  | - | - | - | -
0 | VCCIO2 |  | 2 |  |  |  | M23 | J19 | H15 | G5 | 1 | 0 | VCCIO2 |  | 2 |  |  |  | M23 | J19 | H15 | G5
0 | VCCIO2 |  | 2 |  |  |  | P23 | L19 | J15 | H5 | 1 | 0 | VCCIO2 |  | 2 |  |  |  | P23 | L19 | J15 | H5
0 | VCCIO2 |  | 2 |  |  |  | R23 | M19 | H14 | - | 1 | 0 | VCCIO2 |  | 2 |  |  |  | R23 | M19 | H14 | -
0 | VCCIO2 |  | 2 |  |  |  | T23 | N19 | - | - | 1 | 0 | VCCIO2 |  | 2 |  |  |  | T23 | N19 | - | -
0 | VCCIO2 |  | 2 |  |  |  | - | - | - | - | 1 | 0 | VCCIO2 |  | 2 |  |  |  | - | - | - | -
0 | VCCIO2 |  | 2 |  |  |  | - | - | - | - | 1 | 0 | VCCIO2 |  | 2 |  |  |  | - | - | - | -
0 | VCCIO2 |  | 2 |  |  |  | - | - | - | - | 1 | 0 | VCCIO2 |  | 2 |  |  |  | - | - | - | -
0 | VCCIO2 |  | 2 |  |  |  | - | - | - | - | 1 | 0 | VCCIO2 |  | 2 |  |  |  | - | - | - | -
0 | VCCIO3 |  | 3 |  |  |  | U23 | P19 | L15 | M5 | 1 | 0 | VCCIO3 |  | 3 |  |  |  | U23 | P19 | L15 | M5
0 | VCCIO3 |  | 3 |  |  |  | V23 | R19 | M15 | N5 | 1 | 0 | VCCIO3 |  | 3 |  |  |  | V23 | R19 | M15 | N5
0 | VCCIO3 |  | 3 |  |  |  | W23 | U19 | L14 | - | 1 | 0 | VCCIO3 |  | 3 |  |  |  | W23 | U19 | L14 | -
0 | VCCIO3 |  | 3 |  |  |  | AA23 | - | - | - | 1 | 0 | VCCIO3 |  | 3 |  |  |  | AA23 | - | - | -
0 | VCCIO3 |  | 3 |  |  |  | - | - | - | - | 1 | 0 | VCCIO3 |  | 3 |  |  |  | - | - | - | -
0 | VCCIO3 |  | 3 |  |  |  | - | - | - | - | 1 | 0 | VCCIO3 |  | 3 |  |  |  | - | - | - | -
0 | VCCIO3 |  | 3 |  |  |  | - | - | - | - | 1 | 0 | VCCIO3 |  | 3 |  |  |  | - | - | - | -
0 | VCCIO3 |  | 3 |  |  |  | - | - | - | - | 1 | 0 | VCCIO3 |  | 3 |  |  |  | - | - | - | -
0 | VCCIO4 |  | 4 |  |  |  | AB23 | V19 | - | - | 1 | 0 | VCCIO4 |  | 4 |  |  |  | AB23 | V19 | - | -
0 | VCCIO4 |  | 4 |  |  |  | AC23 | V18 | - | - | 1 | 0 | VCCIO4 |  | 4 |  |  |  | AC23 | V18 | - | -
0 | VCCIO4 |  | 4 |  |  |  | - | - | - | - | 1 | 0 | VCCIO4 |  | 4 |  |  |  | - | - | - | -
0 | VCCIO4 |  | 4 |  |  |  | - | - | - | - | 1 | 0 | VCCIO4 |  | 4 |  |  |  | - | - | - | -
0 | VCCIO4 |  | 4 |  |  |  | - | - | - | - | 1 | 0 | VCCIO4 |  | 4 |  |  |  | - | - | - | -
0 | GNDA |  |  |  |  |  | AH26 | AC24 | V20 | R1 | 0 | 0 | GND |  |  |  |  |  | AH26 | AC24 | V20 | R1
0 | GNDA |  |  |  |  |  | AJ26 | AD24 | V19 | R2 | 0 | 0 | GND |  |  |  |  |  | AJ26 | AD24 | V19 | R2
0 | GNDA |  |  |  |  |  | AK26 | AE24 | W19 | T2 | 0 | 0 | GND |  |  |  |  |  | AK26 | AE24 | W19 | T2
0 | GNDA |  |  |  |  |  | AL26 | AF24 | V16 | U2 | 0 | 0 | GND |  |  |  |  |  | AL26 | AF24 | V16 | U2
0 | GNDA |  |  |  |  |  | AM26 | AB23 | W16 | T3 | 0 | 0 | GND |  |  |  |  |  | AM26 | AB23 | W16 | T3
0 | GNDA |  |  |  |  |  | AH25 | AB22 | V15 | U3 | 0 | 0 | GND |  |  |  |  |  | AH25 | AB22 | V15 | U3
0 | GNDA |  |  |  |  |  | AH24 | AE22 | W15 | T4 | 0 | 0 | GND |  |  |  |  |  | AH24 | AE22 | W15 | T4
0 | GNDA |  |  |  |  |  | AL24 | AB21 | U14 | U4 | 0 | 0 | GND |  |  |  |  |  | AL24 | AB21 | U14 | U4
0 | GNDA |  |  |  |  |  | AF23 | AC21 | V14 | V4 | 0 | 0 | GND |  |  |  |  |  | AF23 | AC21 | V14 | V4
0 | GNDA |  |  |  |  |  | AG23 | AD21 | U13 | U5 | 0 | 0 | GND |  |  |  |  |  | AG23 | AD21 | U13 | U5
0 | GNDA |  |  |  |  |  | AH23 | AE21 | V13 | P6 | 0 | 0 | GND |  |  |  |  |  | AH23 | AE21 | V13 | P6
0 | GNDA |  |  |  |  |  | AJ23 | AA20 | U12 | T6 | 0 | 0 | GND |  |  |  |  |  | AJ23 | AA20 | U12 | T6
0 | GNDA |  |  |  |  |  | AK23 | AE19 | V12 | T7 | 0 | 0 | GND |  |  |  |  |  | AK23 | AE19 | V12 | T7
0 | GNDA |  |  |  |  |  | AL23 | AA18 | W12 | U7 | 0 | 0 | GND |  |  |  |  |  | AL23 | AA18 | W12 | U7
0 | GNDA |  |  |  |  |  | AL21 | AB18 | U11 | V7 | 0 | 0 | GND |  |  |  |  |  | AL21 | AB18 | U11 | V7
0 | GNDA |  |  |  |  |  | AF20 | AC18 | U10 | P8 | 0 | 0 | GND |  |  |  |  |  | AF20 | AC18 | U10 | P8
0 | GNDA |  |  |  |  |  | AG20 | AD18 | U9 | T8 | 0 | 0 | GND |  |  |  |  |  | AG20 | AD18 | U9 | T8
0 | GNDA |  |  |  |  |  | AH20 | AE18 | V9 | T9 | 0 | 0 | GND |  |  |  |  |  | AH20 | AE18 | V9 | T9
0 | GNDA |  |  |  |  |  | AJ20 | AA17 | U8 | U9 | 0 | 0 | GND |  |  |  |  |  | AJ20 | AA17 | U8 | U9
0 | GNDA |  |  |  |  |  | AK20 | AE16 | V8 | T10 | 0 | 0 | GND |  |  |  |  |  | AK20 | AE16 | V8 | T10
0 | GNDA |  |  |  |  |  | AL20 | AA15 | U7 | U10 | 0 | 0 | GND |  |  |  |  |  | AL20 | AA15 | U7 | U10
0 | GNDA |  |  |  |  |  | AF19 | AB15 | V7 | V10 | 0 | 0 | GND |  |  |  |  |  | AF19 | AB15 | V7 | V10
0 | GNDA |  |  |  |  |  | AL18 | AC15 | W7 | T11 | 0 | 0 | GND |  |  |  |  |  | AL18 | AC15 | W7 | T11
0 | GNDA |  |  |  |  |  | AF17 | AD15 | V6 | U11 | 0 | 0 | GND |  |  |  |  |  | AF17 | AD15 | V6 | U11
0 | GNDA |  |  |  |  |  | AG17 | AE15 | W6 | P12 | 0 | 0 | GND |  |  |  |  |  | AG17 | AE15 | W6 | P12
0 | GNDA |  |  |  |  |  | AH17 | AA14 | V5 | T12 | 0 | 0 | GND |  |  |  |  |  | AH17 | AA14 | V5 | T12
0 | GNDA |  |  |  |  |  | AJ17 | AB14 | - | - | 0 | 0 | GND |  |  |  |  |  | AJ17 | AB14 | - | -
0 | GNDA |  |  |  |  |  | AK17 | AA13 | - | - | 0 | 0 | GND |  |  |  |  |  | AK17 | AA13 | - | -
0 | GNDA |  |  |  |  |  | AL17 | AB13 | - | - | 0 | 0 | GND |  |  |  |  |  | AL17 | AB13 | - | -
0 | GNDA |  |  |  |  |  | AF16 | AE13 | - | - | 0 | 0 | GND |  |  |  |  |  | AF16 | AE13 | - | -
0 | GNDA |  |  |  |  |  | AG16 | AA12 | - | - | 0 | 0 | GND |  |  |  |  |  | AG16 | AA12 | - | -
0 | GNDA |  |  |  |  |  | AH16 | AB12 | - | - | 0 | 0 | GND |  |  |  |  |  | AH16 | AB12 | - | -
0 | GNDA |  |  |  |  |  | AF15 | AC12 | - | - | 0 | 0 | GND |  |  |  |  |  | AF15 | AC12 | - | -
0 | GNDA |  |  |  |  |  | AG15 | AD12 | - | - | 0 | 0 | GND |  |  |  |  |  | AG15 | AD12 | - | -
0 | GNDA |  |  |  |  |  | AH15 | AE12 | - | - | 0 | 0 | GND |  |  |  |  |  | AH15 | AE12 | - | -
0 | GNDA |  |  |  |  |  | AL15 | AA10 | - | - | 0 | 0 | GND |  |  |  |  |  | AL15 | AA10 | - | -
0 | GNDA |  |  |  |  |  | AF14 | AE10 | - | - | 0 | 0 | GND |  |  |  |  |  | AF14 | AE10 | - | -
0 | GNDA |  |  |  |  |  | AG14 | AA9 | - | - | 0 | 0 | GND |  |  |  |  |  | AG14 | AA9 | - | -
0 | GNDA |  |  |  |  |  | AH14 | AB9 | - | - | 0 | 0 | GND |  |  |  |  |  | AH14 | AB9 | - | -
0 | GNDA |  |  |  |  |  | AJ14 | AC9 | - | - | 0 | 0 | GND |  |  |  |  |  | AJ14 | AC9 | - | -
0 | GNDA |  |  |  |  |  | AK14 | AD9 | - | - | 0 | 0 | GND |  |  |  |  |  | AK14 | AD9 | - | -
0 | GNDA |  |  |  |  |  | AL14 | AE9 | - | - | 0 | 0 | GND |  |  |  |  |  | AL14 | AE9 | - | -
0 | GNDA |  |  |  |  |  | AF12 | AA7 | - | - | 0 | 0 | GND |  |  |  |  |  | AF12 | AA7 | - | -
0 | GNDA |  |  |  |  |  | AL12 | AE7 | - | - | 0 | 0 | GND |  |  |  |  |  | AL12 | AE7 | - | -
0 | GNDA |  |  |  |  |  | AF11 | AB6 | - | - | 0 | 0 | GND |  |  |  |  |  | AF11 | AB6 | - | -
0 | GNDA |  |  |  |  |  | AG11 | AC6 | - | - | 0 | 0 | GND |  |  |  |  |  | AG11 | AC6 | - | -
0 | GNDA |  |  |  |  |  | AH11 | AD6 | - | - | 0 | 0 | GND |  |  |  |  |  | AH11 | AD6 | - | -
0 | GNDA |  |  |  |  |  | AJ11 | AE6 | - | - | 0 | 0 | GND |  |  |  |  |  | AJ11 | AE6 | - | -
0 | GNDA |  |  |  |  |  | AK11 | AF5 | - | - | 0 | 0 | GND |  |  |  |  |  | AK11 | AF5 | - | -
0 | GNDA |  |  |  |  |  | AL11 | - | - | - | 0 | 0 | GND |  |  |  |  |  | AL11 | - | - | -
0 | GNDA |  |  |  |  |  | AL9 | - | - | - | 0 | 0 | GND |  |  |  |  |  | AL9 | - | - | -
0 | GNDA |  |  |  |  |  | AH8 | - | - | - | 0 | 0 | GND |  |  |  |  |  | AH8 | - | - | -
0 | GNDA |  |  |  |  |  | AJ8 | - | - | - | 0 | 0 | GND |  |  |  |  |  | AJ8 | - | - | -
0 | GNDA |  |  |  |  |  | AK8 | - | - | - | 0 | 0 | GND |  |  |  |  |  | AK8 | - | - | -
0 | GNDA |  |  |  |  |  | AL8 | - | - | - | 0 | 0 | GND |  |  |  |  |  | AL8 | - | - | -
0 | GNDA |  |  |  |  |  | AH7 | - | - | - | 0 | 0 | GND |  |  |  |  |  | AH7 | - | - | -
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
0 | VCCIO8 |  | 8 |  |  |  | - | - | - | - | 1 | 0 | VCCIO8 |  | 8 |  |  |  | - | - | - | -
0 | VCCIO8 |  | 8 |  |  |  | - | - | - | - | 1 | 0 | VCCIO8 |  | 8 |  |  |  | - | - | - | -
0 | VCCIO8 |  | 8 |  |  |  | - | - | - | - | 1 | 0 | VCCIO8 |  | 8 |  |  |  | - | - | - | -
0 | VCCIO6 |  | 6 |  |  |  | U10 | P8 | L7 | M14 | 1 | 0 | VCCIO6 |  | 6 |  |  |  | U10 | P8 | L7 | M14
0 | VCCIO6 |  | 6 |  |  |  | V10 | R8 | L6 | N14 | 1 | 0 | VCCIO6 |  | 6 |  |  |  | V10 | R8 | L6 | N14
0 | VCCIO6 |  | 6 |  |  |  | W10 | U8 | M6 | - | 1 | 0 | VCCIO6 |  | 6 |  |  |  | W10 | U8 | M6 | -
0 | VCCIO6 |  | 6 |  |  |  | AA10 | V8 | - | - | 1 | 0 | VCCIO6 |  | 6 |  |  |  | AA10 | V8 | - | -
0 | VCCIO6 |  | 6 |  |  |  | - | - | - | - | 1 | 0 | VCCIO6 |  | 6 |  |  |  | - | - | - | -
0 | VCCIO6 |  | 6 |  |  |  | - | - | - | - | 1 | 0 | VCCIO6 |  | 6 |  |  |  | - | - | - | -
0 | VCCIO6 |  | 6 |  |  |  | - | - | - | - | 1 | 0 | VCCIO6 |  | 6 |  |  |  | - | - | - | -
0 | VCCIO6 |  | 6 |  |  |  | - | - | - | - | 1 | 0 | VCCIO6 |  | 6 |  |  |  | - | - | - | -
0 | VCCIO7 |  | 7 |  |  |  | M10 | K8 | H7 | G14 | 1 | 0 | VCCIO7 |  | 7 |  |  |  | M10 | K8 | H7 | G14
0 | VCCIO7 |  | 7 |  |  |  | P10 | M8 | H6 | H14 | 1 | 0 | VCCIO7 |  | 7 |  |  |  | P10 | M8 | H6 | H14
0 | VCCIO7 |  | 7 |  |  |  | R10 | N8 | J6 | - | 1 | 0 | VCCIO7 |  | 7 |  |  |  | R10 | N8 | J6 | -
0 | VCCIO7 |  | 7 |  |  |  | T10 | - | - | - | 1 | 0 | VCCIO7 |  | 7 |  |  |  | T10 | - | - | -
0 | VCCIO7 |  | 7 |  |  |  | - | - | - | - | 1 | 0 | VCCIO7 |  | 7 |  |  |  | - | - | - | -
0 | VCCIO7 |  | 7 |  |  |  | - | - | - | - | 1 | 0 | VCCIO7 |  | 7 |  |  |  | - | - | - | -
0 | VCCIO7 |  | 7 |  |  |  | - | - | - | - | 1 | 0 | VCCIO7 |  | 7 |  |  |  | - | - | - | -
0 | VCCIO7 |  | 7 |  |  |  | - | - | - | - | 1 | 0 | VCCIO7 |  | 7 |  |  |  | - | - | - | -
0 | NC | Unused |  |  |  |  | AG31 | F18 | - | - | 1 | 0 | NC | Unused |  |  |  |  | AG31 | F18 | - | -
0 | NC | Unused |  |  |  |  | V30 | F17 | - | - | 1 | 0 | NC | Unused |  |  |  |  | V30 | F17 | - | -
0 | NC | Unused |  |  |  |  | H29 | C15 | - | - | 1 | 0 | NC | Unused |  |  |  |  | H29 | C15 | - | -
0 | NC | Unused |  |  |  |  | AC29 | D15 | - | - | 1 | 0 | NC | Unused |  |  |  |  | AC29 | D15 | - | -
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
