siglabsoss/copper-suicide/docs/cs_and_graviton_parts.xlsx

Mfg. P/N | Mfg. Description | Internal Description | qty | price | extended | need | extra
SEAF-40-06.5-S-10-2-A-K-TR | High-Speed/High-Density Open-Pin-Field Connector | Graviton Bottom Connector | 140 | 14.28 | $1999.20 | 120 | 20
SEAM-40-11.0-S-10-2-A-K-TR | High-Speed/High-Density Open-Pin-Field Connector | Graviton Top Connector | 75 | 21.36 | $1602.00 | 60 | 15
LFE5U-85F-8BG756C | ECP5, 83.6k LUTs, 1.1V FPGA | Graviton FPGA | 243 | 68.45 | $16633.35
MT41K256M16HA -125:E | DRAM Chip DDR3L SDRAM 4Gbit 256Mx16 1.35V 96-Pin FBGA | Graviton SDRAM | 200 | 6.8 | $1360.00
 | substitute MT41K256M16TW-107:P
88E1512A0NNP2C000 | Ethernet Phy | Graviton Eth PHY | 100
 |  |  |  | total | $21594.55
