siglabsoss/copper-suicide/docs/160906-1_proposed_fmc_to_fpga_wiring.pdf

MCU

FMC

A25:A0 | single ended, 108MHz, LVCMOS33, series terminated
D7:D0 | double ended, 108MHz, LVCMOS33, series terminated
NWE | single ended, 108MHz, LVCMOS33, series terminated
NOE | single ended, 108MHz, LVCMOS33, series terminated
NE1 | single ended, 108MHz, LVCMOS33, series terminated
Clk | single ended, 108MHz, LVCMOS33, series terminated

A25:A0 (from FPGA)

D7:D0 (from FPGA)

Instantiated module on FPGA

SRAM

A [25:0]

D [7:0]

Write_en

Clk_en

Clk

Q [7:0]

Software

Select line for ‘Data in’ | single ended, 108MHz, LVCMOS33, series terminated
Select line for ‘Address In’ | single ended, 108MHz, LVCMOS33, series terminated

MCU Pin Mapping Constraints:

- To operate on 108 MHz,
2.7 V ≤ VDD ≤ 3.6 V

FPGA Pin Mapping Constraints:

None

## MCU Pinout for FMC

Pin Name | SRAM
PG14 | A 2 5
PG13 | A24
PE2 | A23
PE6 | A22
PE5 | A21
PE4 | A20
PE3 | A19
PD13 | A18
PD12 | A17
PD11 | A16
PG5 | A15
PG4 | A14
PG3 | A13
PG2 | A12
PG1 | A11
PG0 | A10
PF15 | A9
PF14 | A8
PF13 | A7
PF12 | A6
PF5 | A5
PF4 | A4
PF3 | A3
PF2 | A2
PF1 | A1
PF0 | A0

PE10 | D7
PE9 | D6
PE8 | D5
PE7 | D4
PD1 | D3
PD0 | D2
PD15 | D1
PD14 | D0
PD7 | NE1 (Bank Select for SRAM)
PD3 | Clk
PD4 | NOE (Output Enable)
PD5 | NWE (Write Enable)
