siglabsoss/copper-suicide/docs/top_level_block_diagram.pdf

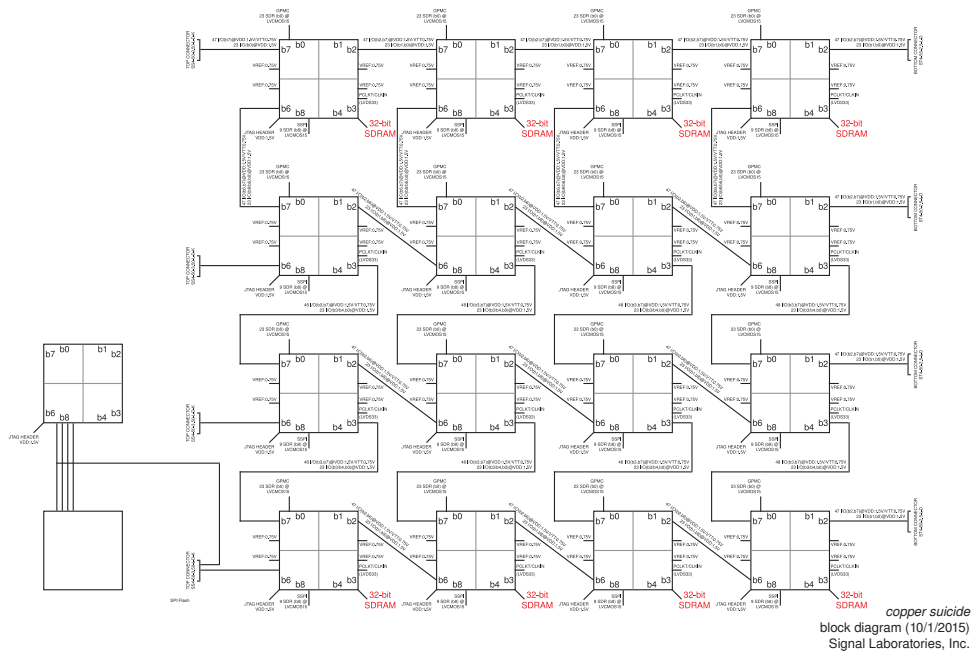
[picture p11: page 1]
copper suicide; SPI Flash

block diagram (10/1/2015)
Signal Laboratories, Inc.
