siglabsoss/copper-suicide/docs/160916-1_configuration_setup.pdf

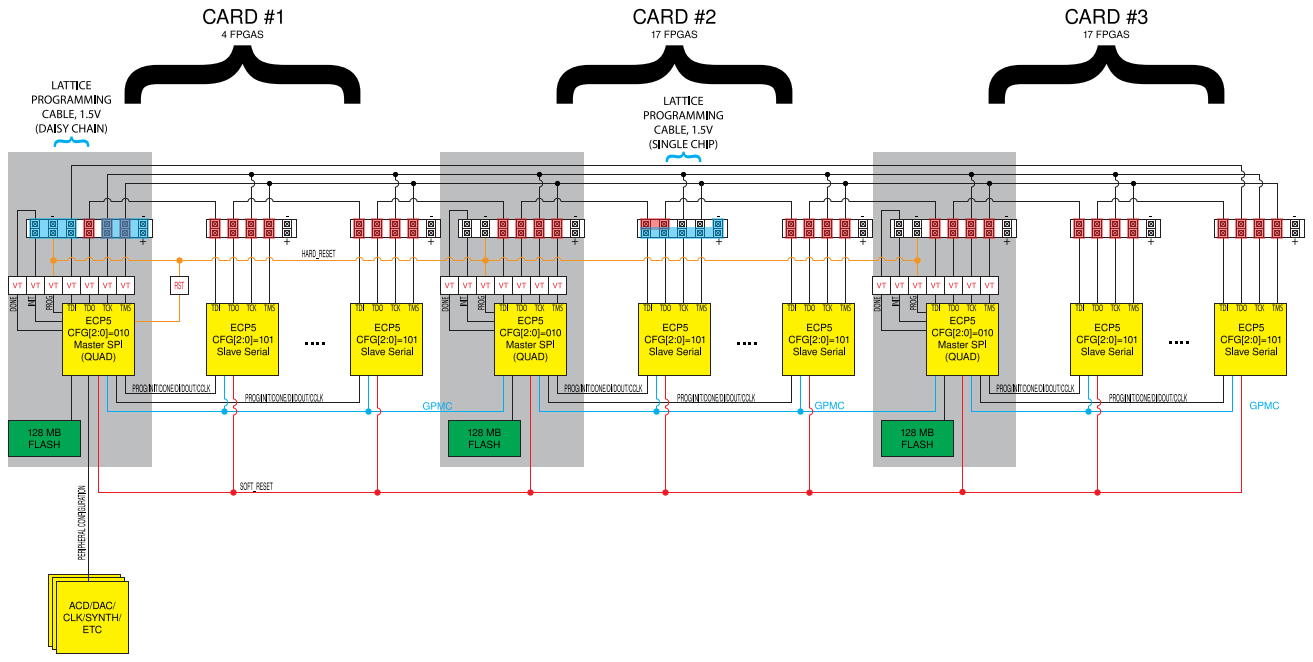
[picture p12: page 1]
