siglabsoss/copper-suicide/docs/array.pdf

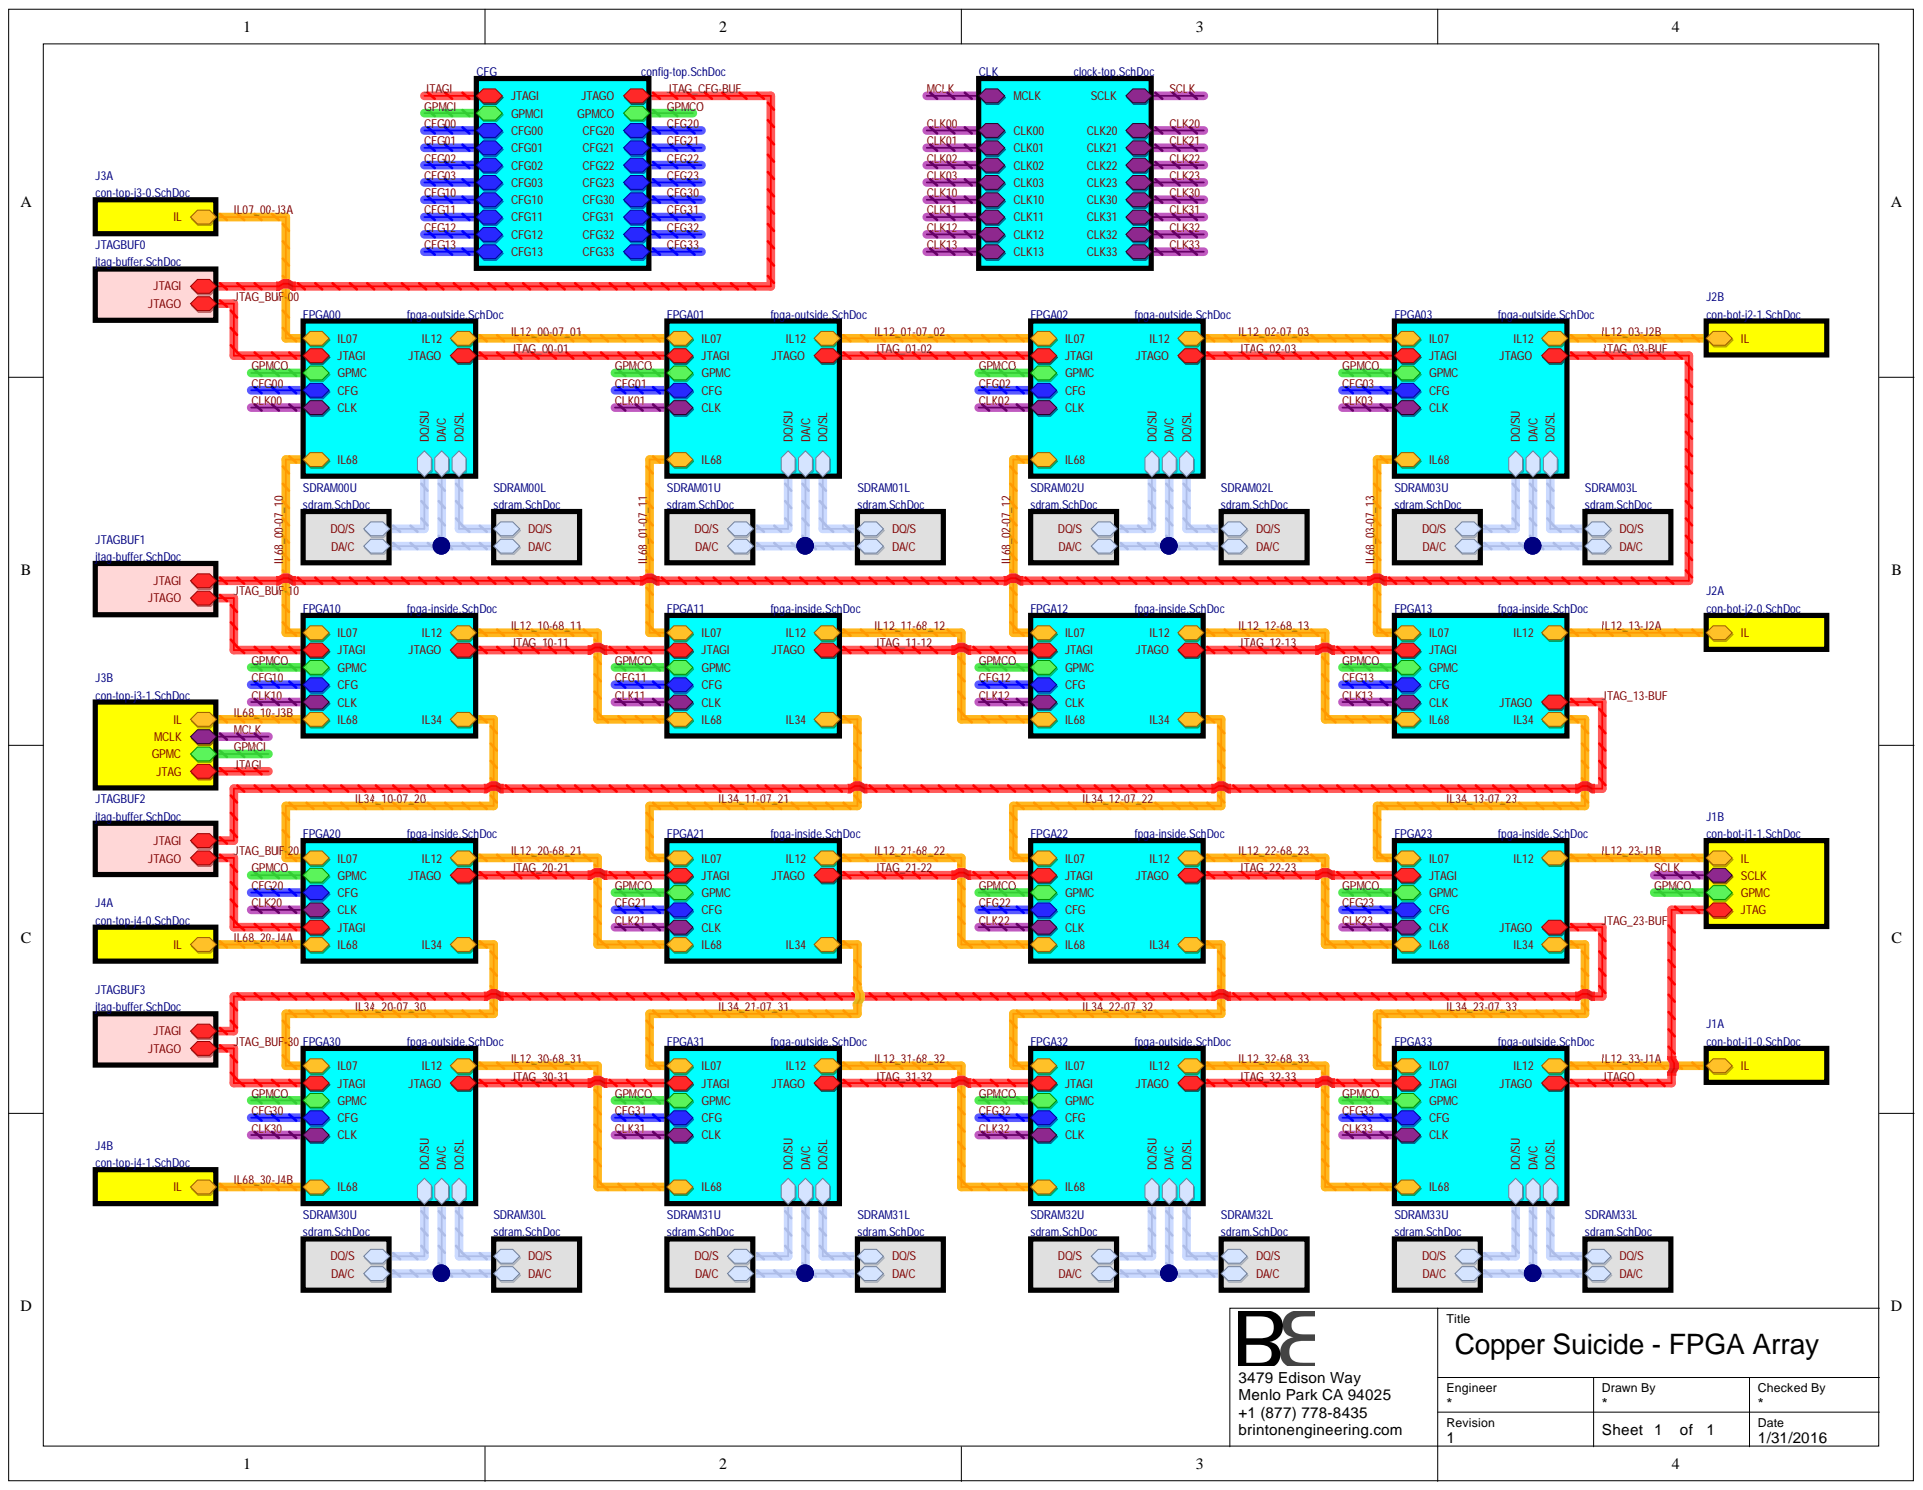
[picture p13: page 1]

3479 Edison Way Menlo Park CA 94025 +1 (877) 778-8435 brintonengineering.com | Title Copper Suicide - FPGA Array

Engineer * | Drawn By * | Checked By *

1 | of 1 Revision | Date 1/31/2016 Sheet 1
