siglabsoss/copper-suicide/(list of files, drawings)

Other design files:
dark_knight.PrjPCB
hardware/array.SchDoc
hardware/clock.SchDoc
hardware/con-left-bot.SchDoc
hardware/con-left-top.SchDoc
hardware/con-right-bot.SchDoc
hardware/con-right-top.SchDoc
hardware/config.SchDoc
hardware/copper_suicide.PcbDoc
hardware/copper_suicide.PcbLib
hardware/copper_suicide.PrjPCB
hardware/copper_suicide.SchLib
hardware/fans.SchDoc
hardware/flash.SchDoc
hardware/fpga-bank0.SchDoc
hardware/fpga-bank1.SchDoc
hardware/fpga-bank2.SchDoc
hardware/fpga-bank3.SchDoc
hardware/fpga-bank4.SchDoc
hardware/fpga-bank6.SchDoc
hardware/fpga-bank7.SchDoc
hardware/fpga-bank8.SchDoc
hardware/fpga-ground.SchDoc
hardware/fpga-misc.SchDoc
hardware/fpga-power.SchDoc
hardware/fpga-serdes.SchDoc
hardware/fpga.SchDoc
hardware/jtag-switch.SchDoc
hardware/main.SchDoc
hardware/mcu-io.SchDoc
hardware/mcu.SchDoc
hardware/mechanical.SchDoc
hardware/power-v1v35.SchDoc
hardware/power-v2v5.SchDoc
hardware/power-v3v3.SchDoc
hardware/power-v5.SchDoc
hardware/power-v12.SchDoc
hardware/power-vtt.SchDoc
hardware/reset.SchDoc
hardware/sdram.SchDoc
hardware/tie-flash-cfg.SchDoc
hardware/tie-il07-il07.SchDoc
hardware/tie-il12-il07.SchDoc
hardware/tie-il12-il68.SchDoc
hardware/tie-il34-il07.SchDoc
hardware/tie-il34-sdram.SchDoc
hardware/tie-il68-il07.SchDoc
hardware/tie-il-cfg.SchDoc
hardware/tie-mib-imib.SchDoc
hardware/tie-mib-term0.SchDoc
hardware/tie-mib-term1.SchDoc
hardware/top.SchDoc
hardware/vio-sw.SchDoc
