siglabsoss/copper-suicide/(commit log)

2015-10-01 * adding schematic
    [array.SchDoc, clock-top.SchDoc, connector-left0.SchDoc, connector-left1.SchDoc, connector-left2.SchDoc, connector-left3.SchDoc, connector-right0.SchDoc, connector-right1.SchDoc]
2015-10-03 * adding configuration FPGA and block diagram to indicate connections
    [config-bank0.SchDoc, config-bank1.SchDoc, config-bank2.SchDoc, config-bank3.SchDoc, config-bank4.SchDoc, config-bank6.SchDoc, config-bank7.SchDoc, config-bank8.SchDoc]
2015-10-06 added 1.1V point of load regulator to FPGA. finished config fpga configuration.
    [config-bank0.SchDoc, config-bank1.SchDoc, config-bank2.SchDoc, config-bank3.SchDoc, config-bank4.SchDoc, config-bank6.SchDoc, config-bank7.SchDoc, config-bank8.SchDoc]
2015-10-06 finished config fpga in its entirety.
    [array.SchDoc, config-bank0.SchDoc, config-bank1.SchDoc, config-bank2.SchDoc, config-bank3.SchDoc, config-bank4.SchDoc, config-bank6.SchDoc, config-bank7.SchDoc]
2015-10-13 adding config fpga details
    [config-bank0.SchDoc, config-bank1.SchDoc, config-bank2.SchDoc, config-bank3.SchDoc, config-bank4.SchDoc, config-bank6.SchDoc, config-bank7.SchDoc, config-bank8.SchDoc]
2015-10-17 renaming project
    [copper_suicide.PrjPCB]
2015-10-17 checking in connector sheets
    [connector-bottom-j1-0.SchDoc, connector-bottom-j1-1.SchDoc, connector-bottom-j2-0.SchDoc, connector-bottom-j2-1.SchDoc, connector-top-j3-0.SchDoc, connector-top-j3-1.SchDoc, connector-top-j4-0.SchDoc, connector-top-j4-1.SchDoc]
2015-12-01 * latest schematic work
    [array.SchDoc, connector-bottom-j1-1.SchDoc, connector-bottom-j2-1.SchDoc, connector-left0.SchDoc, connector-left1.SchDoc, connector-left2.SchDoc, connector-left3.SchDoc, connector-right0.SchDoc]
2016-01-29 * progress on everything
    [array.SchDoc, config-bank2.SchDoc, config-bank8.SchDoc, config-top.SchDoc, copper_suicide.PrjPCB, fpga-bank0.SchDoc, fpga-bank7.SchDoc, fpga-bank8.SchDoc]
2016-01-30 * about to annotate
    [array.SchDoc, clock-top.SchDoc, con-bot-j1-0.SchDoc, con-bot-j1-1.SchDoc, con-bot-j2-0.SchDoc, con-bot-j2-1.SchDoc, con-top-j3-0.SchDoc, con-top-j3-1.SchDoc]
2016-01-30 * most busses in place * fpga config complete
    [array.SchDoc, config-bank2.SchDoc, config-bank7.SchDoc, config-bank8.SchDoc, config-power.SchDoc, config-top.SchDoc, connector-bottom-j1-0.SchDoc, connector-bottom-j1-1.SchDoc]
2016-01-31 * fixed most schematic errors * still issue with hierarchical design * full design does now sync with PcbDoc, but there's still some physical schematic component issues stemming from the reuse of som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
    [array.SchDoc, con-bot-j1-0.SchDoc, con-bot-j1-1.SchDoc, con-bot-j2-0.SchDoc, con-bot-j2-1.SchDoc, con-top-j3-0.SchDoc, con-top-j3-1.SchDoc, con-top-j4-0.SchDoc]
2016-02-05 fixed all compile errors added jtag buffer
    remaining:
    * add pin swapping
    * power supplies
    * clock distribution
    * reset distribution
    * ingress power connector
    * edge mount JTAG access
    [array.SchDoc, clock-top.SchDoc, con-bot-j1-0.SchDoc, con-bot-j1-1.SchDoc, con-bot-j2-0.SchDoc, con-bot-j2-1.SchDoc, con-top-j3-0.SchDoc, con-top-j3-1.SchDoc]
2016-02-17 * made all fpga blocks the same
    [array.SchDoc, clock-top.SchDoc, clock.SchDoc, con-bot-j1-0.SchDoc, con-bot-j1-1.SchDoc, con-bot-j2-0.SchDoc, con-bot-j2-1.SchDoc, con-top-j3-0.SchDoc]
2016-05-24 * pushing latest on joels pc
    [array.SchDoc, copper_suicide.PrjPCB]
2016-05-28 Pinout changes for IL clocks, rearrangement in progress for of fpga schematic and array for more routing reusability
    [fpga-bank0.SchDoc, fpga-bank2.SchDoc, fpga-bank3.SchDoc, fpga-bank6.SchDoc, fpga-bank7.SchDoc, top.SchDoc]
2016-06-02 Checked pinouts, WIP moving FPGA to single schematic
    [array.SchDoc, con-top-j3-0.SchDoc, con-top-j3-1.SchDoc, con-top-j4-0.SchDoc, con-top-j4-1.SchDoc, top.SchDoc]
2016-06-04 Moved FPGA around into single two schematics, added termination resistors, preparing to replace sheets symbols in array
    [copper_suicide.PrjPCB, fpga-bank0.SchDoc, fpga-ground.SchDoc, fpga-misc.SchDoc, fpga-power.SchDoc, fpga-serdes-power.SchDoc, fpga-serdes.SchDoc]
2016-06-07 Separate FPGA sheets for edge and center, replaced sheet symbols in array, DDR3 power supply WIP
    [array.SchDoc, copper_suicide.PrjPCB, fpga-power.SchDoc, fpga00-serdes-power.SchDoc, power-v0v75.SchDoc, sdram.SchDoc, top.SchDoc]
2016-06-08 Added clock driver
    [clock.SchDoc, copper_suicide.PrjPCB, power-v1v5.SchDoc, top.SchDoc]
2016-06-15 Added LEDs, updated clock driver, repinned out clock on center and edge FPGAs, added local FPGA clock
    [array.SchDoc, clock.SchDoc, con-bot-j1-0.SchDoc, con-bot-j1-1.SchDoc, con-bot-j2-0.SchDoc, con-bot-j2-1.SchDoc, con-top-j3-0.SchDoc, con-top-j3-1.SchDoc]
2016-06-16 Project compiling, but net naming errors
    [array.SchDoc, clock.SchDoc, con-bot-j1-0.SchDoc, con-bot-j1-1.SchDoc, con-bot-j2-0.SchDoc, con-bot-j2-1.SchDoc, con-top-j3-0.SchDoc, con-top-j3-1.SchDoc]
2016-06-17 Just about fixed all compile errors, net identifier scope issues remaining. Got most parts on board
    [array.SchDoc, clock.SchDoc, con-bot-j1-0.SchDoc, con-bot-j1-1.SchDoc, con-bot-j2-0.SchDoc, con-bot-j2-1.SchDoc, con-top-j3-0.SchDoc, con-top-j3-1.SchDoc]
2016-06-20 Added missing files for power supply and LEDs
    [LED8.SchDoc, power-v3v3.SchDoc]
2016-06-23 Changed power supplies around, split out SDRAM core power, added reset switch, added clock buffer and local clock sources to config fpga
    [array.SchDoc, clock.SchDoc, config-bank0.SchDoc, config-bank3.SchDoc, config-bank6.SchDoc, config.SchDoc, copper_suicide.PrjPCB, power-v1v5.SchDoc]
2016-06-24 Added local connector for entire JTAG chain, added power supply jumpers and barrel connector for local power
    [array.SchDoc, clock.SchDoc, con-board-jtag.SchDoc, con-bot-j1-1.SchDoc, con-top-j4-1.SchDoc, main.SchDoc, power-v1v5.SchDoc, power-v2v5.SchDoc]
2016-06-24 Added 1.5V high current supply
    [copper_suicide.PrjPCB, power-v1v5.SchDoc]
2016-06-25 Updated 5V power rail to 12V
    [LED8.SchDoc, array.SchDoc, con-board-jtag.SchDoc, config-bank2.SchDoc, config-bank3.SchDoc, config-bank4.SchDoc, config-bank6.SchDoc, config-bank7.SchDoc]
2016-06-27 Added missing schematic files
    [power-v12.SchDoc, power-vddr.SchDoc]
2016-06-28 Separate sheet for each FPGA instance
    [LED8.SchDoc, array.SchDoc, clock.SchDoc, con-board-jtag.SchDoc, con-bot-j1-0.SchDoc, con-bot-j1-1.SchDoc, con-bot-j2-0.SchDoc, con-bot-j2-1.SchDoc]
2016-06-28 Manually annotated FPGAs
    [fpga00-serdes-power.SchDoc, fpga01-serdes-power.SchDoc, fpga02-serdes-power.SchDoc, fpga03-serdes-power.SchDoc, fpga10-serdes-power.SchDoc, fpga11-serdes-power.SchDoc, fpga12-serdes-power.SchDoc, fpga13-serdes-power.SchDoc]
2016-06-28 Fixed compile errors
    [LED8.SchDoc, array.SchDoc, clock.SchDoc, con-board-jtag.SchDoc, con-bot-j1-0.SchDoc, con-bot-j1-1.SchDoc, con-bot-j2-0.SchDoc, con-bot-j2-1.SchDoc]
2016-06-29 Fixed warnings other than duplicate net names
    [LED8.SchDoc, array.SchDoc, clock.SchDoc, con-board-jtag.SchDoc, con-bot-j1-0.SchDoc, con-bot-j1-1.SchDoc, con-bot-j2-0.SchDoc, con-bot-j2-1.SchDoc]
2016-06-29 Sync'd schematic to PCB
2016-07-10 * using net ties
    [LED8.SchDoc, array.SchDoc, clock.SchDoc, con-board-jtag.SchDoc, con-bot-j1-0.SchDoc, con-bot-j1-1.SchDoc, con-bot-j2-0.SchDoc, con-bot-j2-1.SchDoc]
2016-07-12 * schematic edits
    [fpga-bank8.SchDoc]
2016-07-12 * more schematic cleanup
    [array.SchDoc, clock.SchDoc, con-bot-j1-0.SchDoc, con-bot-j1-1.SchDoc, con-bot-j2-0.SchDoc, con-bot-j2-1.SchDoc, con-top-j3-0.SchDoc, con-top-j3-1.SchDoc]
2016-07-12 * nightly commit * all footprints added * design sync's without error * 3d models have been removed to improve performance
    [clock.SchDoc, con-bot-j2-1.SchDoc, copper_suicide.PrjPCB, flash.SchDoc, fpga.SchDoc, jtag-buffer.SchDoc, led.SchDoc, main.SchDoc]
2016-07-13 * removing net ties from SDRAM harness. Swap nets first at FPGA. Reduces routing complexity.
    [tie-il34-sdram.SchDoc]
2016-07-13 * unswizzled top board-to-board connectors
    [main.SchDoc]
2016-07-14 * Ariel nightly commit on PCB component placement
2016-07-14 * nightly commit
    [fpga.SchDoc]
2016-07-14 Nightly commit - Broke out all the FPGA pins and began attempting to place and route the 1.1V SMPS inside the FPGA's bounds
2016-07-15 * adding component values next to parts for easier readability
    [fpga.SchDoc]
2016-07-15 * fixing footprints for capacitors and resistors. Some were missing entirely. Some were wrong. Changed everything to metric.
    [clock.SchDoc, flash.SchDoc, fpga.SchDoc, led.SchDoc, power-v0v75.SchDoc, power-v12.SchDoc, power-v2v5.SchDoc, power-v3v3.SchDoc]
2016-07-15 * fixing a few more symbol footprints
    [power-v12.SchDoc, power-vddr.SchDoc]
2016-07-15 * much component placement * fixing component footprints in schematics
    [clock.SchDoc, copper_suicide.PcbLib, flash.SchDoc, fpga.SchDoc, jtag-buffer.SchDoc, led.SchDoc, main.SchDoc, power-v0v75.SchDoc]
2016-07-15 Nightly commit - finished placing and routing 1.1V SMPS components. Still need to add polygon pours to them
2016-07-16 * more routing, joel nightly commit
    [clock.SchDoc, flash.SchDoc, fpga.SchDoc, led.SchDoc, power-v0v75.SchDoc, power-v2v5.SchDoc, power-v3v3.SchDoc, power-vddr.SchDoc]
2016-07-19 Daily commit - routed the FPGA's level shifter and most of its decoupling caps. Also neatened up the 1.1V SMPS using polygon pours
2016-07-20 Nightly commit - finished all the FPGA's decoupling caps and started routing the connections between FPGAs
    [fpga-bank4.SchDoc, tie-il34-il07.SchDoc]
2016-07-21 Nightly commit - routed 0.75V and 3.3V supplies
2016-07-21 Nightly commit - finished routing VDDR power supply
    [power-v0v75.SchDoc]
2016-08-01 * fixed sdram termination
    [con-top-j4-1.SchDoc, fpga-bank3.SchDoc, sdram.SchDoc, tie-il34-sdram.SchDoc]
2016-08-03 * finished board stackup (14 layer) * DDR SDRAM schematic work
    [sdram.SchDoc, tie-il34-sdram.SchDoc]
2016-08-04 * nightly update... still working on stackup... waiting on one more round of emails with vendor to finalize.
    [con-bot-j1-1.SchDoc, fpga-bank2.SchDoc, fpga-bank3.SchDoc, fpga-bank6.SchDoc, fpga-bank7.SchDoc, fpga-bank8.SchDoc, tie-il-cfg.SchDoc, tie-il34-sdram.SchDoc]
2016-08-10 * nightly commit (8/8)
    [sdram.SchDoc]
2016-08-12 * more DDR SDRAM work, trying to get design to Place and Route in Lattice Diamond to validate a pinout * met with TTM Technologies, switching material to MEGTRON6 * removed ESD diode because level tr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
    [fpga-bank3.SchDoc]
2016-08-13 * nightly commit * looks like there's only 15 address bits used on the Micron 4Gbit SDRAM. Need to determine what to do with unused pin. Need to refactor harness, and label DQS pins. * in other news,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
    [fpga.SchDoc, sdram.SchDoc, tie-il34-sdram.SchDoc]
2016-08-14 * half-daily commit (going to work at home)
    [fpga-bank3.SchDoc]
2016-08-15 * nightly commit... g'nite!
    [array.SchDoc, con-left.SchDoc, con-right.SchDoc, copper_suicide.PrjPCB, ecp5u85pinouts.xlsx, fpga-bank0.SchDoc, fpga-bank1.SchDoc, fpga-bank2.SchDoc]
2016-09-01 * fixed board-to-board connectors (SEAM on top, SEAF on bottom) * fixed SDRAM footprint (old chip out of stock, new chip same but smaller chip outline) * rounded SDRAM room
    [clock.SchDoc, con-left-bot.SchDoc, con-left-top.SchDoc, con-left.SchDoc, con-right-bot.SchDoc, con-right-top.SchDoc, con-right.SchDoc, copper_suicide.PcbLib]
2016-09-01 * received new stack-up from TTM Technologies * validated stack-up with Polar PCB Transmission Line Field Solver
2016-09-02 * added MCU * added VCCIO on signal harnesses * did some SDRAM routing * work-in-progress
    [array.SchDoc, copper_suicide.PrjPCB, fpga-bank0.SchDoc, fpga-bank1.SchDoc, fpga-bank2.SchDoc, fpga-bank3.SchDoc, fpga-bank4.SchDoc, fpga-bank6.SchDoc]
2016-09-02 * renamed buses to allow for external powering of VCCIO
    [array.SchDoc, con-right-bot.SchDoc, con-right-top.SchDoc, copper_suicide.PrjPCB, fpga-bank0.SchDoc, fpga-bank1.SchDoc, fpga-bank2.SchDoc, fpga-bank3.SchDoc]
2016-09-04 * updating gitignore for latex document * adding vio-buffer sheet for i/o linear regulator * cleaned up harnessing
    [array.SchDoc, con-left-bot.SchDoc, con-left-top.SchDoc, con-right-bot.SchDoc, con-right-top.SchDoc, config.SchDoc, copper_suicide.PrjPCB, fpga.SchDoc]
2016-09-05 * renamed nets and added net classes for impedance control
    [con-left-bot.SchDoc, con-left-top.SchDoc, con-right-bot.SchDoc, con-right-top.SchDoc, fpga-bank0.SchDoc, fpga-bank1.SchDoc, fpga-bank2.SchDoc, fpga-bank3.SchDoc]
2016-09-06 * added PCB layout directives * added another net tie sheet * increased via hole/pad size per mfg. recommendation
    [array.SchDoc, clock.SchDoc, con-left-bot.SchDoc, con-left-top.SchDoc, con-right-bot.SchDoc, con-right-top.SchDoc, config.SchDoc, copper_suicide.PcbLib]
2016-09-08 * major schematic work to enable both point-to-point links between CFG and FGPAxx and also multiple multi-drop buses for shared memory and interrupts.
    [SIGNAL_LAB_14LAYERS_CS_Rev1_Meg6k_08122016.xls, array.SchDoc, con-left-bot.SchDoc, con-left-top.SchDoc, con-right-bot.SchDoc, con-right-top.SchDoc, config.SchDoc, cs_and_graviton_parts.xlsx]
2016-09-09 * finished schematic connection between MCU and FPGA
    [array.SchDoc, con-left-bot.SchDoc, con-left-top.SchDoc, con-right-bot.SchDoc, con-right-top.SchDoc, config.SchDoc, copper_suicide.PrjPCB, copper_suicide.SchLib]
2016-09-09 * adding JTAG connector to MCU
    [fpga.SchDoc, mcu.SchDoc, power-v2v5.SchDoc, power-v3v3.SchDoc, power-vddr.SchDoc]
2016-09-14 * finished wiring up fan
    [array.SchDoc, copper_suicide.PrjPCB, fans.SchDoc, flash.SchDoc, main.SchDoc, mcu-io.SchDoc, mcu.SchDoc, mechanical.SchDoc]
2016-09-15 * nightly commit * jtag complete * mcu pin mapping complete
    [con-left-bot.SchDoc, con-left-top.SchDoc, con-right-bot.SchDoc, con-right-top.SchDoc, copper_suicide.PrjPCB, fpga.SchDoc, jtag-buffer.SchDoc, main.SchDoc]
2016-09-16 * adding power budget
    [power_budget.xlsx]
2016-09-17 * added current/voltage monitor * nightly commit
    [con-left-bot.SchDoc, con-left-top.SchDoc, con-right-bot.SchDoc, con-right-top.SchDoc, fpga.SchDoc, main.SchDoc, mechanical.SchDoc, vio-buffer.SchDoc]
2016-09-23 * major cleanup * power supply review (not quite done)
    [array.SchDoc, config.SchDoc, copper_suicide.PrjPCB, fpga.SchDoc, main.SchDoc, mcu-io.SchDoc, mcu.SchDoc, power-v0v675.SchDoc]
2016-09-23 * nightly commit #2
    [array.SchDoc, clock.SchDoc, power_budget.xlsx, tie-il-cfg.SchDoc]
2016-09-24 * another commit from last night
    [array.SchDoc, copper_suicide.PrjPCB, fpga.SchDoc, mcu-io.SchDoc, power-v12.SchDoc, power_budget.xlsx, tie-il07-il07.SchDoc, tie-il12-il07.SchDoc]
2016-09-26 * fixed V12 power supply
    [power-v12.SchDoc]
2016-09-27 * nightly commit * BOM cleanup (still not done, and have not yet sync'd with PCB) * fixed 12V power supply
    [array.SchDoc, clock.SchDoc, con-left-bot.SchDoc, con-left-top.SchDoc, con-right-bot.SchDoc, con-right-top.SchDoc, config.SchDoc, copper_suicide.PrjPCB]
2016-09-27 * second nightly push (cleaned up sheet template)
    [array.SchDoc, clock.SchDoc, con-left-bot.SchDoc, con-left-top.SchDoc, con-right-bot.SchDoc, con-right-top.SchDoc, config.SchDoc, fans.SchDoc]
2016-09-28 * more BOM cleanup
    [clock.SchDoc, con-left-bot.SchDoc, con-left-top.SchDoc, con-right-bot.SchDoc, con-right-top.SchDoc, config.SchDoc, fans.SchDoc, flash.SchDoc]
2016-09-29 * commit to branch before merge to master
    [copper_suicide.PrjPCB]
2016-09-29 * directory cleanup
    [SIGNAL_LAB_14LAYERS_CS_Rev1_Meg6k_08122016.xls, cs_and_graviton_parts.xlsx, ecp5u85pinouts.xlsx, fpga-bank0.SchDoc, fpga-bank1.SchDoc, fpga-bank2.SchDoc, fpga-bank3.SchDoc, fpga-bank4.SchDoc]
2016-09-29 * removing unused files
    [LED8.SchDoc, clock-top.SchDoc, con-board-jtag.SchDoc, con-bot-j1-0.SchDoc, con-bot-j1-1.SchDoc, con-bot-j2-0.SchDoc, con-bot-j2-1.SchDoc, con-left.SchDoc]
2016-09-29 * adding docs
    [copper_suicide.PrjPCB]
2016-10-01 * nightly commit * schematic cleanup, power supply review
    [array.SchDoc, fpga.SchDoc, main.SchDoc, power-v0v675.SchDoc, power-v12.SchDoc, tie-flash-cfg.SchDoc, tie-il34-sdram.SchDoc]
2016-10-01 * updating power budget spreadsheet
    [power_budget.xlsx]
2016-10-03 * BOM cleanup almost done
    [array.SchDoc, clock.SchDoc, config.SchDoc, fans.SchDoc, flash.SchDoc, fpga.SchDoc, jtag-buffer.SchDoc, main.SchDoc]
2016-10-07 * more BOM cleanup * adding PDF schematic
    [clock.SchDoc, config.SchDoc, fans.SchDoc, flash.SchDoc, fpga.SchDoc, jtag-buffer.SchDoc, main.SchDoc, mcu-io.SchDoc]
2016-10-07 * config boot option cleanup
    [config.SchDoc, mcu.SchDoc, tie-flash-cfg.SchDoc]
2016-10-08 * lots of schematic cleanup
    [array.SchDoc, clock.SchDoc, con-left-bot.SchDoc, con-left-top.SchDoc, con-right-bot.SchDoc, con-right-top.SchDoc, config.SchDoc, fans.SchDoc]
2016-10-08 * first pass schematic review done! * working on component placement
    [clock.SchDoc, fpga-bank1.SchDoc, fpga.SchDoc, mcu.SchDoc, power-v12.SchDoc, reset.SchDoc, top.SchDoc]
2016-10-09 * commit right before I try to remove all the net ties
    [con-right-top.SchDoc, fpga-bank8.SchDoc, tie-il-cfg.SchDoc, tie-il07-il07.SchDoc, tie-il12-il07.SchDoc, tie-il12-il68.SchDoc, tie-il34-il07.SchDoc, tie-il68-il07.SchDoc]
2016-10-09 * more component placement * more schematic errors fixed * net ties removed
    [con-right-bot.SchDoc, con-right-top.SchDoc, copper_suicide.PrjPCB, flash.SchDoc, mcu-io.SchDoc, mcu.SchDoc, power-v1v35.SchDoc, power-v2v5.SchDoc]
2016-10-11 * routing 2.5V supply
    [power-v1v35.SchDoc, power-v2v5.SchDoc, power-v3v3.SchDoc]
2016-10-12 * 1.25V power supplies routed
    [copper_suicide.PrjPCB, mechanical.SchDoc]
2016-10-17 * commit to switch from laptop to desktop
2016-10-17 - all power supplies routed! woohoo!
2016-11-18 * moved GPMC bus to 3.3V to be compatible with Graviton * added extra test point for CFG00.WRITEN
    [config.SchDoc, fpga-bank8.SchDoc, tie-il-cfg.SchDoc]
2016-12-03 nightly commit
    [fpga-ground.SchDoc, fpga-misc.SchDoc, fpga-serdes.SchDoc, power_budget.xlsx, tie-il-cfg.SchDoc]
2016-12-17 * nightly commit, more routing complete
    [con-left-bot.SchDoc, con-left-top.SchDoc, con-right-bot.SchDoc, con-right-top.SchDoc, fpga-bank8.SchDoc, fpga.SchDoc, main.SchDoc, reset.SchDoc]
2016-12-19 * FPGA block routed...
    [array.SchDoc, fpga.SchDoc, sdram.SchDoc, tie-il07-il07.SchDoc, tie-il34-sdram.SchDoc]
2016-12-20 * all components on board
    [main.SchDoc]
2016-12-22 * seem to have all the FPGA rooms fixed and routed..
    [array.SchDoc, con-right-bot.SchDoc, con-right-top.SchDoc, copper_suicide.PcbLib, fpga-bank0.SchDoc, fpga-bank8.SchDoc, fpga.SchDoc, main.SchDoc]
2016-12-22 * put JTAG connectors back
2016-12-22 * added net classes for impedance control * more routing
    [clock.SchDoc, con-left-bot.SchDoc, con-left-top.SchDoc, con-right-bot.SchDoc, con-right-top.SchDoc, fpga.SchDoc, mcu-io.SchDoc, mcu.SchDoc]
2016-12-23 * I think all the net classes are entered * I think all the diff pair and single ended rules are working * more routing performed on SDRAM
    [copper_suicide.PrjPCB, fpga-bank8.SchDoc, sdram.SchDoc, tie-il34-sdram.SchDoc]
2016-12-25 * nightly commit, more SDRAM routing
    [sdram.SchDoc, tie-il34-sdram.SchDoc]
2016-12-29 * SDRAM routed except for DQS groups
    [tie-il34-sdram.SchDoc]
2016-12-29 * SDRAM routed. Length matching remaining.
    [tie-il34-sdram.SchDoc]
2016-12-29 * last nights commit, working on length matching for SDRAM
    [copper_suicide.PrjPCB, fpga-bank2.SchDoc, tie-il34-sdram.SchDoc]
2016-12-29 * SDRAM routed and length matched
    [copper_suicide.PrjPCB, tie-il34-sdram.SchDoc]
2016-12-31 * progress on tie-il34-il07 harness routing
    [copper_suicide.PrjPCB, tie-il34-sdram.SchDoc]
2016-12-31 routed MIB bus progress on tie-il34-il07 harness routing a little tare-up for planning purposes some schematic reorganization
    [array.SchDoc, con-right-bot.SchDoc, con-right-top.SchDoc, fpga-bank0.SchDoc, fpga.SchDoc, mcu.SchDoc, tie-il-cfg.SchDoc]
2017-01-01 good work on il07_02 harness, going to raise a glass for the new year
    [fpga-bank0.SchDoc]
2017-01-02 * il12-il07 bus completely routed and copied * all shorts removed
    [config.SchDoc, copper_suicide.PcbLib, power-v1v35.SchDoc, tie-il12-il07.SchDoc]
2017-01-03 progress on il07_12 harness routing
    [power-v12.SchDoc, tie-il68-il07.SchDoc]
2017-01-04 il07_12 bus DRC free and copied
    [copper_suicide.PrjPCB, fpga-bank8.SchDoc]
2017-01-05 adding missing file
    [tie-mib-imib.SchDoc]
2017-01-05 swizzled the MIB bus to reduce routing complexity some fpga power system routing more interconnect routing nightly commit
    [array.SchDoc, main.SchDoc, tie-mib-imib.SchDoc]
2017-01-07 something broken in flash page designators committing before beating the shit out of Altium
    [array.SchDoc, config.SchDoc, tie-il-cfg.SchDoc, tie-il07-il07.SchDoc]
2017-01-08 FMC bus routed
    [tie-il-cfg.SchDoc]
2017-01-08 il12_12 harness completely routed
    [fpga-bank8.SchDoc, tie-il12-il68.SchDoc]
2017-01-13 all clocks completely routed nightly commit
    [clock.SchDoc, copper_suicide.PrjPCB, copper_suicide.SchLib, mcu.SchDoc]
2017-01-18 fans routed changed option jumper style for JTAG turnaround and CLK select
    [array.SchDoc, clock.SchDoc, fans.SchDoc, main.SchDoc, reset.SchDoc, tie-flash-cfg.SchDoc]
2017-01-18 VTT power supplies routed
    [array.SchDoc, copper_suicide.PrjPCB, main.SchDoc, mcu.SchDoc, mechanical.SchDoc, reset.SchDoc, vio-sw.SchDoc]
2017-01-20 all fpga harnessed routed b2b connectors remaining
    [tie-il34-il07.SchDoc]
2017-02-03 finished routing harness 07_07 nightly commit
    [tie-il07-il07.SchDoc, tie-il12-il07.SchDoc]
2017-02-04 fixed connector pinout to match graviton nightly commit
    [con-left-bot.SchDoc, con-left-top.SchDoc, con-right-bot.SchDoc, con-right-top.SchDoc]
2017-02-05 altium routing issues on the il harnesses on the board-to-board connectors. I'm about to blast away the entire board netlist.
2017-02-07 fixed the width rule issue now trying to get pin swapping to work on the board-to-board connectors nightly commit
    [con-right-bot.SchDoc, con-right-top.SchDoc]
2017-02-08 all MIB buses routed!!
    [con-right-bot.SchDoc, con-right-top.SchDoc]
2017-02-08 fixed diff routing rule issue!!!
    [con-right-bot.SchDoc, con-right-top.SchDoc]
2017-02-12 adding original pinout file from lattice (annotated)
    [ecp5_85_pinout.xlsx]
2017-02-18 nightly commit added 12v power supply components
    [config.SchDoc, copper_suicide.PrjPCB, power-v12.SchDoc]
2017-02-19 fixed jtag voltage rail issue
    [jtag-buffer.SchDoc]
2017-02-20 nightly commit work on jtag
    [main.SchDoc, mcu.SchDoc, tie-flash-cfg.SchDoc]
2017-02-20 more jtag cleanup
    [array.SchDoc, copper_suicide.PrjPCB, fpga.SchDoc, jtag-buffer.SchDoc, main.SchDoc, mcu-io.SchDoc, mcu.SchDoc, mechanical.SchDoc]
2017-02-21 renaming schematic sheet
    [jtag-buffer.SchDoc, jtag-switch.SchDoc, main.SchDoc]
2017-02-21 sorted out jtag design maybe nightly commit
    [copper_suicide.PrjPCB, flash.SchDoc, jtag-switch.SchDoc, main.SchDoc]
2017-02-22 routed new 12V power supply
    [array.SchDoc, copper_suicide.PrjPCB, jtag-switch.SchDoc, main.SchDoc, mcu.SchDoc, power-v12.SchDoc]
2017-02-28 fixed all the compile issues seems to be an issue now on CFG bus (see ticket #18 ) more routing done on right side connectors
    [array.SchDoc, con-right-bot.SchDoc, con-right-top.SchDoc, config.SchDoc, copper_suicide.PcbLib, copper_suicide.PrjPCB, fpga-bank8.SchDoc, fpga.SchDoc]
2017-03-13 nightly commit added extra input capacitors to 48V per datasheet
    [power-v12.SchDoc, top.SchDoc]
2017-03-15 nightly commit dio2 and dio2 nets broken - needs fixing
    [array.SchDoc, config.SchDoc, fpga-bank8.SchDoc, mcu-io.SchDoc, power-v12.SchDoc, reset.SchDoc, tie-flash-cfg.SchDoc, tie-il-cfg.SchDoc]
2017-03-16 added new vtt power supply
    [power-v0v675.SchDoc, power-vtt.SchDoc]
2017-03-21 finished routing all clocks created graviton to cs mapping... still needs corresponding fpga pins
    [copper_suicide.PrjPCB, cs_to_graviton_pin_mapping.xlsx]
2017-03-29 adding missing files
    [power-v5.SchDoc]
2017-03-31 here goes nothing
    [array.SchDoc, clock.SchDoc, con-left-bot.SchDoc, con-left-top.SchDoc, con-right-bot.SchDoc, con-right-top.SchDoc, config.SchDoc, copper_suicide.PrjPCB]
2017-03-31 rearranging vtt
    [array.SchDoc, main.SchDoc, mechanical.SchDoc, tie-il-cfg.SchDoc, tie-il07-il07.SchDoc, tie-il12-il07.SchDoc, tie-il12-il68-top.SchDoc, tie-il12-il68.SchDoc]
2017-03-31 testing vtt and vcc net tie fix
    [array.SchDoc, copper_suicide.PrjPCB, main.SchDoc, mechanical.SchDoc, tie-flash-cfg.SchDoc, tie-il-cfg.SchDoc, tie-il07-il07.SchDoc, tie-il12-il07.SchDoc]
2017-03-31 fixing ddr vcc vtt
    [array.SchDoc, sdram.SchDoc, tie-il34-sdram.SchDoc]
2017-03-31 another vtt fix
    [array.SchDoc, copper_suicide.PrjPCB]
2017-03-31 imported changes to pcb
    [tie-il-cfg.SchDoc]
2017-03-31 editing comment
    [tie-il-cfg.SchDoc]
2017-04-03 alex end of weekend commit
    [con-left-bot.SchDoc, con-left-top.SchDoc, copper_suicide.PrjPCB]
2017-04-10 where alex left off
    [con-right-bot.SchDoc, con-right-top.SchDoc, copper_suicide.PrjPCB, tie-il-cfg.SchDoc]
2017-04-23 before cleaning up grounds
2017-04-23 removed all unnecessary copper traces
2017-04-24 no DRCs, BOM cleaned up. Going to rename a harness, backing up first.
    [array.SchDoc, clock.SchDoc, config.SchDoc, fans.SchDoc, flash.SchDoc, fpga-bank8.SchDoc, fpga.SchDoc, main.SchDoc]
2017-04-24 schematic harness rename done. save point before syncing with pcb.
    [array.SchDoc, con-left-bot.SchDoc, con-left-top.SchDoc, con-right-bot.SchDoc, con-right-top.SchDoc, fpga-bank0.SchDoc, fpga-bank1.SchDoc, fpga-bank2.SchDoc]
2017-04-24 looking good before reimporting 3d footprints
2017-04-24 basically ready for fab, but want to look over it a little more.
    [con-left-bot.SchDoc, con-left-top.SchDoc, con-right-bot.SchDoc, con-right-top.SchDoc]
2017-04-25 more silk screen and labeling cleanup
    [clock.SchDoc, con-left-bot.SchDoc, con-left-top.SchDoc, con-right-bot.SchDoc, con-right-top.SchDoc, config.SchDoc, copper_suicide.PcbLib, copper_suicide.PrjPCB]
2017-04-26 out to manufacturing
    [array.SchDoc, copper_suicide.PrjPCB, fpga.SchDoc, main.SchDoc, mcu-io.SchDoc, mcu.SchDoc, mechanical.SchDoc, tie-flash-cfg.SchDoc]
2017-05-22 renumbered schematic sheets added altium_to_excel.py
    [array.SchDoc, clock.SchDoc, con-left-bot.SchDoc, con-left-top.SchDoc, con-right-bot.SchDoc, con-right-top.SchDoc, config.SchDoc, copper_suicide.PrjPCB]
2017-05-28 adding files before tagging v1
    [cs_to_graviton_pin_mapping.xlsx]
2017-05-29 nightly commit. see github issues for progress.
    [array.SchDoc, clock.SchDoc, con-left-bot.SchDoc, con-left-top.SchDoc, con-right-bot.SchDoc, con-right-top.SchDoc, config.SchDoc, copper_suicide.PcbLib]
2017-05-30 all tickets closed in github provided no new issues arise board is ready for manufacturing
    [clock.SchDoc, config.SchDoc, copper_suicide.PrjPCB, fpga-bank0.SchDoc, fpga-bank1.SchDoc, fpga-bank3.SchDoc, fpga.SchDoc, main.SchDoc]
2017-05-31 nightly commit see github issues for details
    [config.SchDoc, fpga.SchDoc, main.SchDoc, tie-flash-cfg.SchDoc]
2017-06-01 adding PDF schematic
2017-06-12 about to reorganize schematics
    [SIGNAL_LAB_14LAYERS_CS_Rev1_Meg6k_08122016.xls, array.SchDoc, clock.SchDoc, con-left-bot.SchDoc, con-left-top.SchDoc, con-right-bot.SchDoc, con-right-top.SchDoc, config.SchDoc]
2017-06-16 I'm about to break it.. backing up first.
    [array.SchDoc, con-right-bot.SchDoc, con-right-top.SchDoc, copper_suicide.PrjPCB, flash.SchDoc, fpga-bank8.SchDoc, fpga.SchDoc, main.SchDoc]
2017-06-17 Rev. 2 as manufactured
    [170317-1_copper_suicide_to_graviton_match.xlsx, array.SchDoc, clock.SchDoc, con-left-bot.SchDoc, con-left-top.SchDoc, con-right-bot.SchDoc, con-right-top.SchDoc, config.SchDoc]
2017-06-19 changes to PCB based on EQ from PCB fabrication vendor
    [copper_suicide.PcbLib, copper_suicide.PrjPCB]
2017-07-04 fixed i2c netname issue
    [array.SchDoc, copper_suicide.PrjPCB, fpga-power.SchDoc, fpga.SchDoc]
2017-08-01 removed jtag b2b features
    [array.SchDoc, clock.SchDoc, con-left-bot.SchDoc, con-left-top.SchDoc, con-right-bot.SchDoc, con-right-top.SchDoc, config.SchDoc, copper_suicide.PrjPCB]
2017-08-01 saving before renaming harnesses again
    [array.SchDoc, copper_suicide.PcbLib]
2017-08-03 files send to fab needs some back annotation and BOM cleanup... don't forget to review DNP's!
2017-08-05 pushed to fab and assembly silk screen cleaned up schematics massively cleaned up
    [array.SchDoc, clock.SchDoc, con-left-bot.SchDoc, con-left-top.SchDoc, con-right-bot.SchDoc, con-right-top.SchDoc, config.SchDoc, copper_suicide.PrjPCB]
2017-08-14 schematic cleanup Copying parts from PcbDoc to PcbLib and SchLib to send them to Alex
    [array.SchDoc, clock.SchDoc, con-left-bot.SchDoc, con-left-top.SchDoc, con-right-bot.SchDoc, con-right-top.SchDoc, config.SchDoc, copper_suicide.PcbLib]
2017-08-21 made R85 DNP
    [mcu.SchDoc]
2017-08-22 updated schematic note regarding MCU BOOT pin pull-up
    [top.SchDoc]
2017-12-02 misc updates
    [mcu.SchDoc, top.SchDoc]
